enginebeat/TestBedUpgrade/photos/20170327_144511.jpg

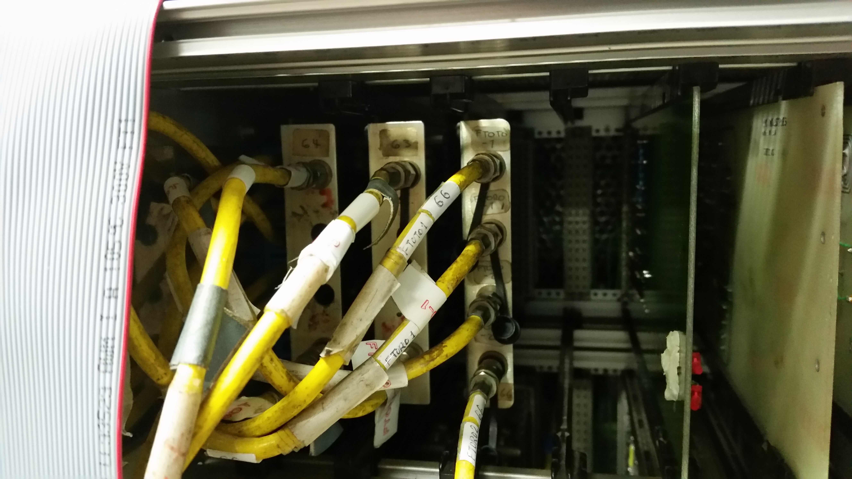
photos/20170327_144511.jpg
