enginebeat/TestBedUpgrade/photos/20170327_144552.jpg

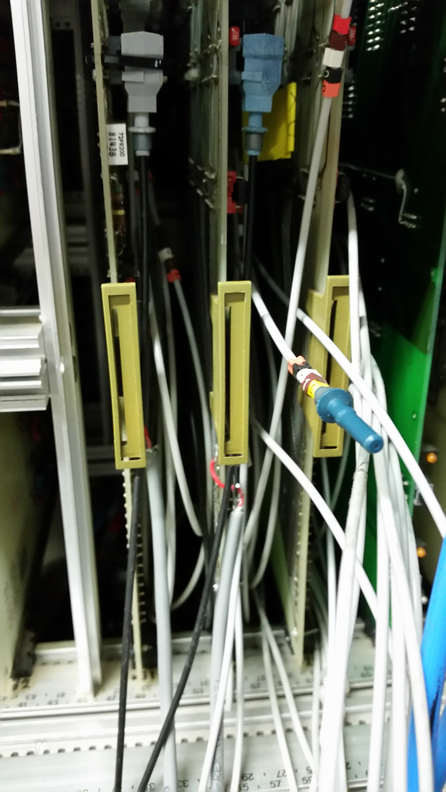
photos/20170327_144552.jpg
