enginebeat/TestBedUpgrade/Prot_unit_UNOR.docx

When powering up the protection unit's ground level electronics racks, one of the new cards got damaged by a short circuit in one of the ICs releasing some smoke. Note that this was a ELV short (24V) and as such this was not a personal safety issue or was a fire risk either.

Power to the electronics racks was turned off immediately and the
