enginebeat/TestBedUpgrade/Cards/EEL1/H85-24.pdf

## INTERNAL USE ONLY

JDN/H(85)24
Issue 1 - 17.08.87

The information contained in this document is of a nature confidential the JET project. It should not be communicated directly or indirectly to any person not identified in the warning box below or named on the distribution list at the end of the document, witout prior permission, which should be sought from the Publication Officer, JET Joint Undertaking, Abingdon, Oxon, OX14 3EA, UK

EEL1 CTS Optical Fan-out Sub-module User Guide

W Brewerton

TABLE OF CONTENTS

1. Introduction
2. Module Functions
3. Construction
4. Specification
5. Drawings

Distribution: K Fullard, SE Dorling, R Johnson, W Brewerton K1/0/40 file(s)

1. Introduction

There are 3 types of CODAS sub-module, ELE1, ELE2 for inclusion into user equipment. It is envisaged that they be used for triggering and driving local equipment from CTS signals.

2. Module Functions

The EEL1 is a quad electrical-optical converter. It has 4 independent electrical inputs which are converted to 4 optical outputs.

The optical output light emitting diodes are housed in SMA type bulkhead sockets which have to be provided with a bulkhead or front panel.

The board may be fitted with an F-connector, if desired, for all electrical connections.

3. Construction

The sub-module takes the form of a PCB 100 x 160mm. The module width is 10mm. Power and electrical input are through solder spill connections or through a F-connector, using rows b and Z, which may be mounted on the rear of the board. The optical output diodes mounted in SMA type bulkhead fittings are at the end of 200mm flying leads. These SMA type connectors must be mounted on a convenient bulkhead or front panel. The PCB is laid out in such a way that it may be cut into 4 individual channels, each one working independently.

4. Specification

Signal standards:

Optical output: CODAS type 43. Light = Logic 1
Electrical input: TTL, CODAS type 24. Logic 1 is a low voltage level CODAS type signals are specified in the CODAS handbook. section JCH 7.6

Power supply:

+5V ± 5%

5. Drawings

1729 (http://electrahost.jet.uk/elbin/docudraw?cmd=view&type=drawingdetails&drawing=1729) Component overlay

1705 (http://electrahost.jet.uk/elbin/docudraw?cmd=view&type=drawingdetails&drawing=1705) Circuit diagram

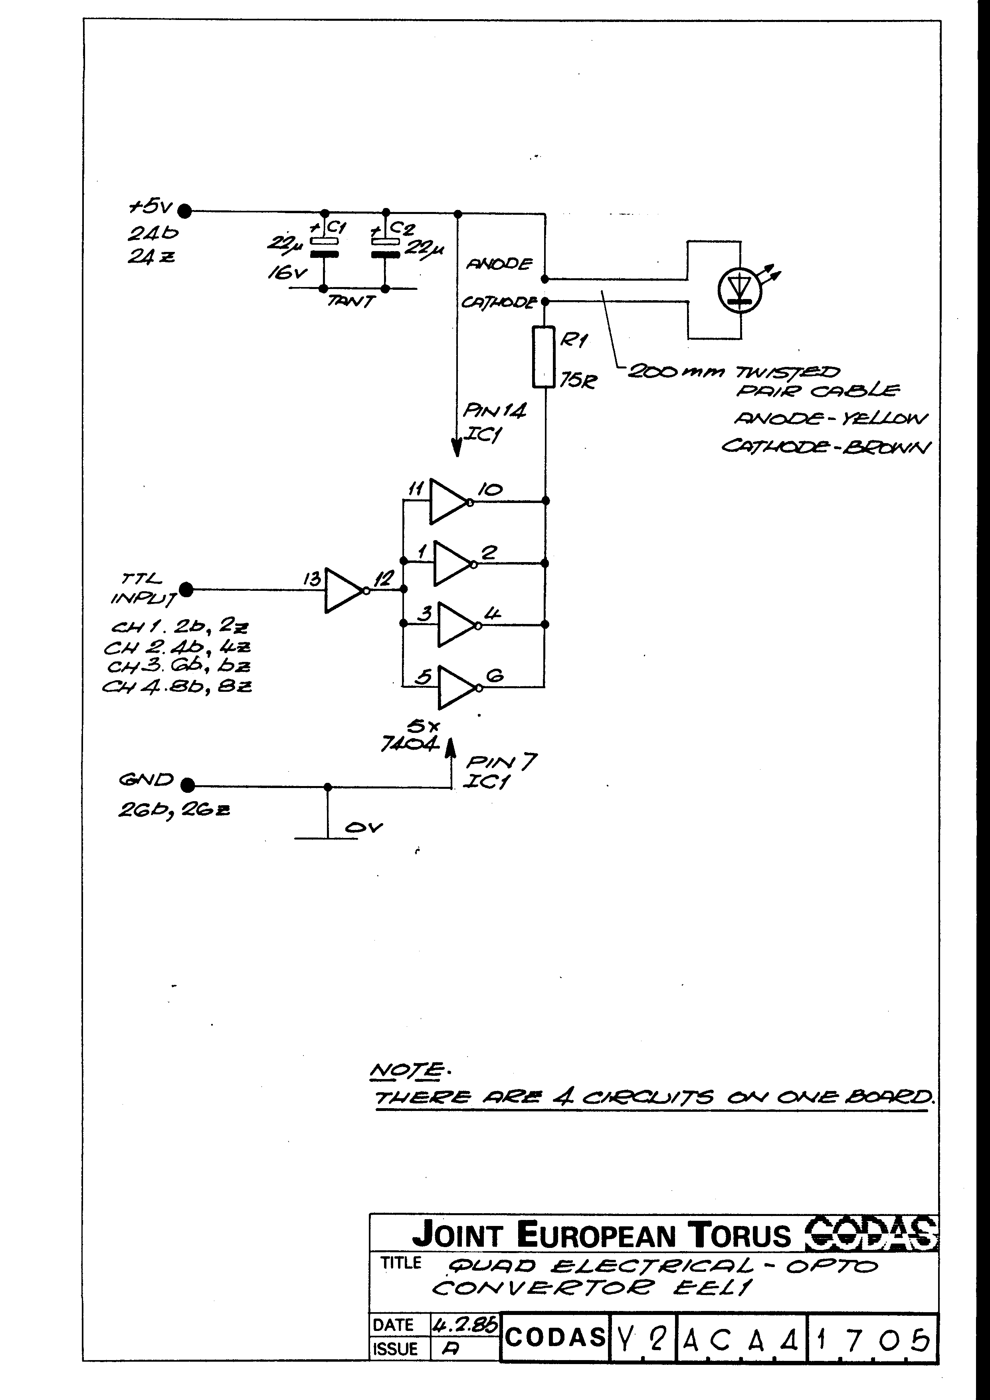
[picture p3: page 3]
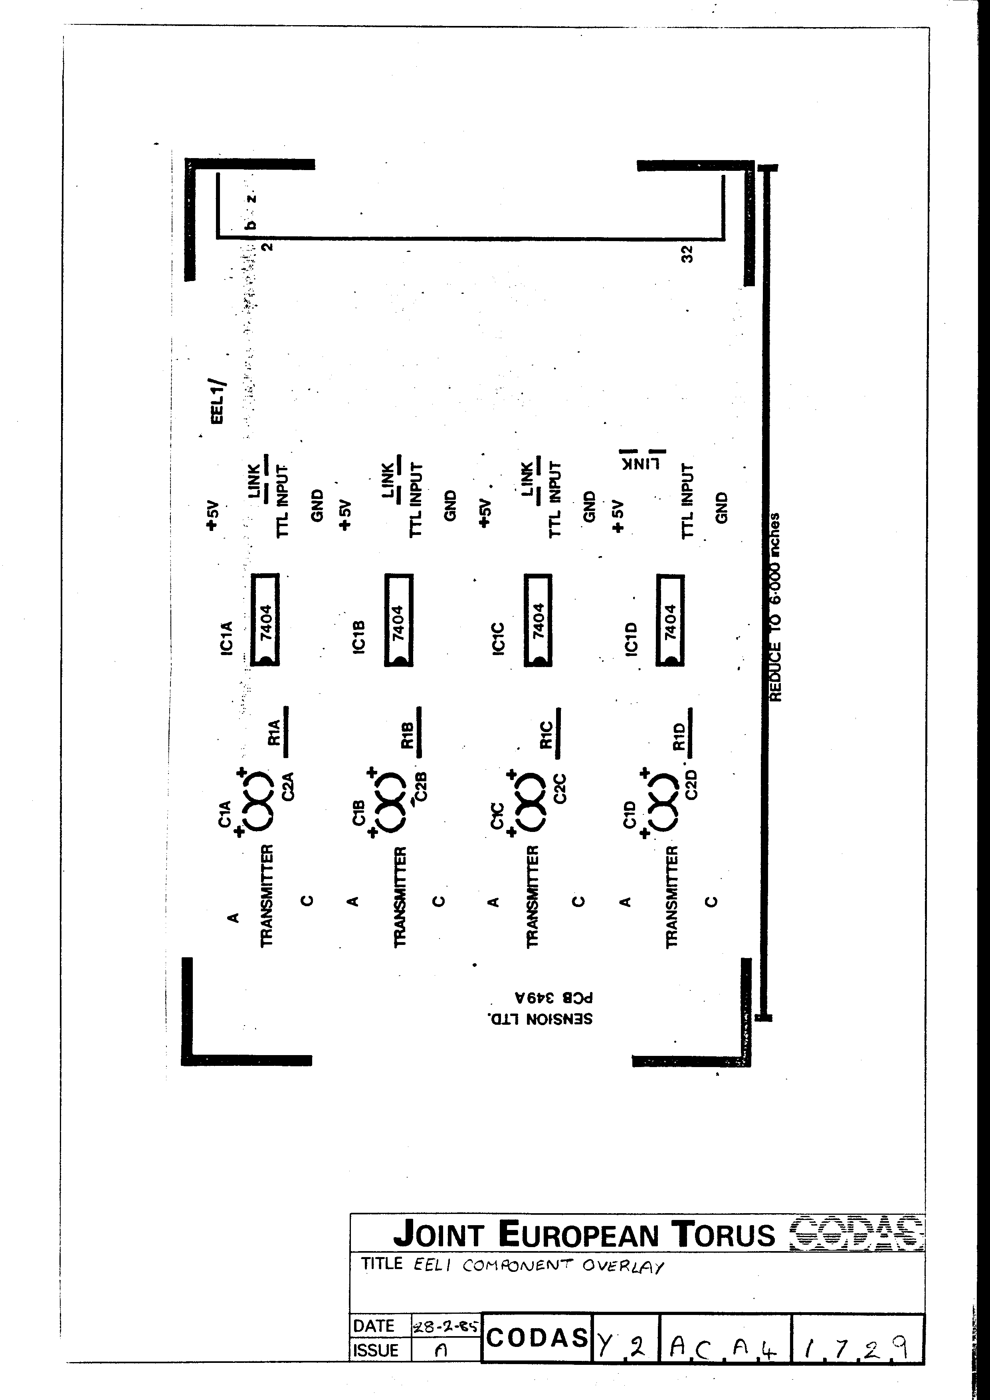
[picture p4: page 4]
