enginebeat/TestBedUpgrade/Cards/20 Channel FO Receiver - Glass.pdf

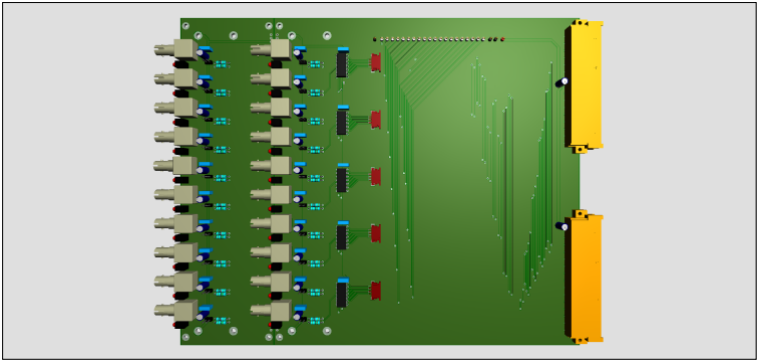
[picture p7: figure]
