enginebeat/TestBedUpgrade/Cards/20 Channel FO Receiver - Plastic.pdf

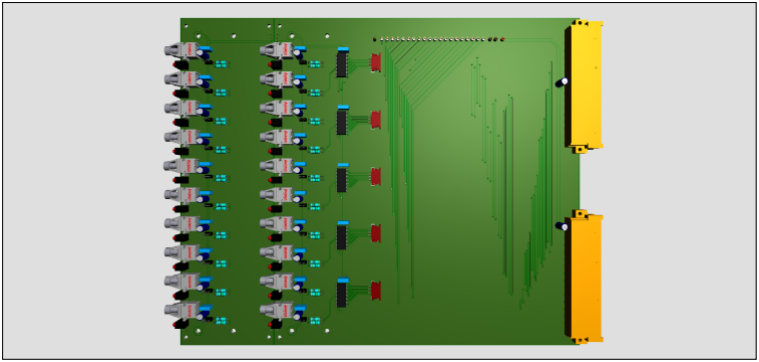
[picture p8: figure]
