enginebeat/TestBedUpgrade/Cards/20 Channel FO Transmitter - Glass.pdf

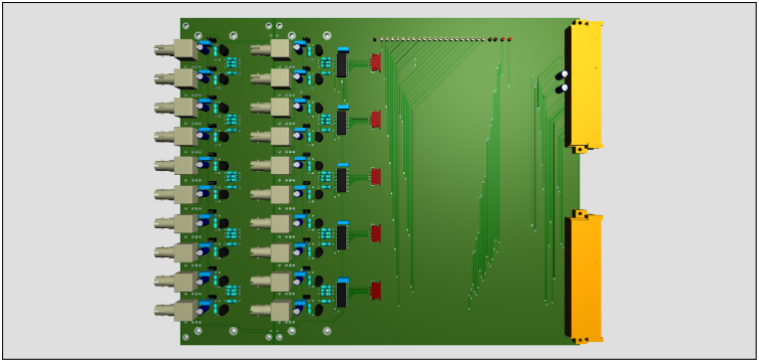
[picture p9: figure]
