enginebeat/TestBedUpgrade/Cards/20 Channel FO Transmitter - Plastic.pdf

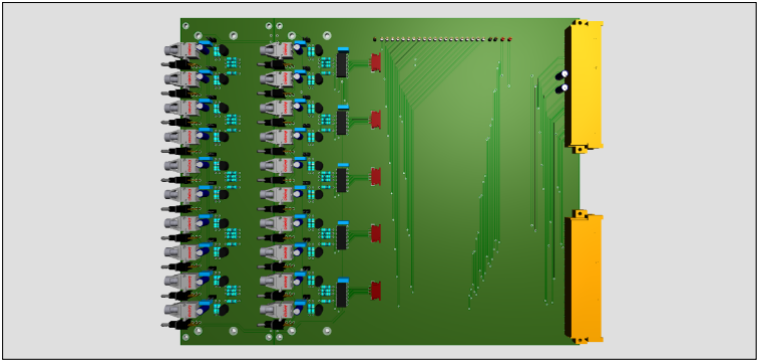
[picture p10: figure]
