enginebeat/TestBedUpgrade/CardRequirements.xls

Sheet: Overall
Card | Location | Rack | Unit | Type | Channels | Quantity | Mod
E276 | LCP | 8 |  | TX | 1 | 6 | remove IC7, remove link 1" and connect board to link 2"
E276 | Aux Deck | fil | A | TX | 1 | 1
E276 | Aux Deck | snub | A | TX | 1 | 1
E276 | Aux Deck | Arc | A | TX | 1 | 1
E276 | Aux Deck | fil | B | TX | 1 | 1
E276 | Aux Deck | snub | B | TX | 1 | 1
E276 | Aux Deck | Arc | B | TX | 1 | 1
 |  |  |  |  | Total | 12
E277 | LCP | 8 |  | RX | 1 | 6 | remove IC3, remove link 3 and connect board to link 2
E277 | Aux Deck | Fil | A | RX | 1 | 1
E277 | Aux Deck | snub | A | RX | 1 | 1
E277 | Aux Deck | Arc | A | RX | 1 | 1
E277 | Aux Deck | fil | B | RX | 1 | 1
E277 | Aux Deck | snub | B | RX | 1 | 1
E277 | Aux Deck | Arc | B | RX | 1 | 1
 |  |  |  |  | Total | 12
E284 | LCP | 2 | A | RX | 4 | 1 | remove 74LS123, connect Q and /Q to board.
E284 | LCP | 3 | B | RX | 4 | 1
E284 | Aux Deck | fil | A | RX | 2 | 1
E284 | Aux Deck | snub | A | RX | 1 | 1
E284 | Aux Deck | Arc | A | RX | 3 | 1
E284 | Aux Deck | fil | B | RX | 2 | 1
E284 | Aux Deck | snub | B | RX | 1 | 1
E284 | Aux Deck | Arc | B | RX | 3 | 1
 |  |  |  |  | Total | 8
E285 | Aux Deck | fil | A | TX | 2 | 1 | Remove IC1, remove IC7, feed from pin 9 of IC2 on all channels.
E285 | Aux Deck | snub | A | TX | 2 | 1
E285 | Aux Deck | Arc | A | TX | 2 | 1
E285 | Aux Deck | fil | B | TX | 2 | 1
E285 | Aux Deck | snub | B | TX | 2 | 1
E285 | Aux Deck | Arc | B | TX | 2 | 1
 |  |  |  |  | Total | 6
E291 | LCP | 2 | A | TX | 4 | 1 | remove IC3 & IC4, remove IC1, IC2, IC4,IC8 and connect all channels to new board.
E291 | LCP | 3 | B | TX | 4 | 1 | CH1 to CH4
E291 | Aux Deck | fil | A | TX | 1 | 1 | CH4
E291 | Aux Deck | snub | A | TX |  | 1 | Check CH
E291 | Aux Deck | Arc | A | TX | 1 | 1 | not used at present CH5
E291 | Aux Deck | fil | B | TX | 1 | 1 | CH4
E291 | Aux Deck | snub | B | TX |  | 1 | Check CH
E291 | Aux Deck | Arc | B | TX | 1 | 1 | not used at present CH5
 |  |  |  |  | Total | 8
E311 | LCP | 5 |  | TX | 1 | 2 | remove IC13, remove IC14 and connect IC15's pin 2 to new tx board.
E311 | LCP | 6 |  | TX | 1 | 2
E311 | LCP | 7 |  | TX | 1 | 2
 |  |  |  |  | Total | 6
E302 | LCP | 2 | A | RX | 2 | 1 | Needs Checking as we may have some new ones that work
E302 | LCP | 3 | B | RX | 2 | 1
E302 | LCP | 5 | Fil A/B | RX | 2 | 2
E302 | LCP | 6 | ARC A/B | RX | 2 | 2
E302 | LCP | 7 | Snub A/B | RX | 1 | 2
 |  |  |  |  | Total | 8
J101 | LCP | 2 | A | RX/TX | $1/1 | 1 | we should have some new ones
J101 | LCP | 3 | B | RX/TX | $1/1 | 1
J100 |  |  |  |  | Total | 2
J100 | Aux Deck |  | A | RX/TX | $1/1 | 1 | we should have some new ones
J100 | Aux Deck |  | B | RX/TX | $1/1 | 1
 |  |  |  |  | Total | 2

Sheet: Unit A
 |  | Unit A
Card | Location | Rack | Unit | Type | Channels | Quantity
E276 | LCP | 8 | A | TX | 1 | 3
E277 | LCP | 8 | A | RX | 1 | 3
E284 | LCP | 2 | A | RX | 4 | 1
E291 | LCP | 2 | A | TX | 4 | 1
E311 | LCP | 5 |  | TX | 1 | 1
E311 | LCP | 6 |  | TX | 1 | 1
E311 | LCP | 7 |  | TX | 1 | 1
E302 | LCP | 2 | A | RX | 2 | 1
E302 | LCP | 5 | Fil A | RX | 2 | 1
E302 | LCP | 6 | ARC A | RX | 2 | 1
E302 | LCP | 7 | Snub A | RX | 1 | 1
J101 | LCP | 2 | A | RX/TX | $1/1 | 1
E276 | Aux Deck | fil | A | TX | 1 | 1
E276 | Aux Deck | snub | A | TX | 1 | 1
E276 | Aux Deck | Arc | A | TX | 1 | 1
E277 | Aux Deck | Fil | A | RX | 1 | 1
E277 | Aux Deck | snub | A | RX | 1 | 1
E277 | Aux Deck | Arc | A | RX | 1 | 1
E284 | Aux Deck | fil | A | RX | 2 | 1
E284 | Aux Deck | snub | A | RX | 1 | 1
E284 | Aux Deck | Arc | A | RX | 3 | 1
E285 | Aux Deck | fil | A | TX | 2 | 1
E285 | Aux Deck | snub | A | TX | 2 | 1
E285 | Aux Deck | Arc | A | TX | 2 | 1
E291 | Aux Deck | fil | A | TX | 1 | 1
E291 | Aux Deck | snub | A | TX |  | 1
E291 | Aux Deck | Arc | A | TX | 1 | 1
J100 | Aux Deck |  | A | RX/TX | $1/1 | 1
E276 | 6
E277 | 6
E284 | 4
E285 | 3
E291 | 4
E311 | 3
E302 | 4
J101 | 1
J100 | 1

Sheet: Unit B
 |  | Unit B
Card | Location | Rack | Unit | Type | Channels | Quantity
E276 | LCP | 8 | B | TX | 1 | 3
E277 | LCP | 8 |  | RX | 1 | 3
E284 | LCP | 3 | B | RX | 4 | 1
E291 | LCP | 3 | B | TX | 4 | 1
E311 | LCP | 5 |  | TX | 1 | 1
E311 | LCP | 6 |  | TX | 1 | 1
E311 | LCP | 7 |  | TX | 1 | 1
E302 | LCP | 3 | B | RX | 2 | 1
E302 | LCP | 5 | Fil B | RX | 2 | 1
E302 | LCP | 6 | ARC B | RX | 2 | 1
E302 | LCP | 7 | Snub B | RX | 1 | 1
J101 | LCP | 3 | B | RX/TX | $1/1 | 1
E276 | Aux Deck | fil | B | TX | 1 | 1
E276 | Aux Deck | snub | B | TX | 1 | 1
E276 | Aux Deck | Arc | B | TX | 1 | 1
E277 | Aux Deck | fil | B | RX | 1 | 1
E277 | Aux Deck | snub | B | RX | 1 | 1
E277 | Aux Deck | Arc | B | RX | 1 | 1
E284 | Aux Deck | fil | B | RX | 2 | 1
E284 | Aux Deck | snub | B | RX | 1 | 1
E284 | Aux Deck | Arc | B | RX | 3 | 1
E285 | Aux Deck | fil | B | TX | 2 | 1
E285 | Aux Deck | snub | B | TX | 2 | 1
E285 | Aux Deck | Arc | B | TX | 2 | 1
E291 | Aux Deck | fil | B | TX | 1 | 1
E291 | Aux Deck | snub | B | TX |  | 1
E291 | Aux Deck | Arc | B | TX | 1 | 1
J100 | Aux Deck |  | B | RX/TX | $1/1 | 1
E276 | 6
E277 | 6
E284 | 4
E285 | 3
E291 | 4
E311 | 3
E302 | 4
J101 | 1
J100 | 1

Sheet: Cards
required total cards
E276 | 12
E277 | 12
E284 | 8
E285 | 6
E291 | 8
E311 | 6
E302 | 8
J101 | 2
J100 | 2

Sheet: Removed A
 |  | Unit A
Card | Type | Channels | Unit | Location | Rack | Position | Ref Number
E276 | TX | 1 | A | LCP | 8
E276 | TX | 1 | A | LCP | 8
E276 | TX | 1 | A | LCP | 8
E277 | RX | 1 | A | LCP | 8
E277 | RX | 1 | A | LCP | 8
E277 | RX | 1 | A | LCP | 8
E284 | RX | 4 | A | LCP | 2
E291 | TX | 4 | A | LCP | 2
E311 | TX | 1 | A | LCP | 5
E311 | TX | 1 | A | LCP | 6
E311 | TX | 1 | A | LCP | 7
E302 | RX | 2 | A | LCP | 2
E302 | RX | 2 | Fil A | LCP | 5
E302 | RX | 2 | ARC A | LCP | 6
E302 | RX | 1 | Snub A | LCP | 7
J101 | RX/TX | $1/1 | A | LCP | 2
E276 | TX | 1 | A | Aux Deck | fil
E276 | TX | 1 | A | Aux Deck | snub
E276 | TX | 1 | A | Aux Deck | Arc
E277 | RX | 1 | A | Aux Deck | Fil
E277 | RX | 1 | A | Aux Deck | snub
E277 | RX | 1 | A | Aux Deck | Arc
E284 | RX | 2 | A | Aux Deck | fil
E284 | RX | 1 | A | Aux Deck | snub
E284 | RX | 3 | A | Aux Deck | Arc
E285 | TX | 2 | A | Aux Deck | fil
E285 | TX | 2 | A | Aux Deck | snub
E285 | TX | 2 | A | Aux Deck | Arc
E291 | TX | 1 | A | Aux Deck | fil
E291 | TX |  | A | Aux Deck | snub
E291 | TX | 1 | A | Aux Deck | Arc
J100 | RX/TX | $1/1 | A | Aux Deck

Sheet: Removed B
 |  | Unit B
Card | Type | Channels | Unit | Location | Rack | Position | Ref Number
E276 | TX | 1 | B | LCP | 8
E276 | TX | 1 | B | LCP | 8
E276 | TX | 1 | B | LCP | 8
E277 | RX | 1 | B | LCP | 8
E277 | RX | 1 | B | LCP | 8
E277 | RX | 1 | B | LCP | 8
E284 | RX | 4 | B | LCP | 2
E291 | TX | 4 | B | LCP | 2
E311 | TX | 1 | B | LCP | 5
E311 | TX | 1 | B | LCP | 6
E311 | TX | 1 | B | LCP | 7
E302 | RX | 2 | B | LCP | 2
E302 | RX | 2 | Fil B | LCP | 5
E302 | RX | 2 | ARC B | LCP | 6
E302 | RX | 1 | Snub B | LCP | 7
J101 | RX/TX | $1/1 | B | LCP | 2
E276 | TX | 1 | B | Aux Deck | fil
E276 | TX | 1 | B | Aux Deck | snub
E276 | TX | 1 | B | Aux Deck | Arc
E277 | RX | 1 | B | Aux Deck | Fil
E277 | RX | 1 | B | Aux Deck | snub
E277 | RX | 1 | B | Aux Deck | Arc
E284 | RX | 2 | B | Aux Deck | fil
E284 | RX | 1 | B | Aux Deck | snub
E284 | RX | 3 | B | Aux Deck | Arc
E285 | TX | 2 | B | Aux Deck | fil
E285 | TX | 2 | B | Aux Deck | snub
E285 | TX | 2 | B | Aux Deck | Arc
E291 | TX | 1 | B | Aux Deck | fil
E291 | TX |  | B | Aux Deck | snub
E291 | TX | 1 | B | Aux Deck | Arc
J100 | RX/TX | $1/1 | B | Aux Deck
