enginebeat/TestBedUpgrade/Cards/E276_Old.pdf

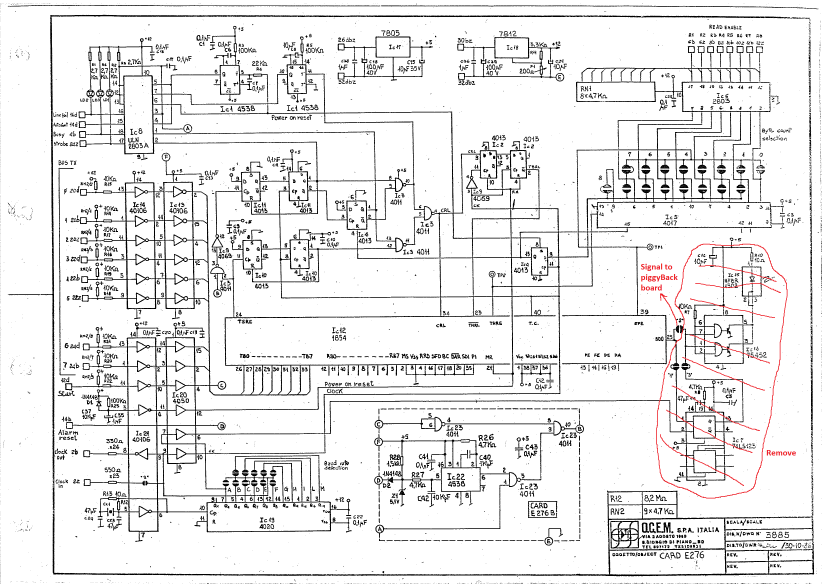
[picture p11: page 1]
