enginebeat/TestBedUpgrade/Cards/E277A_Old.pdf

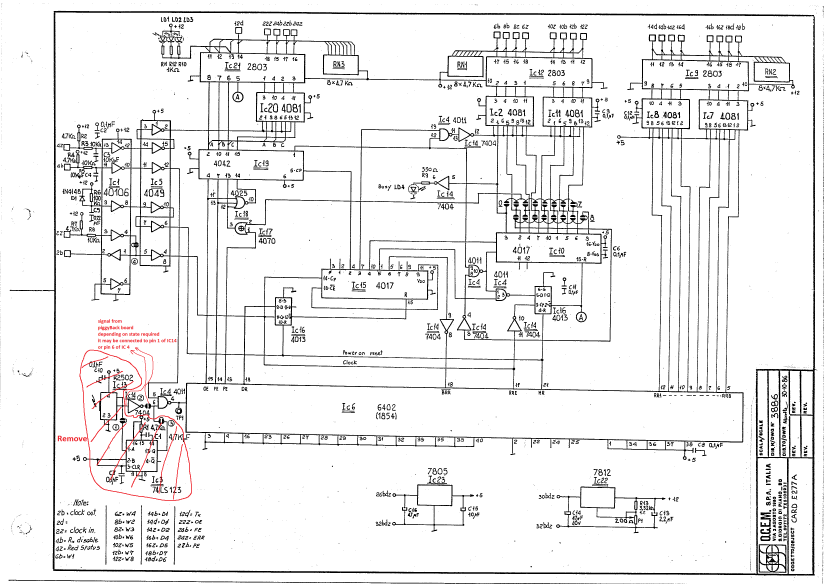
[picture p12: page 1]
