enginebeat/TestBedUpgrade/Cards/E311_ARC.TIF

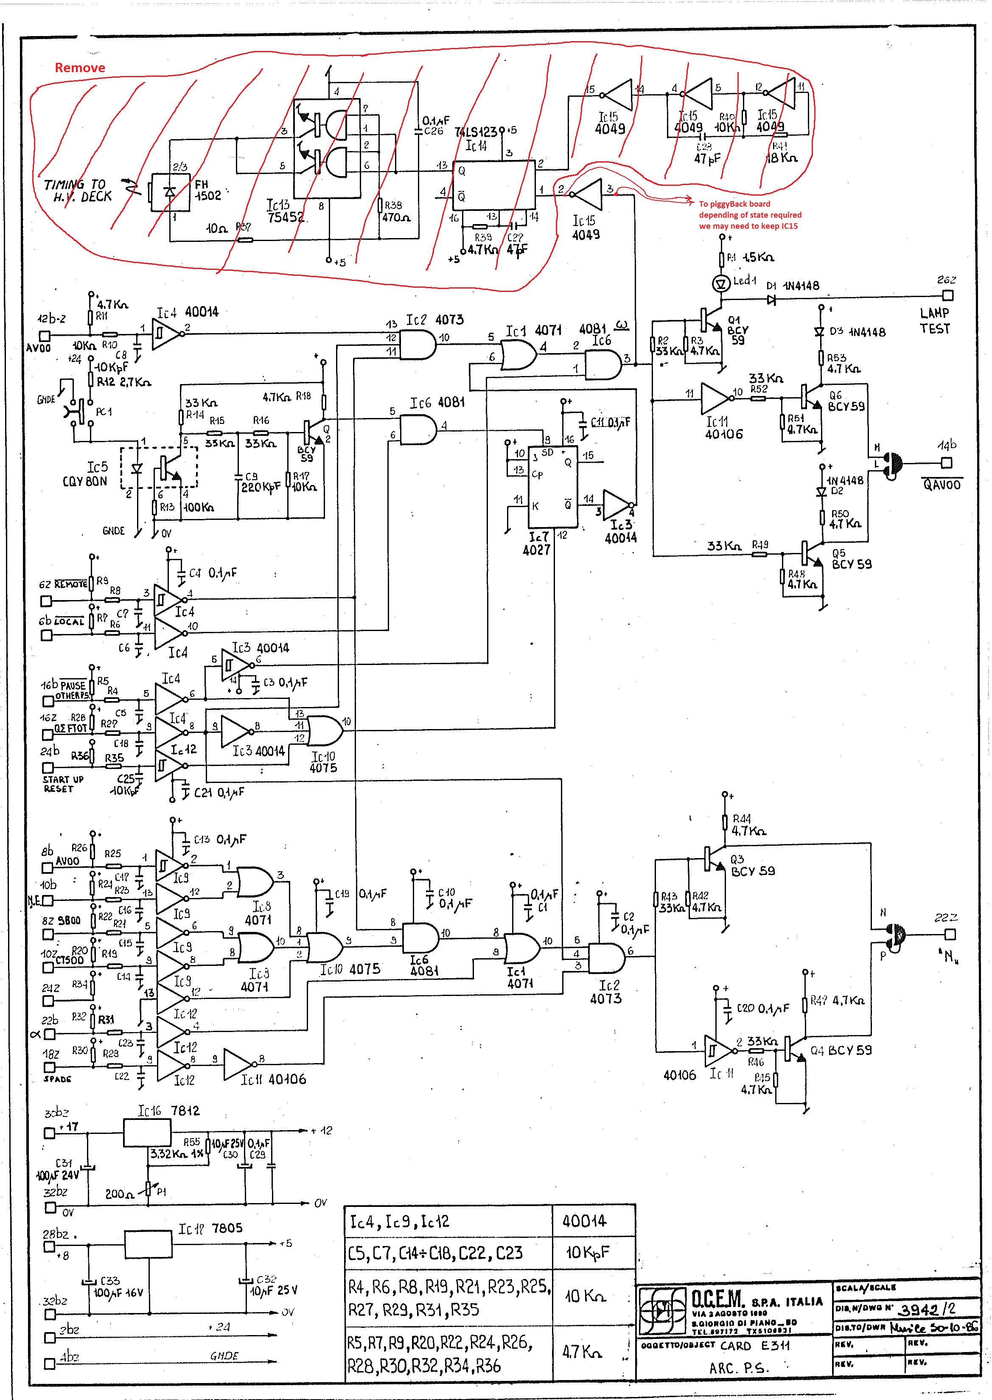
Cards/E311_ARC.TIF
