enginebeat/TestBedUpgrade/Cards/E320/frontPlate.jpg

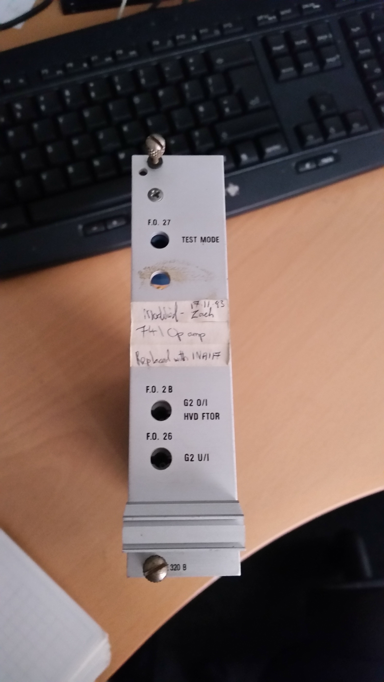
Cards/E320/frontPlate.jpg
