enginebeat/TestBedUpgrade/Cards/E320/mods.jpg

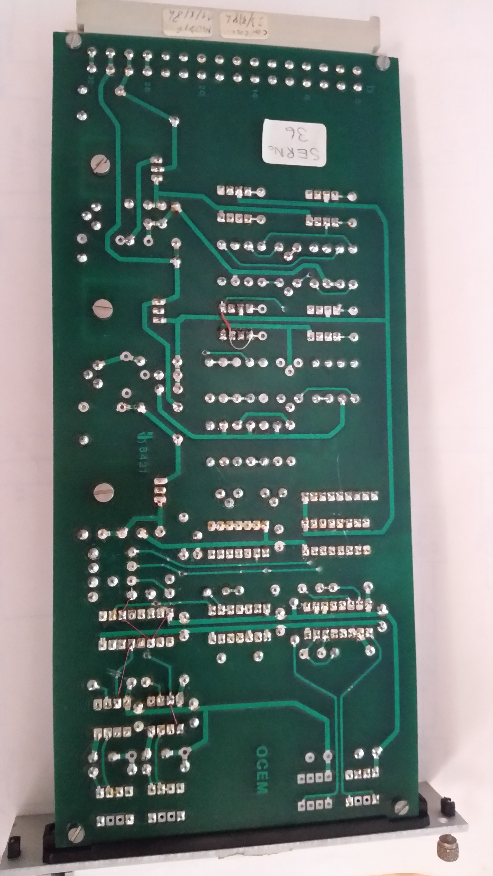
Cards/E320/mods.jpg
