enginebeat/TestBedUpgrade/Cards/images/75452_intern.png

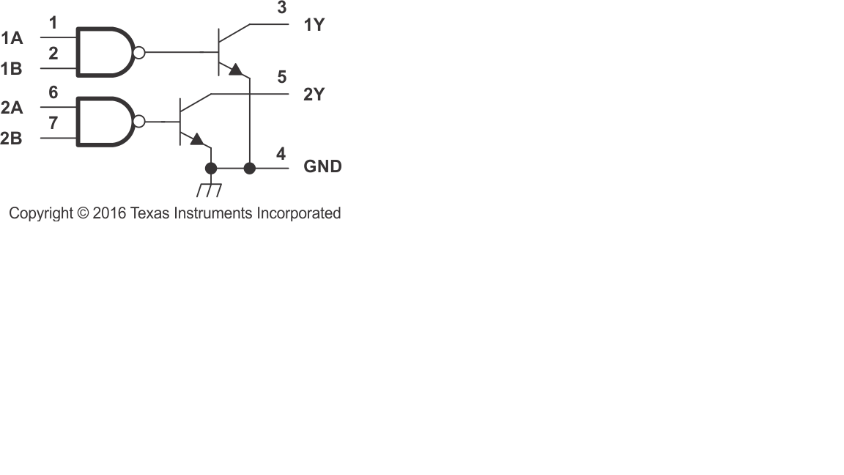
Cards/images/75452_intern.png
