enginebeat/TestBedUpgrade/photos/20170327_144520.jpg

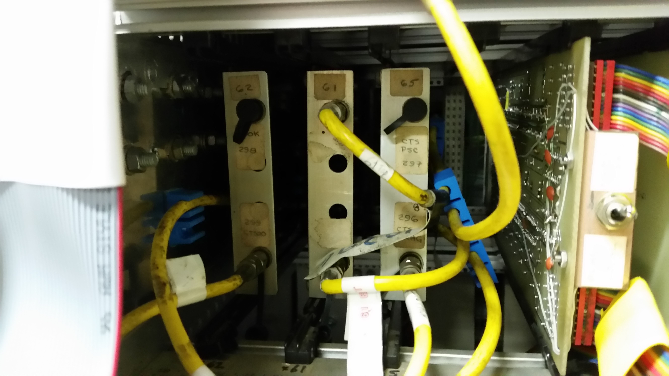
photos/20170327_144520.jpg
