enginebeat/TestBedUpgrade/photos/20170327_144530.jpg

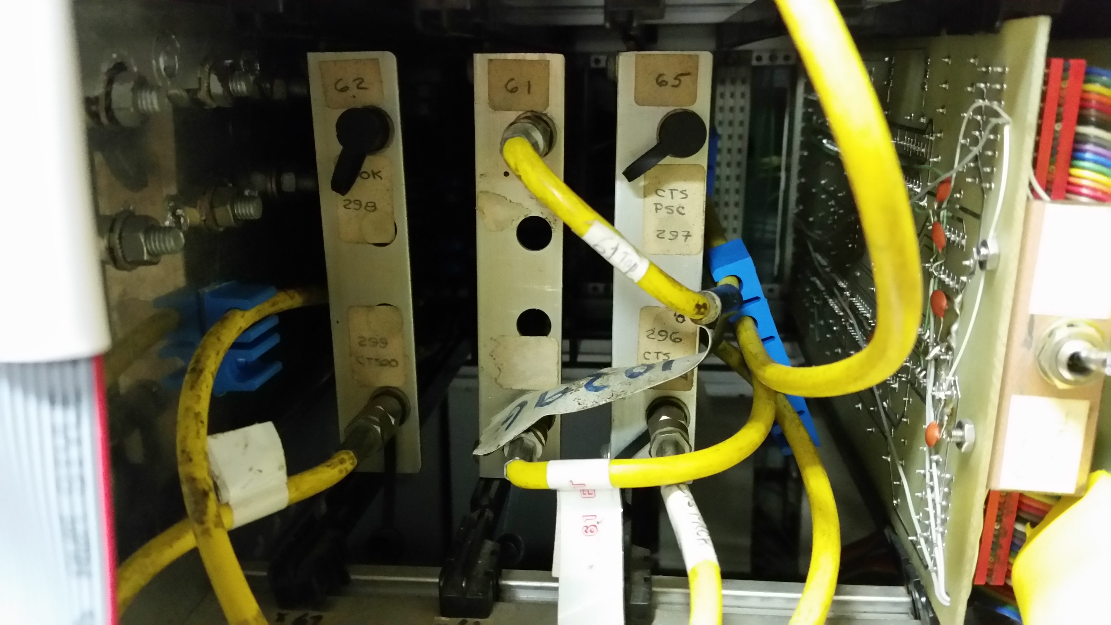
photos/20170327_144530.jpg
