enginebeat/TestBedUpgrade/photos/20170327_144611.jpg

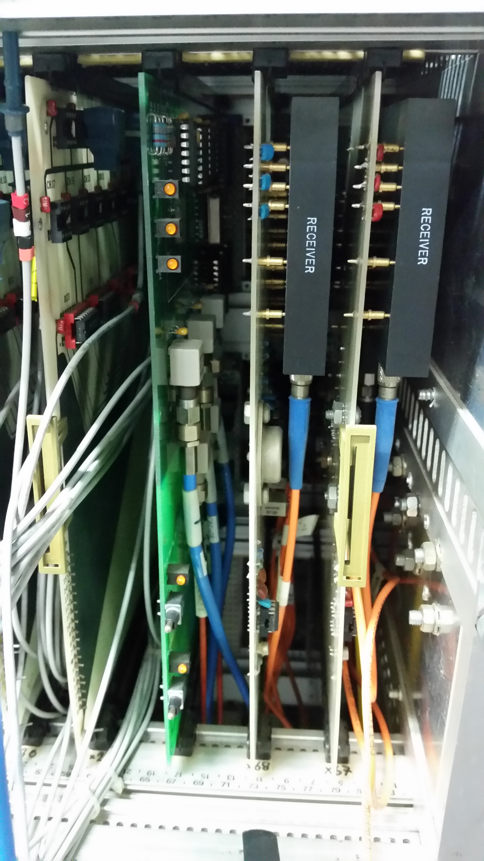
photos/20170327_144611.jpg
