enginebeat/TestBedUpgrade/FibreOp Modified Matrix 27-07-17.xlsx

Sheet: FDB Layout
 | Description | Number of fibres
FDB1 | LCP1 connections | 48
FDB2 | LCP2 connections | 48
FDB3 | Deck 1 + Deck 2 connections | 48
FDB4 | Common Deck 1 + Common Deck 2 | 32
FDB5 | Aux Deck A connections | 32
FDB6 | Aux Deck B connections | 32

Sheet: Patch Panels Ref
Location | Patch panel reference
LCP | LCP1
LCP | LCP2
Aux Deck A | ADA1
Aux Deck A | ADA1
Aux Deck B | ADB1
Aux Deck B | ADB2
prot ground level | see FDB Layout
prot HV deck 1 | HVD1
prot HV deck 2 | HVD2
prot Common deck 1 | COM1
prot Common deck 2 | COM2

Sheet: Aux Control A
Signal | Type | Card | Chan | rack | cubicle | PC | PP | Con | PP | con | PC | PP | con | PP | con | PC | Cubicle | Card | Chan
HVD A-FTORI | Input | E284 | 1 | 2 | LCP | 1 | LCP1 | 1 | FDB1 | 1 | 1 | FDB5 | 1 | ADA1 | 1 | 1 | G2 | ? | ?
HVD A-FTOTI | Input | E284 | 2 | 2 | LCP | 2 | LCP1 | 2 | FDB1 | 2 | 2 | FDB5 | 2 | ADA1 | 2 | 2 | FIL | E291 | 4
G3 A-FTOTI | Input | E284 | 3 | 2 | LCP | 3 | LCP1 | 3 | FDB1 | 3 | 3 |  |  |  |  |  | G3 | E291
G3 A-FTORI | Input | E284 | 4 | 2 | LCP | 4 | LCP1 | 4 | FDB1 | 4 | 4 |  |  |  |  |  | G3 | E291
HVD A-FTOTO | Output | E291 | 1 | 2 | LCP | 5 | LCP1 | 5 | FDB1 | 5 | 5 | FDB5 | 3 | ADA1 | 3 | 3 | FIL | E284 | 6
HVD A-FTORO | Output | E291 | 2 | 2 | LCP | 6 | LCP1 | 6 | FDB1 | 6 | 6 | FDB5 | 4 | ADA1 | 4 | 4 | ARC | E284 | 5
G3 A-FTOTO | Output | E291 | 3 | 2 | LCP | 7 | LCP1 | 7 | FDB1 | 7 | 7 |  |  |  |  |  | G3 | E284
G3 A-FTORO | Output | E291 | 4 | 2 | LCP | 8 | LCP1 | 8 | FDB1 | 8 | 8 |  |  |  |  |  | G3 | E284
Inter_ITCB-A | Input | JE101 | 1 | 2 | LCP | 9 | LCP1 | 9 | FDB1 | 9 | 9 | FDB5 | 5 | ADA1 | 5 | 5 | ARC | J100 | 1
Interrogate A | Output | JE101 | 2 | 2 | LCP | 10 | LCP1 | 10 | FDB1 | 10 | 10 | FDB5 | 6 | ADA1 | 6 | 6 | ARC | J100 | 2
FV00 A | Output | E311 | 1 | 5 | LCP | 11 | LCP1 | 11 | FDB1 | 11 | 11 | FDB5 | 7 | ADA1 | 7 | 7 | FIL | 284 | 5
AV00 A | Output | E311 | 1 | 6 | LCP | 12 | LCP1 | 12 | FDB1 | 12 | 12 | FDB5 | 8 | ADA1 | 8 | 8 | ARC | 284 | 4
SB00 A | Output | E311 | 1 | 7 | LCP | 13 | LCP1 | 31 | FDB1 | 31 | 13 | FDB5 | 9 | ADA1 | 9 | 9 | SNUB | 284 | 4
SB A TX | Output | E276 | 1 | 8 | LCP | 14 | LCP1 | 14 | FDB1 | 14 | 14 | FDB5 | 10 | ADA1 | 10 | 10 | SNUB | E277 | 1
SB A RX | Input | E277 | 1 | 8 | LCP | 15 | LCP1 | 15 | FDB1 | 15 | 15 | FDB5 | 11 | ADA1 | 11 | 11 | SNUB | E276 | 1
ARC A TX | Output | E276 | 1 | 8 | LCP | 16 | LCP1 | 16 | FDB1 | 16 | 16 | FDB5 | 12 | ADA1 | 12 | 12 | ARC | E277 | 1
ARC A RX | Input | E277 | 1 | 8 | LCP | 17 | LCP1 | 17 | FDB1 | 17 | 17 | FDB5 | 13 | ADA2 | 13 | 13 | ARC | E276 | 1
FIL A TX | Output | E276 | 1 | 8 | LCP | 18 | LCP1 | 18 | FDB1 | 18 | 18 | FDB5 | 14 | ADA2 | 14 | 14 | FIL | 277 | 1
FIL A RX | Input | E277 | 1 | 8 | LCP | 19 | LCP1 | 19 | FDB1 | 19 | 19 | FDB5 | 15 | ADA2 | 15 | 15 | FIL | 276 | 1

Sheet: Aux Control B
Signal | Type | Card | Chan | rack | cubicle | PC | PP | Con | PP | con | PC | PP | con | PP | con | PC | Cubicle | Card | Chan
HVD B-FTORI | Input | E284 | 1 | 3 | LCP | 31 | LCP2 | 1 | FDB2 | 1 |  | FDB6 | 1 | ADB1 | 1 |  |  | ? | ?
HVD B-FTOTI | Input | E284 | 2 | 3 | LCP | 32 | LCP2 | 2 | FDB2 | 2 |  | FDB6 | 2 | ADB1 | 2 |  | FIL | E291 | 4
G3 B-FTOTI | Input | E284 | 3 | 3 | LCP | 33 | LCP2 | 3 | FDB2 | 3 |  |  |  |  |  |  | G3 | E291
G3 B-FTORI | Input | E284 | 4 | 3 | LCP | 34 | LCP2 | 4 | FDB2 | 4 |  |  |  |  |  |  | G3 | E291
HVD B-FTOTO | Output | E291 | 1 | 3 | LCP | 35 | LCP2 | 5 | FDB2 | 5 |  | FDB6 | 5 | ADB1 | 5 |  | FIL | E284 | 6
HVD B-FTORO | Output | E291 | 2 | 3 | LCP | 36 | LCP2 | 6 | FDB2 | 6 |  | FDB6 | 6 | ADB1 | 6 |  | ARC | E284 | 5
G3 B-FTOTO | Output | E291 | 3 | 3 | LCP | 37 | LCP2 | 7 | FDB2 | 7 |  |  |  |  |  |  | G3 | E284
G3 B-FTORO | Output | E291 | 4 | 3 | LCP | 38 | LCP2 | 8 | FDB2 | 8 |  |  |  |  |  |  | G3 | E284
Interl_ITCB-B | Input | JE101 | 1 | 2 | LCP | 39 | LCP2 | 9 | FDB2 | 9 |  | FDB6 | 9 | ADB1 | 9 |  | ARC | J100 | 1
Interrogate-B | Output | JE101 | 2 | 2 | LCP | 40 | LCP2 | 10 | FDB2 | 10 |  | FDB6 | 10 | ADB1 | 10 |  | ARC | J100 | 2
FV00 B | Output | E311 | 1 | 5 | LCP | 41 | LCP2 | 11 | FDB2 | 11 |  | FDB6 | 11 | ADB1 | 11 |  | FIL | 284 | 5
AV00 B | Output | E311 | 1 | 6 | LCP | 42 | LCP2 | 12 | FDB2 | 12 |  | FDB6 | 12 | ADB1 | 12 |  | ARC | 284 | 4
SB00 B | Output | E311 | 1 | 7 | LCP | 43 | LCP2 | 13 | FDB2 | 13 |  | FDB6 | 13 | ADB1 | 13 |  | SNUB | 284 | 4
SB B TX | Output | E276 | 1 | 8 | LCP | 44 | LCP2 | 14 | FDB2 | 14 |  | FDB6 | 14 | ADB1 | 14 |  | SNUB | E277 | 1
SB B RX | Input | E277 | 1 | 8 | LCP | 45 | LCP2 | 15 | FDB2 | 15 |  | FDB6 | 15 | ADB1 | 15 |  | SNUB | E276 | 1
ARC B TX | Output | E276 | 1 | 8 | LCP | 46 | LCP2 | 16 | FDB2 | 16 |  | FDB6 | 16 | ADB1 | 16 |  | ARC | E277 | 1
ARC B RX | Input | E277 | 1 | 8 | LCP | 47 | LCP2 | 17 | FDB2 | 17 |  | FDB6 | 17 | ADB2 | 1 |  | ARC | E276 | 1
FIL B TX | Output | E276 | 1 | 8 | LCP | 48 | LCP2 | 18 | FDB2 | 18 |  | FDB6 | 18 | ADB2 | 2 |  | FIL | 277 | 1
FIL B RX | Input | E277 | 1 | 8 | LCP | 49 | LCP2 | 19 | FDB2 | 19 |  | FDB6 | 19 | ADB2 | 3 |  | FIL | 276 | 1

Sheet: Aux Monitor A
Signal | Type | Card | Chan | rack | cubicle | PC | PP | Con | PP | con | PC | PP | con | PP | con | PC | Cubicle | Card | Chan
G2-I 1 | Input | E312 | 1 | 2 | LCP | 20 | LCP1 | 20 | FDB1 | 20 | 20 | FDB5 | 20 | ADA1 | 16 | 16 | G2 | ? | ?
G1-I 1 | Input | E312 | 2 | 2 | LCP | 21 | LCP1 | 21 | FDB1 | 21 | 21 | FDB5 | 21 | ADA2 | 1 | 17 | SNUB | E285 | 2
FIL I A | Input | E302 | 1 | 5 | LCP | 22 | LCP1 | 22 | FDB1 | 22 | 22 | FDB5 | 22 | ADA2 | 2 | 18 | FIL | E285 | 2
Fil V A | Input | E302 | 2 | 5 | LCP | 23 | LCP1 | 23 | FDB1 | 23 | 23 | FDB5 | 23 | ADA2 | 3 | 19 | FIL | E285 | 1
ARC I A | Input | E302 | 1 | 6 | LCP | 24 | LCP1 | 24 | FDB1 | 24 | 24 | FDB5 | 24 | ADA2 | 4 | 20 | ARC | E285 | 2
ARC V A | Input | E302 | 2 | 6 | LCP | 25 | LCP1 | 25 | FDB1 | 25 | 25 | FDB5 | 25 | ADA2 | 5 | 21 | ARC | E285 | 1
Snub I A | Input | E302 | 1 | 7 | LCP | 26 | LCP1 | 26 | FDB1 | 26 | 26 | FDB5 | 26 | ADA2 | 6 | 22 | SNUB | E285 | 1

Sheet: Aux Monitor B
Signal | Type | Card | Chan | rack | cubicle | PC | PP | Con | PP | con | PC | PP | con | PP | con | PC | Cubicle | Card | Chan
G2-I 2 | Input | E312 | 1 | 3 | LCP | 50 | LCP2 | 20 | FDB2 | 20 |  | FDB6 | 20 | ADB2 | 4 |  | G2 | ? | ?
G1-I 2 | Input | E312 | 2 | 3 | LCP | 51 | LCP2 | 21 | FDB2 | 21 |  | FDB6 | 21 | ADB2 | 5 |  | SNUB | E285 | 2
FIL I B | Input | E302 | 1 | 5 | LCP | 52 | LCP2 | 22 | FDB2 | 22 |  | FDB6 | 22 | ADB2 | 6 |  | FIL | E285 | 2
Fil V B | Input | E302 | 2 | 5 | LCP | 53 | LCP2 | 23 | FDB2 | 23 |  | FDB6 | 23 | ADB2 | 7 |  | FIL | E285 | 1
ARC I B | Input | E302 | 1 | 6 | LCP | 54 | LCP2 | 24 | FDB2 | 24 |  | FDB6 | 24 | ADB2 | 8 |  | ARC | E285 | 2
ARC V B | Input | E302 | 2 | 6 | LCP | 55 | LCP2 | 25 | FDB2 | 25 |  | FDB6 | 25 | ADB2 | 9 |  | ARC | E285 | 1
Snub I B | Input | E302 | 1 | 7 | LCP | 56 | LCP2 | 26 | FDB2 | 26 |  | FDB6 | 26 | ADB2 | 10 |  | SNUB | E285 | 1

Sheet: Prot Ground
Signal | Type | Card | Chan | rack | cubicle | PC | PP | Con | PP | con | PC | Cubicle | Card | Chan
FTOTI 1-1 | Input | X63 | 1 | GND | Prot | 1 | FDB1 | 27 | LCP1 | 27 | 27 | LCP | UEL4 | 1
FTOTI 1-2 | Input | X63 | 2 | GND | Prot | 2 | FDB1 | 28 | LCP1 | 28 | 28 | LCP | UEL4 | 2
FTORI 2 | Input | X64 | 1 | GND | Prot | 3 | FDB1 | 29 | LCP1 | 29 | 29 | LCP | UEL4 | 3
FTOTI 2-2 | Input | X64 | 2 | GND | Prot | 4 | FDB1 | 30 | LCP1 | 30 | 30 | LCP | UEL4 | 4
FTOTO 1 | Output | X66 | 1 | GND | Prot | 5 | FDB1 | 32 | LCP1 | 32 | 31 | LCP | ULE3 | 1
FTORO 1 | Output | X66 | 2 | GND | Prot | 6 | FDB1 | 33 | LCP1 | 33 | 32 | LCP | ULE3 | 2
FTOTO 2 | Output | X66 | 3 | GND | Prot | 7 | FDB1 | 34 | LCP1 | 34 | 33 | LCP | ULE3 | 3
FTORO 2 | Output | X66 | 4 | GND | Prot | 8 | FDB1 | 35 | LCP1 | 35 | 34 | LCP | ULE3 | 4
FTORI 1 | Input | X61 | 1 | GND | Prot | 9 | FDB1 | 36 | LCP1 | 36 | 35 | CODAS |  | Y10296
FTOTI 2-1 | Input | X61 | 2 | GND | Prot | 10 | FDB1 | 37 | LCP1 | 37 | 36 | CODAS |  | Y10300
PDOK | Input | X62 | 1 | GND | Prot | 11 | FDB1 | 38 | LCP1 | 38 | 37 | CODAS
CTS00 | Input | X62 | 2 | GND | Prot | 12 | FDB1 | 39 | LCP1 | 39 | 38 | CODAS
CTSPSC | Input | X65 | 1 | GND | Prot | 13 | FDB1 | 40 | LCP1 | 40 | 39 | CODAS
CTSPRCHG | Input | X65 | 2 | GND | Prot | 14 | FDB1 | 41 | LCP1 | 41 | 40 | CODAS
Data 1 | Output | X31 | 1 | GND | Prot | 15 | FDB3 | 48 | HVD1 | 1 | 1 | HVD 1 | X22 | 7
/safe | Output | X31 | 7 | GND | Prot | 16 | FDB3 | 47 | HVD1 | 2 | 2 | HVD 1 | X22 | 6
/FTORI 1 | Output | X31 | 5 | GND | Prot | 17 | FDB3 | 46 | HVD1 | 3 | 3 | HVD 1 | X22 | 4
JET PLS 1 | Output | X31 | 6 | GND | Prot | 18 | FDB3 | 45 | HVD1 | 4 | 4 | HVD 1 | X22 | 5
Restart | Output | X31 | 10 | GND | Prot | 19 | FDB3 | 44 | HVD1 | 5 | 5 | HVD 1 | X22 | 8
PEN+PUL | Input | X30 | 14 | GND | Prot | 20 | FDB3 | 43 | HVD1 | 6 | 6 | HVD 1 | X23 | 13
Data | Input | X30 | 1 | GND | Prot | 21 | FDB3 | 42 | HVD1 | 7 | 7 | HVD 1 | X23 | 4
/BLK THY 1 | Input | X30 | 5 | GND | Prot | 22 | FDB3 | 41 | HVD1 | 8 | 8 | HVD 1 | X23 | 3
FTORO 1 | Input | X30 | 12 | GND | Prot | 23 | FDB3 | 40 | HVD1 | 9 | 9 | HVD 1 | X23 | 0
FTORO W/O 1 | Input | X30 | 7 | GND | Prot | 24 | FDB3 | 39 | HVD1 | 10 | 10 | HVD 1 | X23 | 7
FTOTO 1 | Input | X30 | 13 | GND | Prot | 25 | FDB3 | 38 | HVD1 | 11 | 11 | HVD 1 | X23 | 1
PS PLS 1 | Input | X30 | 9 | GND | Prot | 26 | FDB3 | 37 | HVD1 | 12 | 12 | HVD 1 | X23 | 8
30KHz Output Volts 1 | Input | X29 | 1 | GND | Prot | 27 | FDB3 | 36 | HVD1 | 13 | 13 | HVD 1 | X23 | 5
30KHz OutputAmps 1 | Input | X29 | 5 | GND | Prot | 28 | FDB3 | 35 | HVD1 | 14 | 14 | HVD 1 | X23 | 6
1MHz Output Volts 1 | Input | X67 | 1 | GND | Prot | 29 | FDB3 | 34 | HVD1 | 15 | 15 | HVD 1 | X21 | 1
1MHz Output Amps 1 | Input | X67 | 2 | GND | Prot | 30 | FDB3 | 33 | HVD1 | 16 | 16 | HVD 1 | X21 | 2
/HVPS OFF 1 | Input | X29 | 8 | GND | Prot | 31 | FDB4 | 17 | COM1 | 1 | 1 | COM1 | X16 | 5
RST CBR 1 | Output | X31 | 4 | GND | Prot | 32 | FDB4 | 18 | COM1 | 2 | 2 | COM1 | X11 | 1
CBR Fired 1 | Input | X30 | 3 | GND | Prot | 33 | FDB4 | 19 | COM1 | 3 | 3 | COM1 | X16 | 1
30KHz Input V 1 | Input | X29 | 3 | GND | Prot | 34 | FDB4 | 20 | COM1 | 4 | 4 | COM1 | X16 | 4
1MHz Input V 1 | Input | X67 | 1 | GND | Prot | 35 | FDB4 | 21 | COM1 | 5 | 5 | COM1 | X16 | 0
RST CBR 2 | Output | X31 | 3 | GND | Prot | 36 | FDB4 | 1 | COM2 | 25 | 25 | COM2 | X11 | 1
CBR Fired 2 | Input | X30 | 2 | GND | Prot | 37 | FDB4 | 2 | COM2 | 26 | 26 | COM2 | X16 | 1
30KHz Input V 2 | Input | X29 | 2 | GND | Prot | 38 | FDB4 | 3 | COM2 | 27 | 27 | COM2 | X16 | 4
1MHz Input V 2 | Input | X68 | 1 | GND | Prot | 39 | FDB4 | 4 | COM2 | 28 | 28 | COM2 | X16 | 0
/HVPS OFF 2 | Input | X29 | 7 | GND | Prot | 40 | FDB4 | 5 | COM2 | 29 | 29 | COM2 | X16 | 5
Data 2 | Output | X31 | 0 | GND | Prot | 41 | FDB3 | 1 | HVD2 | 1 | 1 | HVD2 | X22 | 7
/Safe | Output | X31 | 2 | GND | Prot | 42 | FDB3 | 2 | HVD2 | 2 | 2 | HVD2 | X22 | 6
/FTORI 2 | Output | X31 | 8 | GND | Prot | 43 | FDB3 | 3 | HVD2 | 3 | 3 | HVD2 | X22 | 4
JET PLS 2 | Output | X31 | 9 | GND | Prot | 44 | FDB3 | 4 | HVD2 | 4 | 4 | HVD2 | X22 | 5
Restart | Output | X31 | 11 | GND | Prot | 45 | FDB3 | 5 | HVD2 | 5 | 5 | HVD2 | X22 | 8
Data 2 | Input | X30 | 0 | GND | Prot | 46 | FDB3 | 6 | HVD2 | 7 | 6 | HVD2 | X23 | 4
/BLK THY 2 | Input | X30 | 4 | GND | Prot | 47 | FDB3 | 7 | HVD2 | 8 | 7 | HVD2 | X23 | 3
FTORO 2 | Input | X30 | 10 | GND | Prot | 48 | FDB3 | 8 | HVD2 | 9 | 8 | HVD2 | X23 | 0
FTORO W/O 2 | Input | X30 | 6 | GND | Prot | 49 | FDB3 | 9 | HVD2 | 10 | 9 | HVD2 | X23 | 7
FTOTO 2 | Input | X30 | 11 | GND | Prot | 50 | FDB3 | 10 | HVD2 | 11 | 10 | HVD2 | X23 | 1
PS PLS 2 | Input | X30 | 8 | GND | Prot | 51 | FDB3 | 11 | HVD2 | 12 | 11 | HVD2 | X23 | 8
30KHz Output Volts 2 | Input | X29 | 0 | GND | Prot | 52 | FDB3 | 12 | HVD2 | 13 | 12 | HVD2 | X23 | 5
30KHz OutputAmps 2 | Input | X29 | 4 | GND | Prot | 53 | FDB3 | 13 | HVD2 | 14 | 13 | HVD2 | X23 | 6
1MHz Output Volts 2 | Input | X67 | 0 | GND | Prot | 54 | FDB3 | 14 | HVD2 | 15 | 14 | HVD2 | X21 | 1
1MHz Output Amps 2 | Input | X67 | 2 | GND | Prot | 55 | FDB3 | 15 | HVD2 | 16 | 15 | HVD2 | X21 | 2

Sheet: Prot HVD1
Signal | Type | Card | Chan | rack | cubicle | PC | PP | Con | PP | con | PC | Cubicle | Rack | Card | Chan
Data 1 | Input | X22 | 7 | HVD1 | Prot | 1 | HVD1 | 1 | FDB3 | 48 | 15 | Prot | GND | X31 | 1
/safe | Input | X22 | 6 | HVD1 | Prot | 2 | HVD1 | 2 | FDB3 | 47 | 16 | Prot | GND | X31 | 7
/FTORI 1 | Input | X22 | 4 | HVD1 | Prot | 3 | HVD1 | 3 | FDB3 | 46 | 17 | Prot | GND | X31 | 5
JET PLS 1 | Input | X22 | 5 | HVD1 | Prot | 4 | HVD1 | 4 | FDB3 | 45 | 18 | Prot | GND | X31 | 6
Restart | Input | X22 | 8 | HVD1 | Prot | 5 | HVD1 | 5 | FDB3 | 44 | 19 | Prot | GND | X31 | 10
PEN+PUL | Output | X23 | 13 | HVD1 | Prot | 6 | HVD1 | 6 | FDB3 | 43 | 20 | Prot | GND | X30 | 14
Data 1 | Output | X23 | 4 | HVD1 | Prot | 7 | HVD1 | 7 | FDB3 | 42 | 21 | Prot | GND | X30 | 1
/BLK THY 1 | Output | X23 | 3 | HVD1 | Prot | 8 | HVD1 | 8 | FDB3 | 41 | 22 | Prot | GND | X30 | 5
FTORO 1 | Output | X23 | 0 | HVD1 | Prot | 9 | HVD1 | 9 | FDB3 | 40 | 23 | Prot | GND | X30 | 12
FTORO W/O 1 | Output | X23 | 7 | HVD1 | Prot | 10 | HVD1 | 10 | FDB3 | 39 | 24 | Prot | GND | X30 | 7
FTOTO 1 | Output | X23 | 1 | HVD1 | Prot | 11 | HVD1 | 11 | FDB3 | 38 | 25 | Prot | GND | X30 | 13
PS PLS 1 | Output | X23 | 8 | HVD1 | Prot | 12 | HVD1 | 12 | FDB3 | 37 | 26 | Prot | GND | X30 | 9
30KHz Output Volts 1 | Output | X23 | 5 | HVD1 | Prot | 13 | HVD1 | 13 | FDB3 | 36 | 27 | Prot | GND | X29 | 1
30KHz OutputAmps 1 | Output | X23 | 6 | HVD1 | Prot | 14 | HVD1 | 14 | FDB3 | 35 | 28 | Prot | GND | X29 | 5
1MHz Output Volts 1 | Output | X21 | 1 | HVD1 | Prot | 15 | HVD1 | 15 | FDB3 | 34 | 29 | Prot | GND | X67 | 1
1MHz Output Amps 1 | Output | X21 | 0 | HVD1 | Prot | 16 | HVD1 | 16 | FDB3 | 33 | 30 | Prot | GND | X67 | 2
DFC2CLK | Input | X22 | 13 | HVD1 | Prot | 25 | HVD1 | 25 | HVD2 | 25 | 25 | Prot | HVD 2 | X23 | 13
U25-2 | Input | X22 | 12 | HVD1 | Prot | 26 | HVD1 | 26 | HVD2 | 26 | 26 | Prot | HVD 2 | X23 | 12
U25-1 | Input | X22 | 11 | HVD1 | Prot | 27 | HVD1 | 27 | HVD2 | 27 | 27 | Prot | HVD 2 | X23 | 11
U25-0 | Input | X22 | 10 | HVD1 | Prot | 28 | HVD1 | 28 | HVD2 | 28 | 28 | Prot | HVD 2 | X23 | 10
EOF | Output | X23 | 9 | HVD1 | Prot | 29 | HVD1 | 29 | HVD2 | 29 | 29 | Prot | HVD 2 | X22 | 0
CBR TRIG OK | Input | X22 | 9 | HVD1 | Prot | 39 | HVD1 | 39 | COM1 | 1 | 1 | Prot | COM1 | X16 | 12
CBR OK | Input | X22 | 2 | HVD1 | Prot | 40 | HVD1 | 40 | COM1 | 2 | 2 | Prot | COM1 | X16 | 0
/HVPS O/V | Input | X22 | 3 | HVD1 | Prot | 41 | HVD1 | 41 | COM1 | 3 | 3 | Prot | COM1 | X16 | 3
TUBE DROP | Input | X22 | 1 | HVD1 | Prot | 42 | HVD1 | 42 | COM1 | 4 | 4 | Prot | COM1 | X16 | 2
/FIRE CBR | Output | X23 | 2 | HVD1 | Prot | 43 | HVD1 | 43 | COM1 | 5 | 5 | Prot | COM1 | X11 | 0

Sheet: Prot HVD2
Signal | Type | Card | Chan | rack | cubicle | PC | PP | Con | PP | con | PC | Cubicle | Rack | Card | Chan
Data 2 | Input | X22 | 7 | HVD2 | Prot | 1 | HVD2 | 1 | FDB3 | 1 | 41 | Prot | GND | X31 | 1
/Safe | Input | X22 | 6 | HVD2 | Prot | 2 | HVD2 | 2 | FDB3 | 2 | 42 | Prot | GND | X31 | 7
/FTORI 2 | Input | X22 | 4 | HVD2 | Prot | 3 | HVD2 | 3 | FDB3 | 3 | 43 | Prot | GND | X31 | 5
JET PLS 2 | Input | X22 | 5 | HVD2 | Prot | 4 | HVD2 | 4 | FDB3 | 4 | 44 | Prot | GND | X31 | 6
Restart | Input | X22 | 8 | HVD2 | Prot | 5 | HVD2 | 5 | FDB3 | 5 | 45 | Prot | GND | X31 | 10
Data 2 | Output | X23 | 4 | HVD2 | Prot | 6 | HVD2 | 6 | FDB3 | 6 | 46 | Prot | GND | X30 | 14
/BLK THY 2 | Output | X23 | 3 | HVD2 | Prot | 7 | HVD2 | 7 | FDB3 | 7 | 47 | Prot | GND | X30 | 1
FTORO 2 | Output | X23 | 0 | HVD2 | Prot | 8 | HVD2 | 8 | FDB3 | 8 | 48 | Prot | GND | X30 | 5
FTORO W/O 2 | Output | X23 | 7 | HVD2 | Prot | 9 | HVD2 | 9 | FDB3 | 9 | 49 | Prot | GND | X30 | 12
FTOTO 2 | Output | X23 | 1 | HVD2 | Prot | 10 | HVD2 | 10 | FDB3 | 10 | 50 | Prot | GND | X30 | 7
PS PLS 2 | Output | X23 | 8 | HVD2 | Prot | 11 | HVD2 | 11 | FDB3 | 11 | 51 | Prot | GND | X30 | 13
30KHz Output Volts 2 | Output | X23 | 5 | HVD2 | Prot | 12 | HVD2 | 12 | FDB3 | 12 | 52 | Prot | GND | X30 | 9
30KHz OutputAmps 2 | Output | X23 | 6 | HVD2 | Prot | 13 | HVD2 | 13 | FDB3 | 13 | 53 | Prot | GND | X29 | 1
1MHz Output Volts 2 | Output | X21 | 1 | HVD2 | Prot | 14 | HVD2 | 14 | FDB3 | 14 | 54 | Prot | GND | X29 | 5
1MHz Output Amps 2 | Output | X21 | 0 | HVD2 | Prot | 15 | HVD2 | 15 | FDB3 | 15 | 55 | Prot | GND | X67 | 1
DFC2CLK | Output | X23 | 13 | HVD2 | Prot | 25 | HVD2 | 25 | HVD1 | 25 | 25 | Prot | HVD 1 | X22 | 13
STATE-2 (U25-2) | Output | X23 | 12 | HVD2 | Prot | 26 | HVD2 | 26 | HVD1 | 26 | 26 | Prot | HVD 1 | X22 | 12
STATE-1 (U25-1) | Output | X23 | 11 | HVD2 | Prot | 27 | HVD2 | 27 | HVD1 | 27 | 27 | Prot | HVD 1 | X22 | 11
STATE-0 (U25-0) | Output | X23 | 10 | HVD2 | Prot | 28 | HVD2 | 28 | HVD1 | 28 | 28 | Prot | HVD 1 | X22 | 10
EOF | Input | X22 | 0 | HVD2 | Prot | 29 | HVD2 | 29 | HVD1 | 29 | 29 | Prot | HVD 1 | X22 | 9
CBR TRIG OK | Input | X22 | 9 | HVD2 | Prot | 39 | HVD1 | 39 | COM2 | 1 | 1 | Prot | COM2 | X16 | 12
CBR OK | Input | X22 | 2 | HVD2 | Prot | 40 | HVD1 | 40 | COM2 | 2 | 2 | Prot | COM2 | X16 | 0
/HVPS O/V | Input | X22 | 3 | HVD2 | Prot | 41 | HVD1 | 41 | COM2 | 3 | 3 | Prot | COM2 | X16 | 3
TUBE DROP | Input | X22 | 1 | HVD2 | Prot | 42 | HVD1 | 42 | COM2 | 4 | 4 | Prot | COM2 | X16 | 2
/FIRE CBR | Output | X23 | 2 | HVD2 | Prot | 43 | HVD1 | 43 | COM2 | 5 | 5 | Prot | COM2 | X11 | 0

Sheet: Prot common1
Signal | Type | Card | Chan | rack | cubicle | PC | PP | Con | PP | con | PC | Cubicle | Rack | Card | Chan
/HVPS OFF 1 | Output | X16 | 5 | COM1 | Prot | 1 | COM1 | 1 | FDB4 | 17 | 17 | Prot | GND | X29 | 8
RST CBR 1 | Input | X11 | 1 | COM1 | Prot | 2 | COM1 | 2 | FDB4 | 18 | 18 | Prot | GND | X31 | 4
CBR Fired 1 | Output | X16 | 1 | COM1 | Prot | 3 | COM1 | 3 | FDB4 | 19 | 19 | Prot | GND | X30 | 3
30KHz Input V 1 | Output | X16 | 4 | COM1 | Prot | 4 | COM1 | 4 | FDB4 | 20 | 20 | Prot | GND | X29 | 3
1MHz Input V 1 | Output | X16 | 0 | COM1 | Prot | 5 | COM1 | 5 | FDB4 | 21 | 21 | Prot | GND | X67 | 1
CBR TRIG OK | Output | X16 | 12 | COM1 | Prot | 25 | COM1 | 25 | HVD1 | 48 | 48 | Prot | HVD1 | X22 | 9
Interlocks OK (CBR OK) | Output | X16 | 0 | COM1 | Prot | 26 | COM1 | 26 | HVD1 | 47 | 47 | Prot | HVD1 | X22 | 2
/HVPS O/V | Output | X16 | 3 | COM1 | Prot | 27 | COM1 | 27 | HVD1 | 46 | 46 | Prot | HVD1 | X22 | 3
TUBE DROP | Output | X16 | 2 | COM1 | Prot | 28 | COM1 | 28 | HVD1 | 45 | 45 | Prot | HVD1 | X22 | 1
Trigger hold off(/FIRE CBR) | Input | X11 | 0 | COM1 | Prot | 29 | COM1 | 29 | HVD1 | 44 | 44 | Prot | HVD1 | X23 | 2

Sheet: Prot Common2
Signal | Type | Card | Chan | rack | cubicle | PC | PP | Con | PP | con | PC | Cubicle | Rack | Card | Chan
RST CBR 2 | Input | X11 | 1 | COM2 | Prot | 25 | COM2 | 25 | FDB4 | 1 | 1 | Prot | GND | X31 | 3
CBR Fired 2 | Output | X16 | 1 | COM2 | Prot | 26 | COM2 | 26 | FDB4 | 2 | 2 | Prot | GND | X30 | 2
30KHz Input V 2 | Output | X16 | 4 | COM2 | Prot | 27 | COM2 | 27 | FDB4 | 3 | 3 | Prot | GND | X29 | 2
1MHz Input V 2 | Output | X16 | 0 | COM2 | Prot | 28 | COM2 | 28 | FDB4 | 4 | 4 | Prot | GND | X68 | 1
/HVPS OFF 2 | Output | X16 | 5 | COM2 | Prot | 29 | COM2 | 29 | FDB4 | 5 | 5 | Prot | GND | X29 | 7
CBR TRIG OK | Output | X16 | 12 | COM2 | Prot | 1 | COM2 | 1 | HVD2 | 39 | 39 | Prot | HVD2 | X22 | 9
Interlocks OK (CBR OK) | Output | X16 | 0 | COM2 | Prot | 2 | COM2 | 2 | HVD2 | 40 | 40 | Prot | HVD2 | X22 | 2
/HVPS O/V | Output | X16 | 3 | COM2 | Prot | 3 | COM2 | 3 | HVD2 | 41 | 41 | Prot | HVD2 | X22 | 3
TUBE DROP | Output | X16 | 2 | COM2 | Prot | 4 | COM2 | 4 | HVD2 | 42 | 42 | Prot | HVD2 | X22 | 1
Trigger hold off(/FIRE CBR) | Input | X11 | 0 | COM2 | Prot | 5 | COM2 | 5 | HVD2 | 43 | 43 | Prot | HVD2 | X23 | 2
