enginebeat/TestBedUpgrade/CODAS/2277.pdf

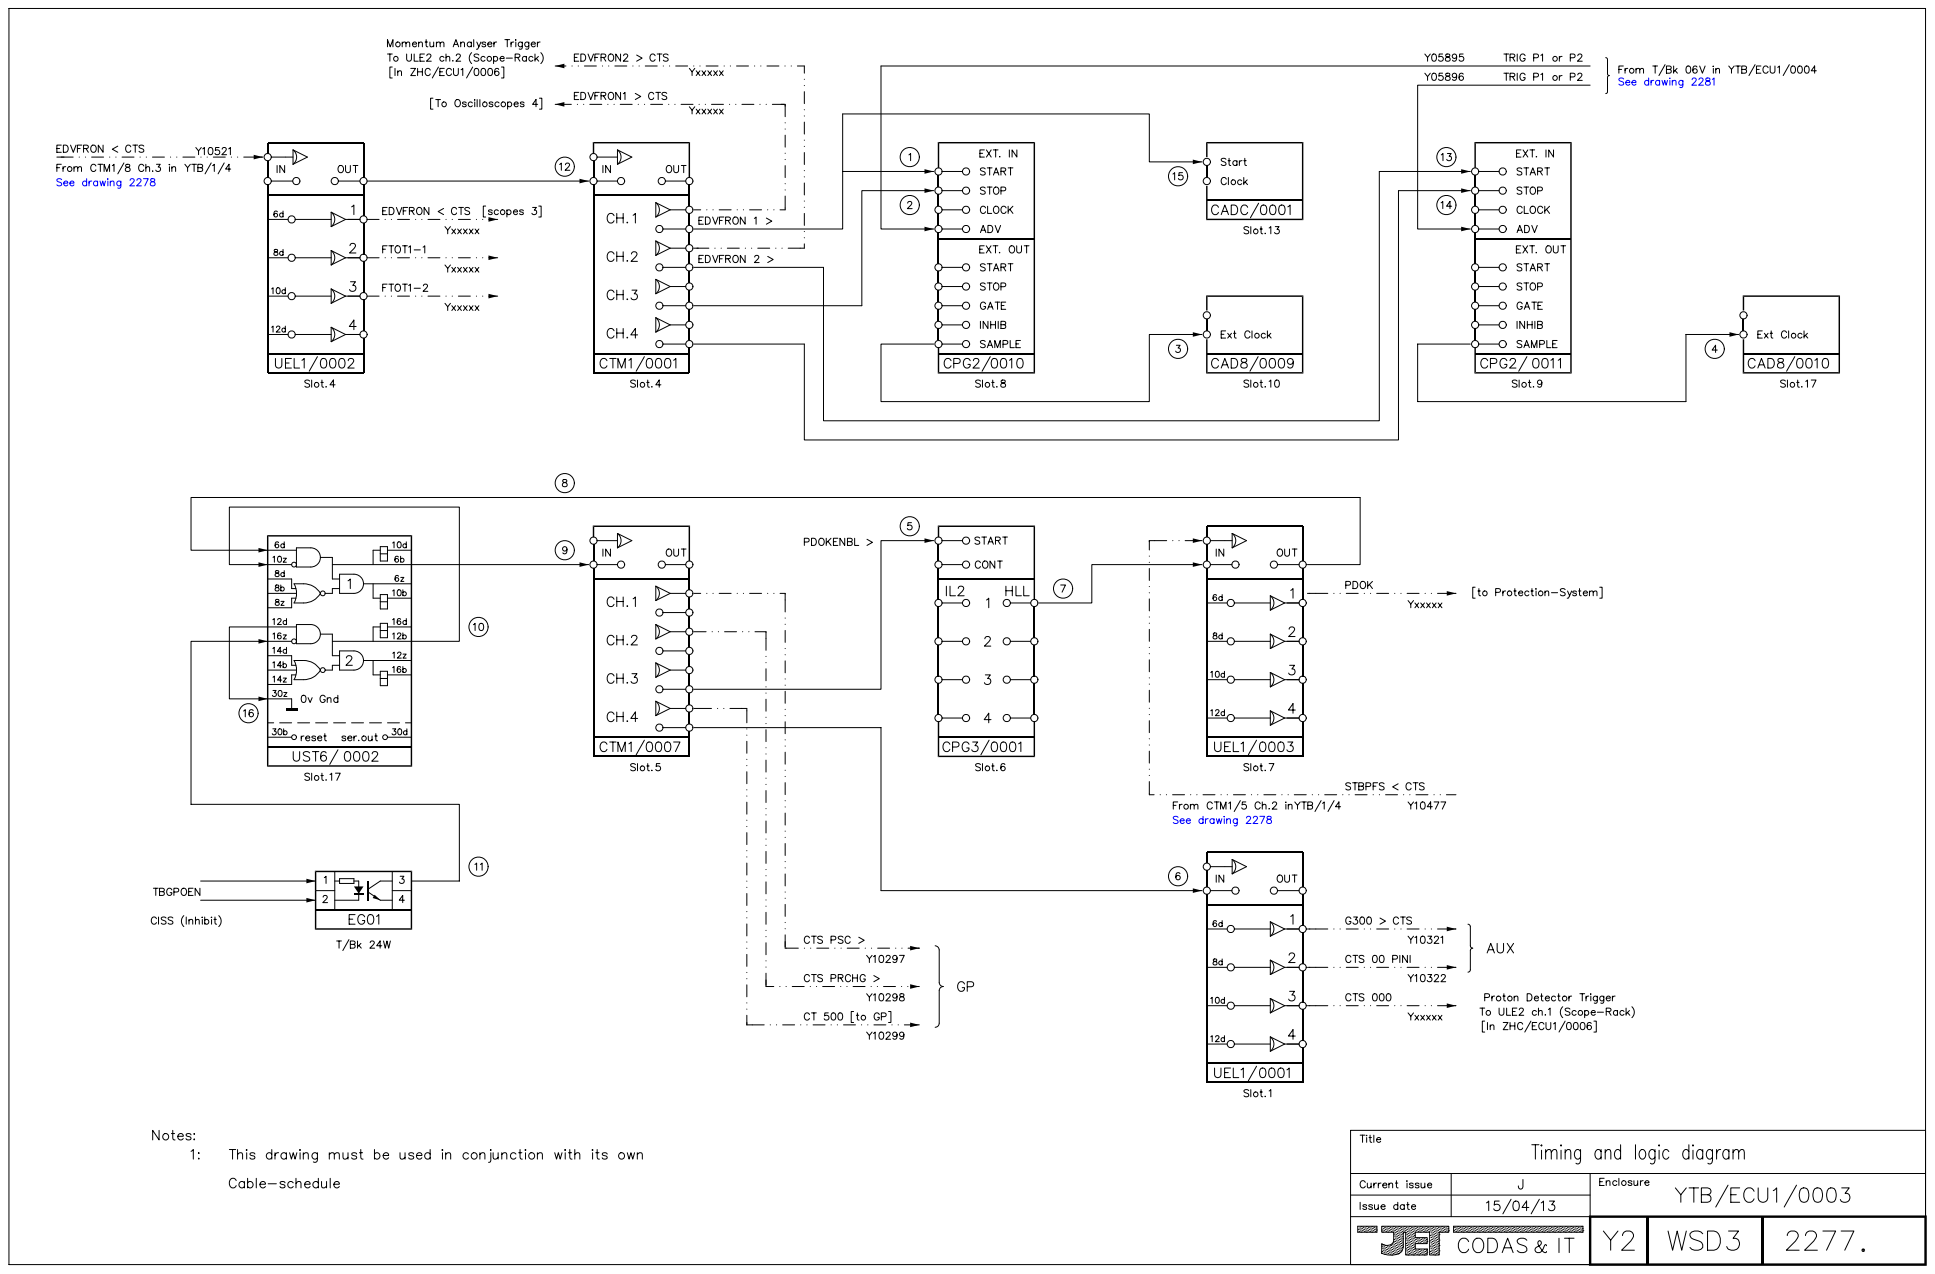
[picture p20: page 1]
0v Gnd 30z; CISS (Inhibit); EXT. OUT; EXT. IN; EDVFRON < CTS; [scopes 3]; EDVFRON1 > CTS; [To Oscilloscopes 4]; Yxxxxx; CTS PSC >; CTS PRCHG >; CTS 00 PINI; G300 > CTS; STBPFS < CTS; From CTM1/5 Ch.2 inYTB/1/4; PDOKENBL >; Ext Clock; EDVFRON 1 >; EDVFRON 2 >; TRIG P1 or P2; From T/Bk 06V in YTB/ECU1/0004; This drawing must be used in conjunction with its own; EDVFRON2 > CTS; [In ZHC/ECU1/0006]; Slot. 10; Slot. 17; Slot. 13; CTS 000; See drawing 2281; See drawing 2278

Momentum Analyser Trigger
To ULE2 ch.2 (Scope-Rack)

From CTM1/8 Ch.3 in YTB/1/4
See drawing 2278 (http://w3.jet.efda.org/CODAS/drawings/2278.pdf)

[to Protection-System] Yxxxxx

Proton Detector Trigger
To ULE2 ch.1 (Scope-Rack)
[In ZHC/ECU1/0006]

Timing and logic diagram

Current issue

Issue date | 15/04/13
