enginebeat/TestBedUpgrade/fibreDistrBox/16_2_patchPanel v1 Drawing v1.pdf

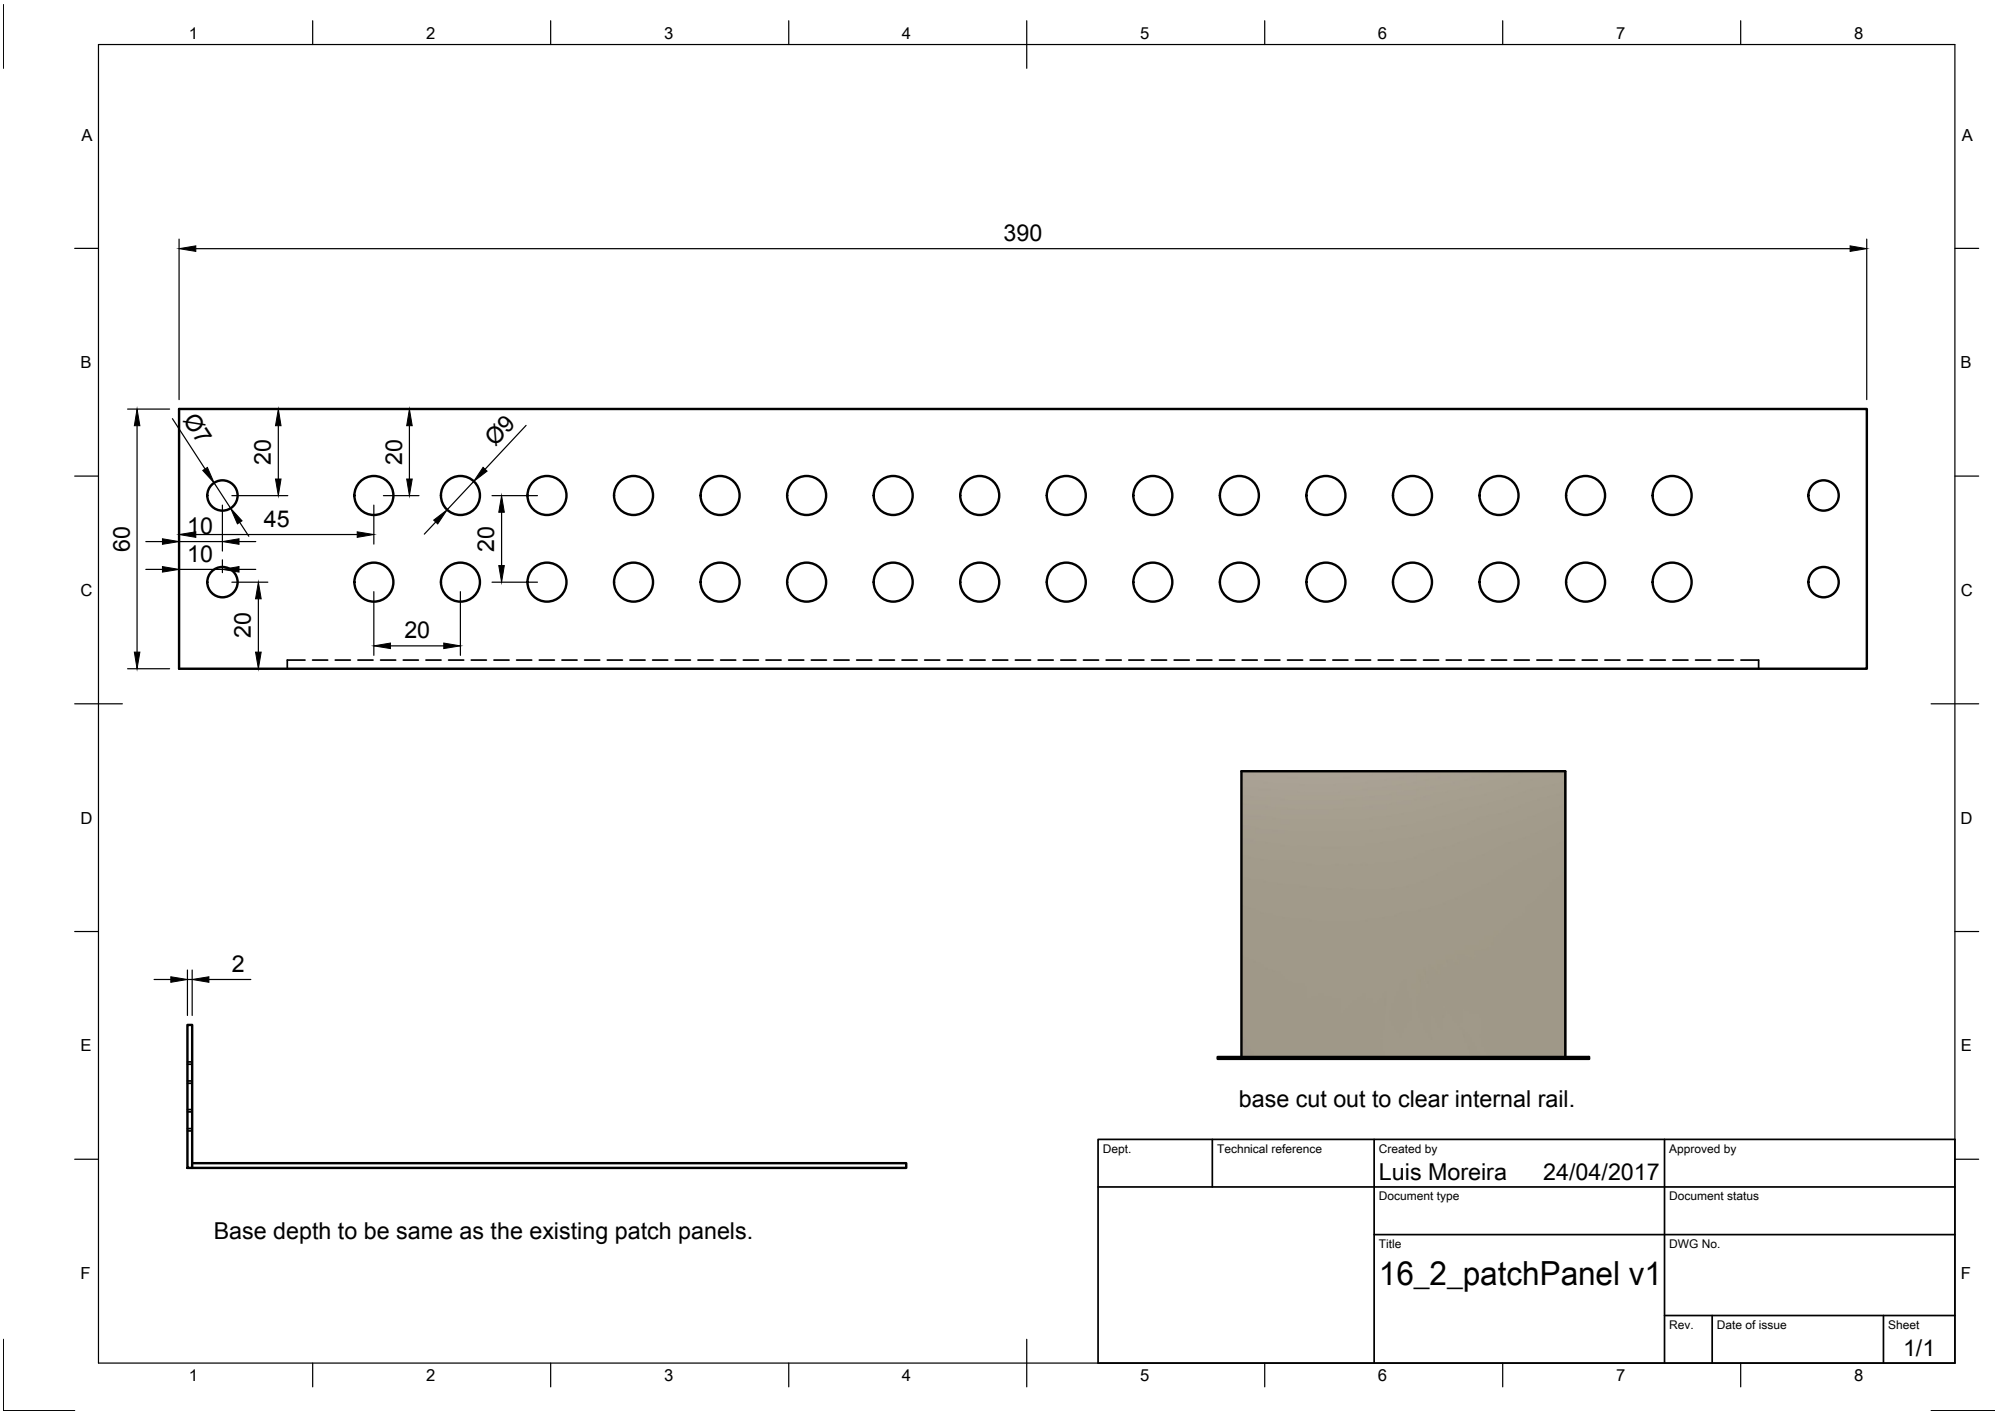
[picture p21: page 1]

Base depth to be same as the existing patch panels. 20

base cut out to clear internal rail.

Dept. | Technical reference | Created by Luis Moreira 24/04/2017 | Approved by

Document type | Document status

Title 16_2_patchPanel v1 | DWG No.

Rev. | Date of issue | Sheet 1/1
