enginebeat/TestBedUpgrade/fibreDistrBox/ProtectionUnitFO.pdf

# CODAS

## PATCH 1

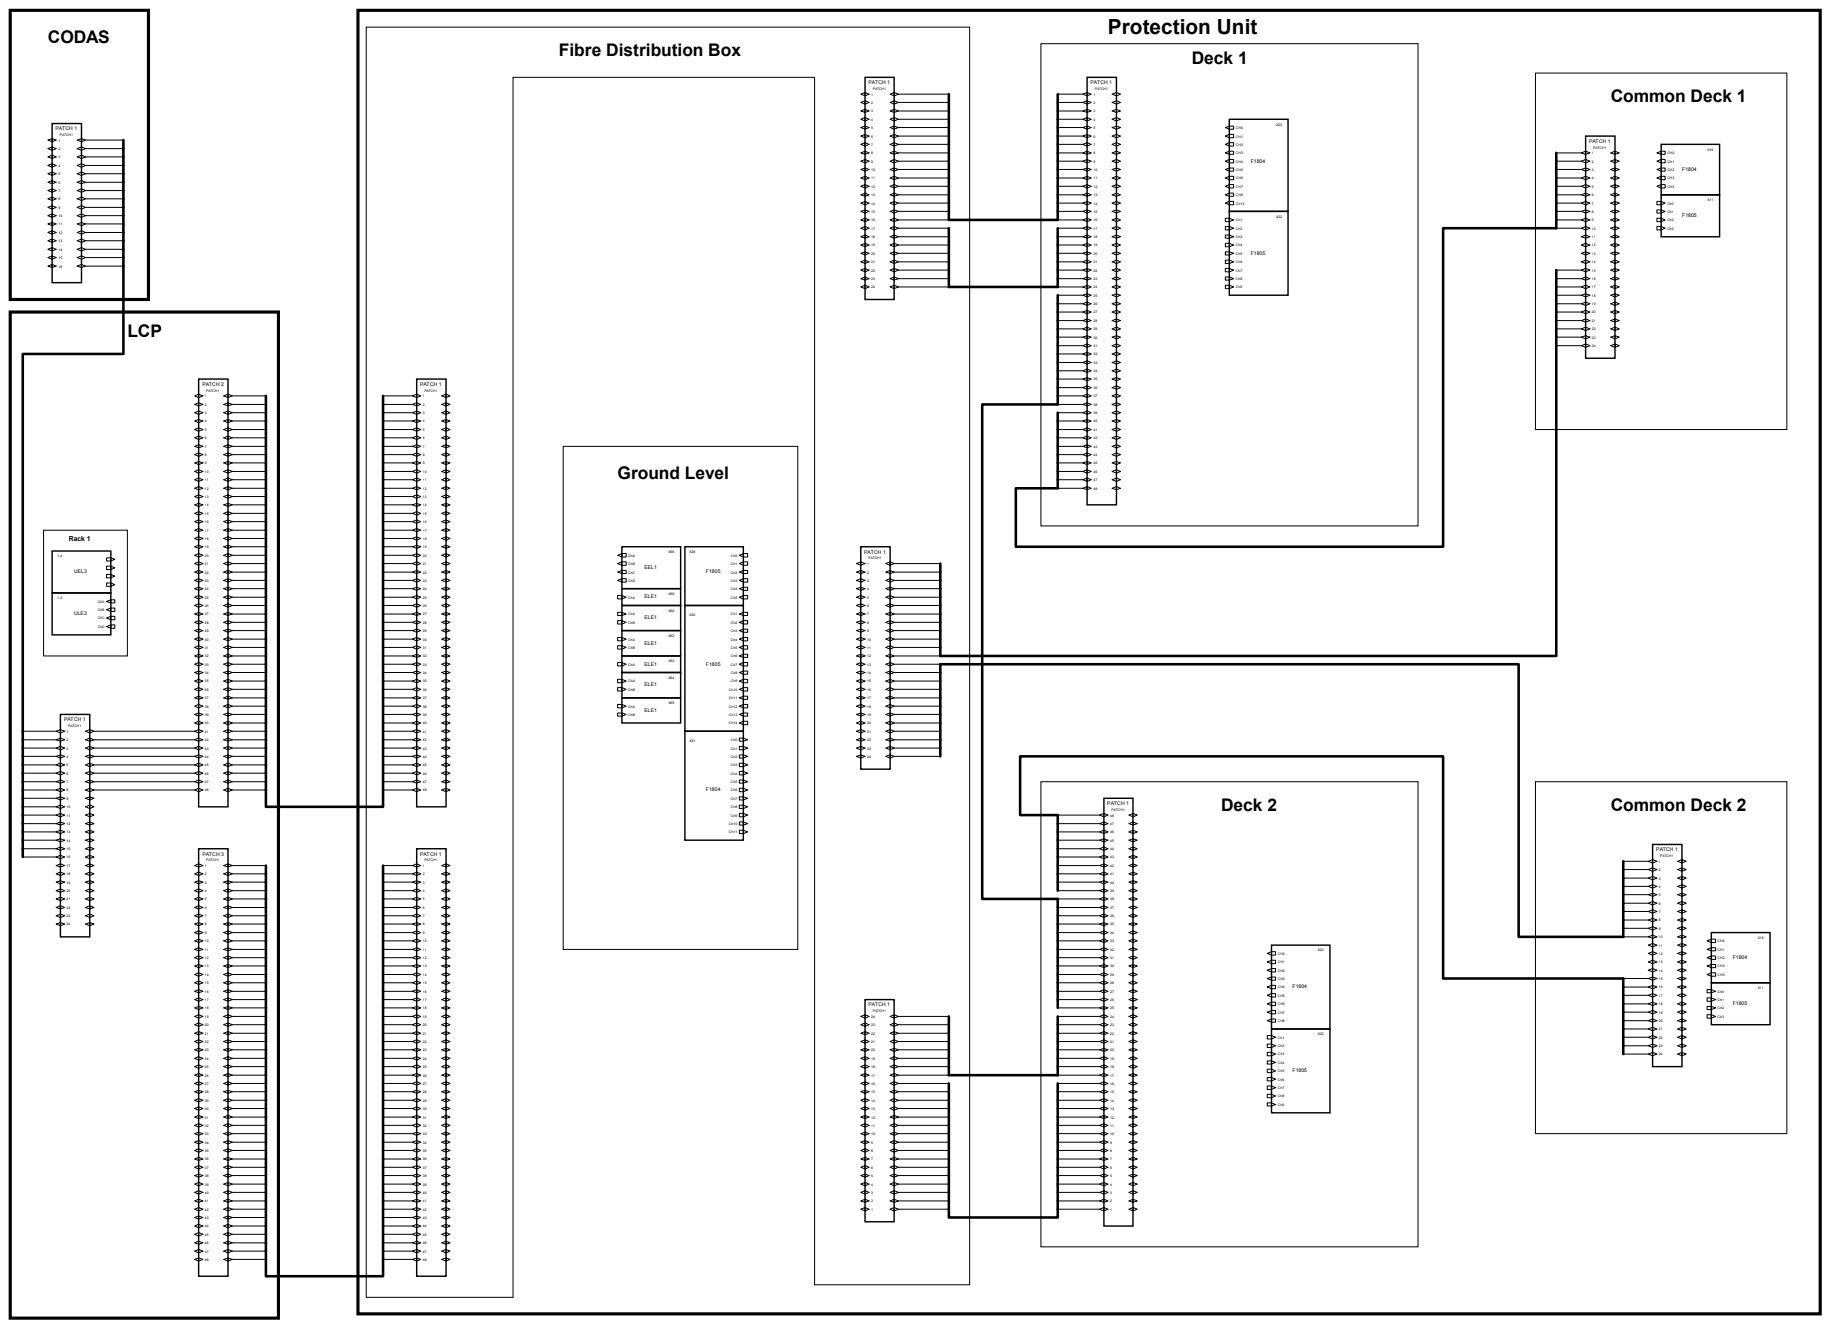
[picture p22: page 1]
LCP; PATCH1; Deck 1; PATCH 1; Ground Level; Common Deck 1; Deck 2; Common Deck 2; Protection Unit; PATCH 2; PATCH 3; ELE1; X63 ChA; ChA; ChB; X60 ChA; EEL1; ChC; ChD; ULE3; UEL3; Rack 1

Fibre Distribution Box
