enginebeat/TestBedUpgrade/Cards/20Channel_Cards/20 Channel FO Receiver - Schematic.pdf

## CHAN 0

## CHAN 1

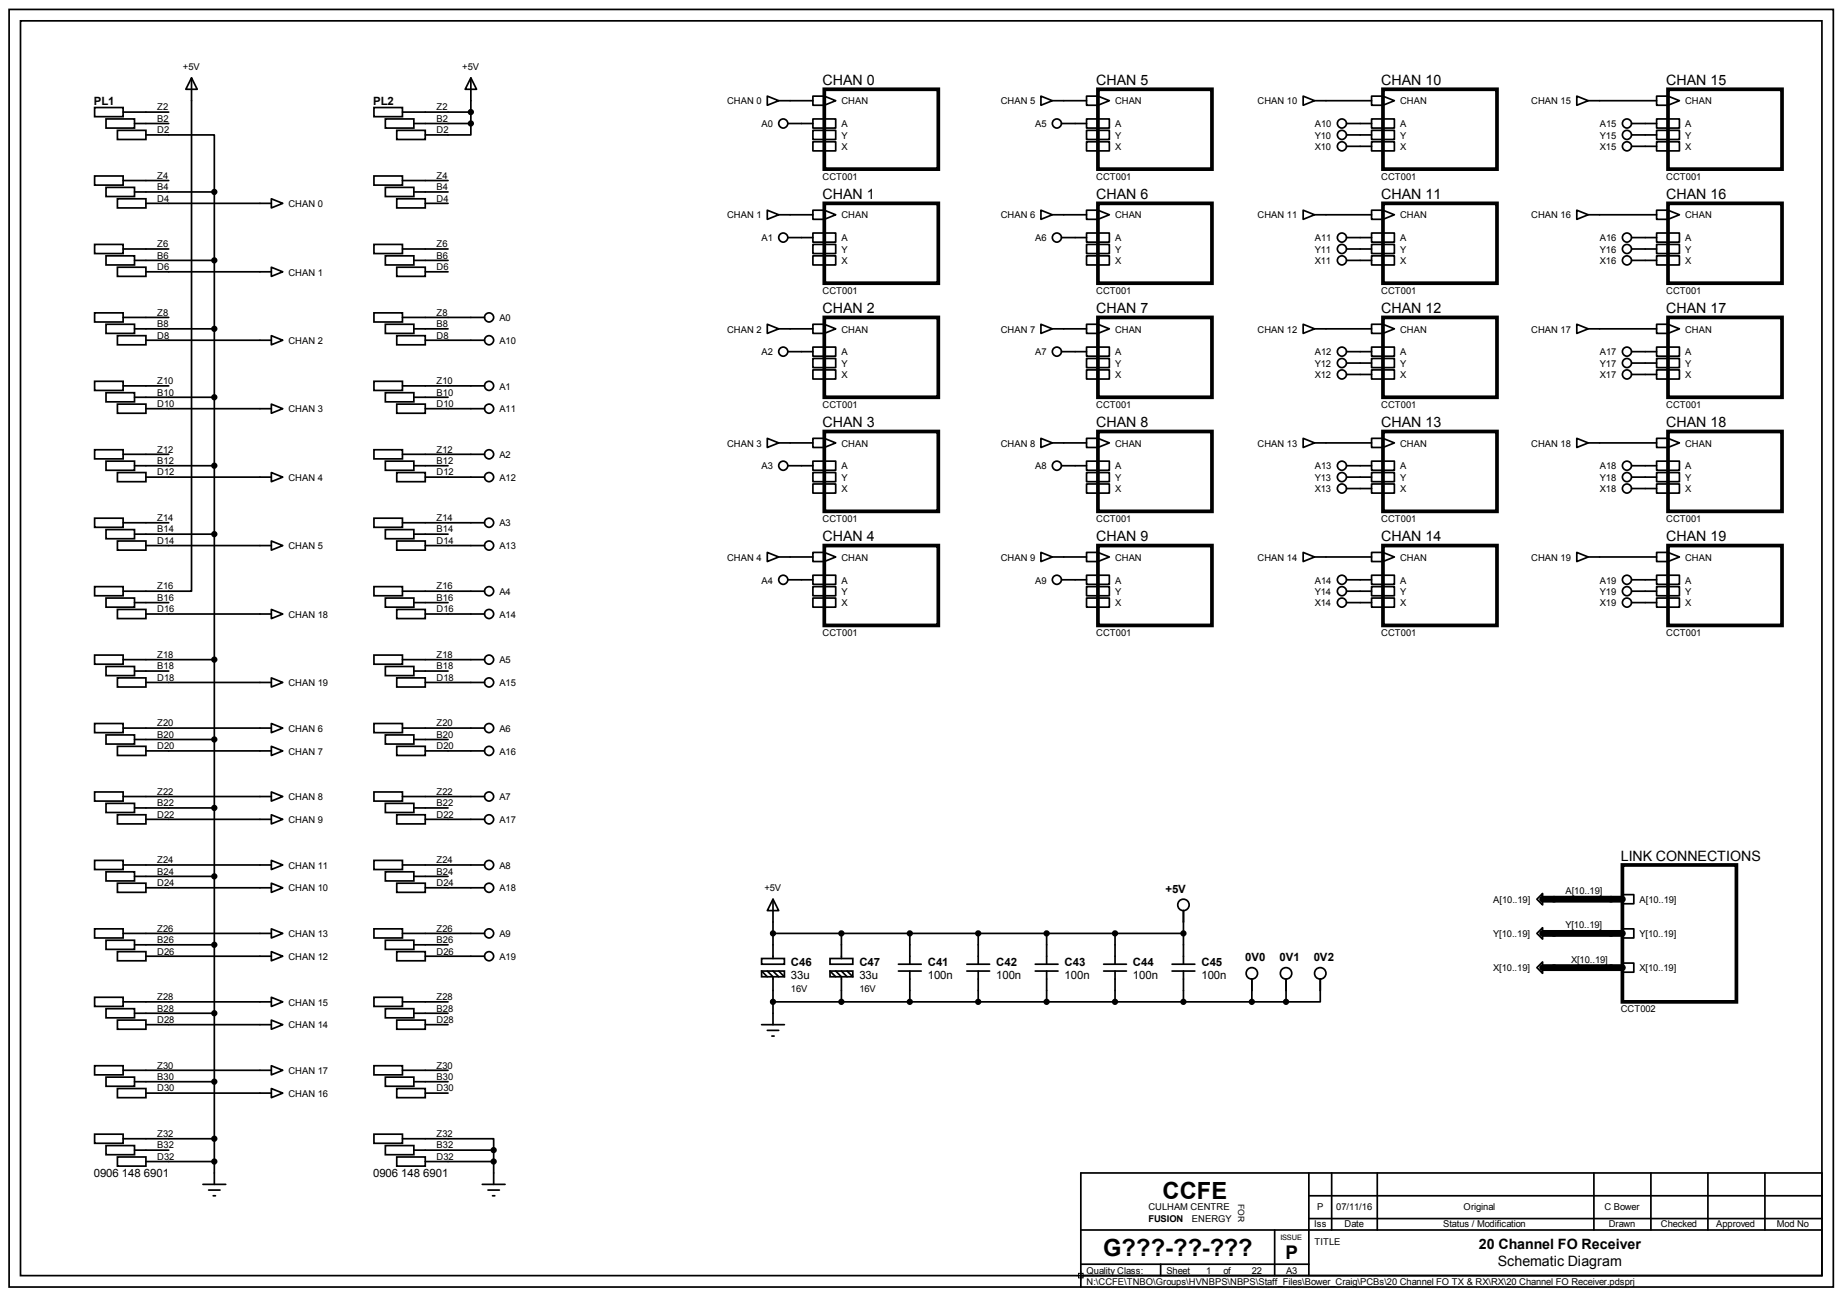
[picture p23: page 1]

CCFE CULHAM CENTRE FUSION ENERGY

P | | Original | C Bower
G???-??-??? | ISSUE P | 20 Channel FO Receiver TITLE Schematic Diagram

Iss | Date | Status / Modification | Drawn | Checked | Approved | Mod No

Quality Class: | Sheet of | A3

N:\CCFE\TNBO\Groups\HVNBPS\NBPS\Staff_Files\Bower_Craig\PCBs\20 Channel FO TX & RX\RX\20 Channel FO Receiver.pdsprj

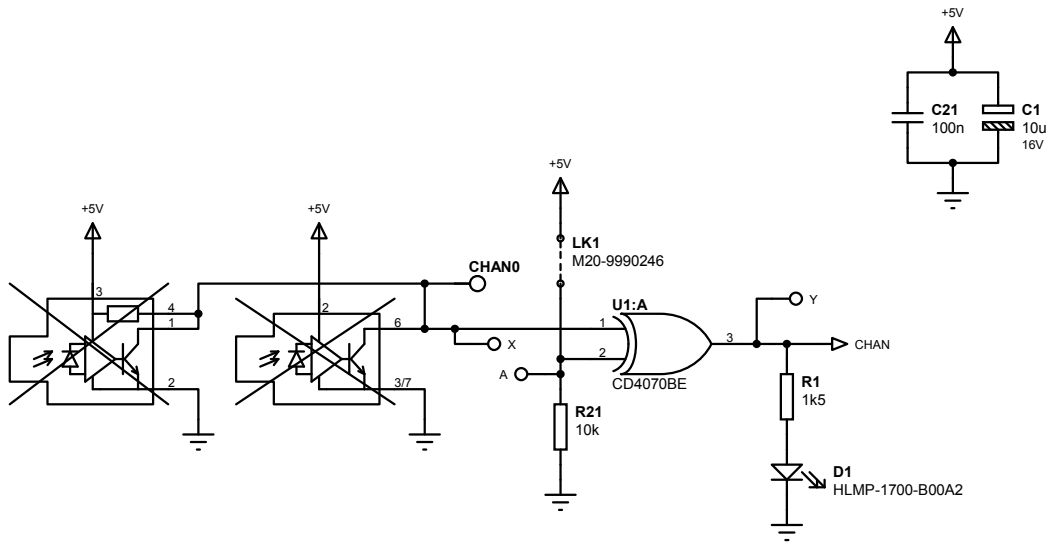
[picture p24: page 2]
FOR07/11/16; CHAN0; CHAN; D1 HLMP-1700-B00A2

CCFE CULHAM CENTRE FUSION ENERGY

P | | Original | C Bower

Iss | Date | Status / Modification | Drawn | Checked | Approved | Mod No
P | 20 Channel FO Receiver TITLE

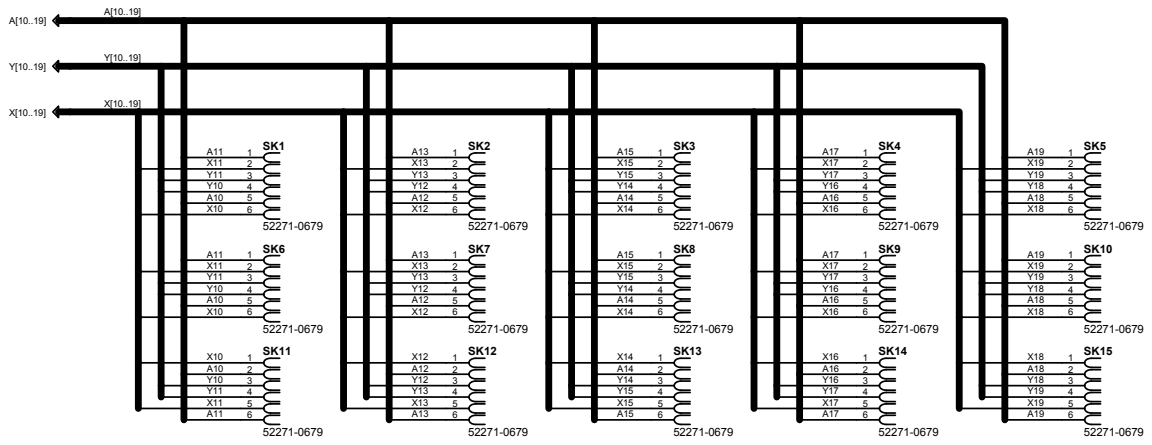
[picture p25: page 3]
FOR07/11/16

CCFE CULHAM CENTRE FUSION ENERGY

P | | Original | C Bower

Iss | Date | Status / Modification | Drawn | Checked | Approved | Mod No

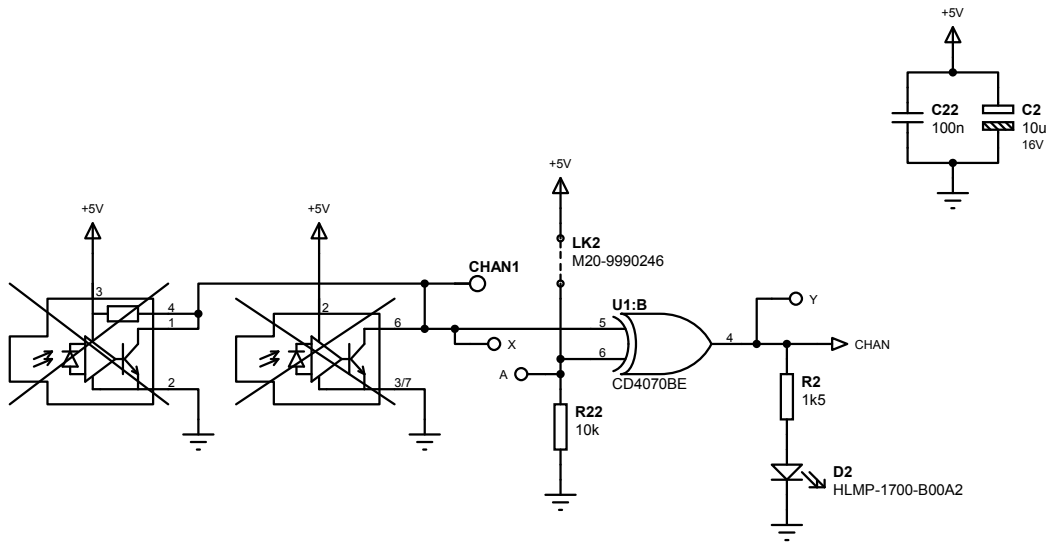
[picture p26: page 4]
FOR07/11/16; CHAN1; CHAN; D2 HLMP-1700-B00A2

CCFE CULHAM CENTRE FUSION ENERGY

P | | Original | C Bower

Iss | Date | Status / Modification | Drawn | Checked | Approved | Mod No

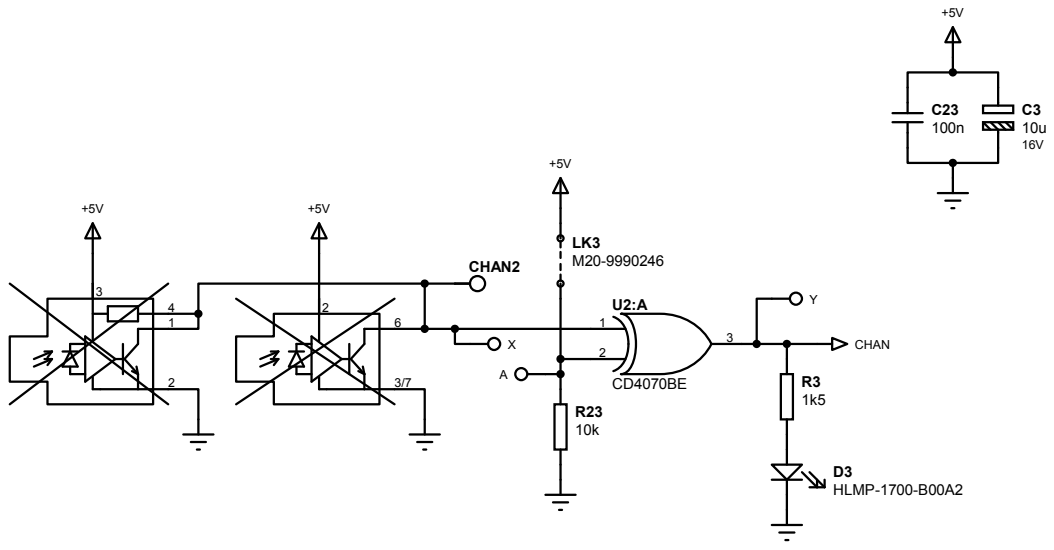
[picture p27: page 5]
FOR07/11/16; CHAN2; CHAN; D3 HLMP-1700-B00A2

CCFE CULHAM CENTRE FUSION ENERGY

P | | Original | C Bower

Iss | Date | Status / Modification | Drawn | Checked | Approved | Mod No

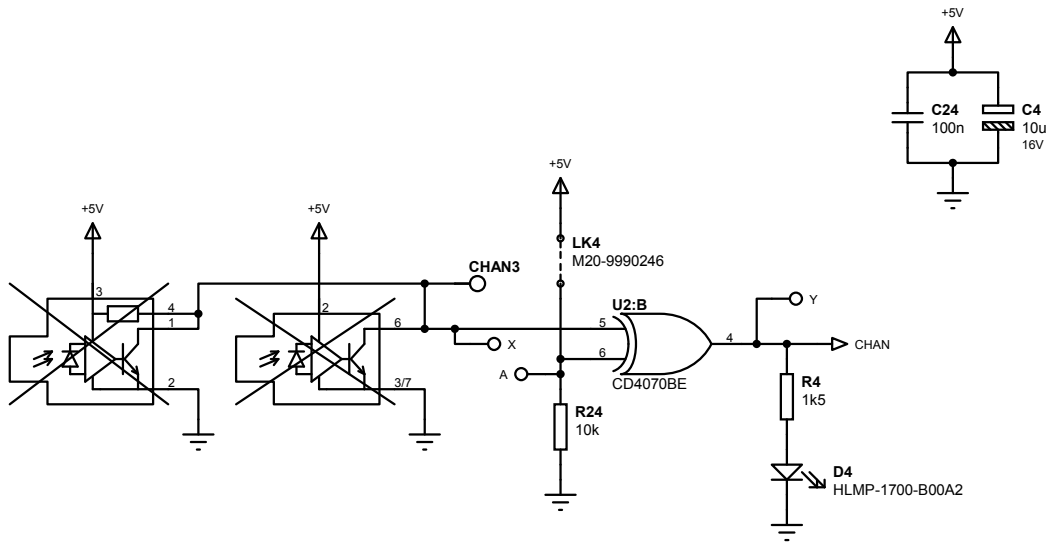
[picture p28: page 6]
FOR07/11/16; CHAN3; CHAN; D4 HLMP-1700-B00A2

CCFE CULHAM CENTRE FUSION ENERGY

P | | Original | C Bower

Iss | Date | Status / Modification | Drawn | Checked | Approved | Mod No

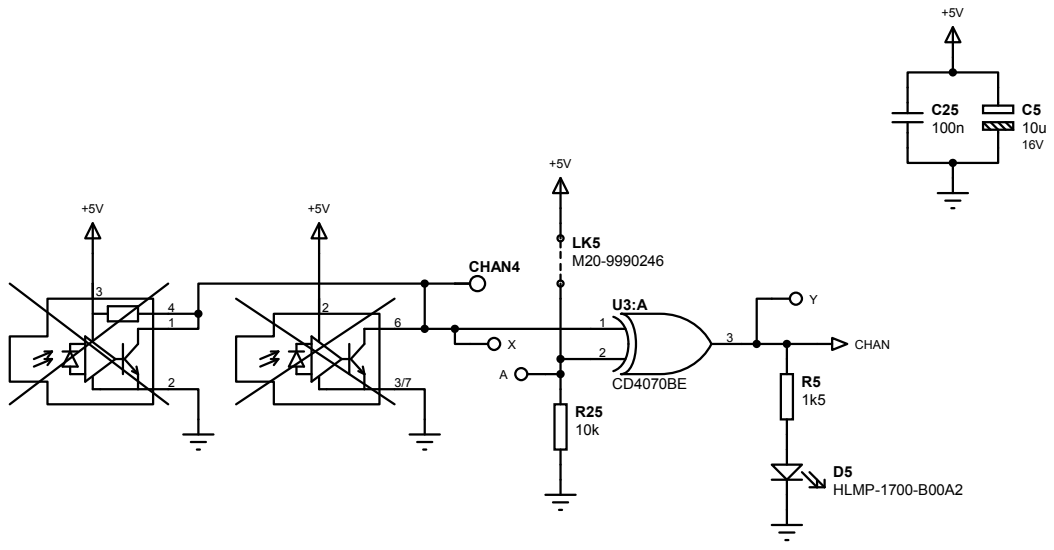
[picture p29: page 7]
FOR07/11/16; CHAN4; CHAN; D5 HLMP-1700-B00A2

CCFE CULHAM CENTRE FUSION ENERGY

P | | Original | C Bower

Iss | Date | Status / Modification | Drawn | Checked | Approved | Mod No

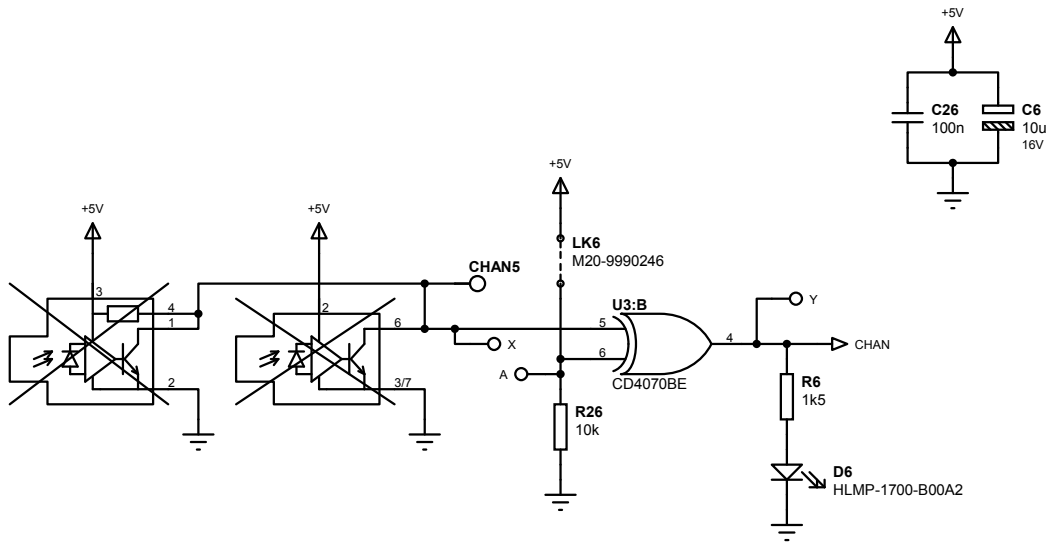
[picture p30: page 8]
FOR07/11/16; CHAN5; CHAN; D6 HLMP-1700-B00A2

CCFE CULHAM CENTRE FUSION ENERGY

P | | Original | C Bower

Iss | Date | Status / Modification | Drawn | Checked | Approved | Mod No

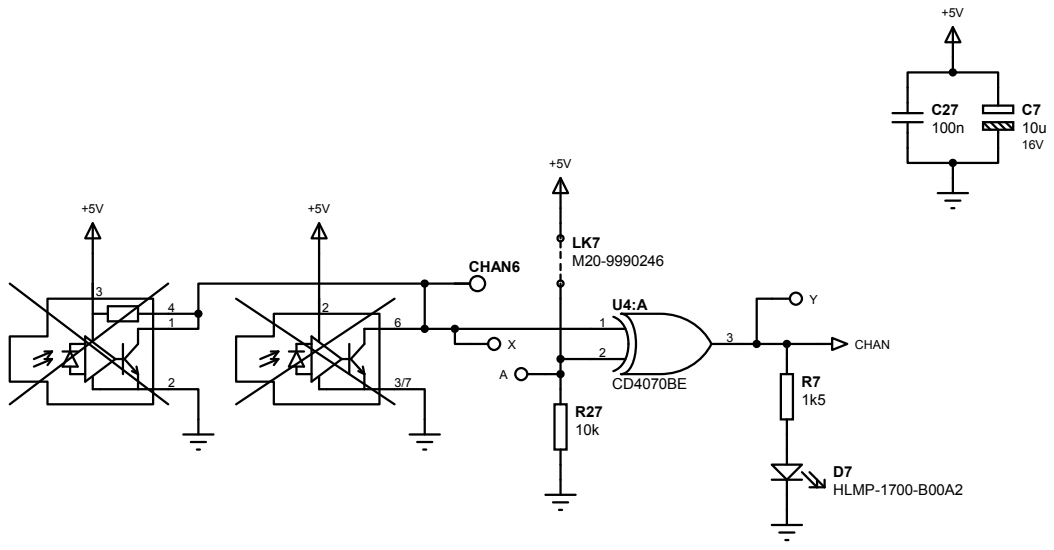
[picture p31: page 9]
FOR07/11/16; CHAN6; CHAN; D7 HLMP-1700-B00A2

CCFE CULHAM CENTRE FUSION ENERGY

P | | Original | C Bower

Iss | Date | Status / Modification | Drawn | Checked | Approved | Mod No

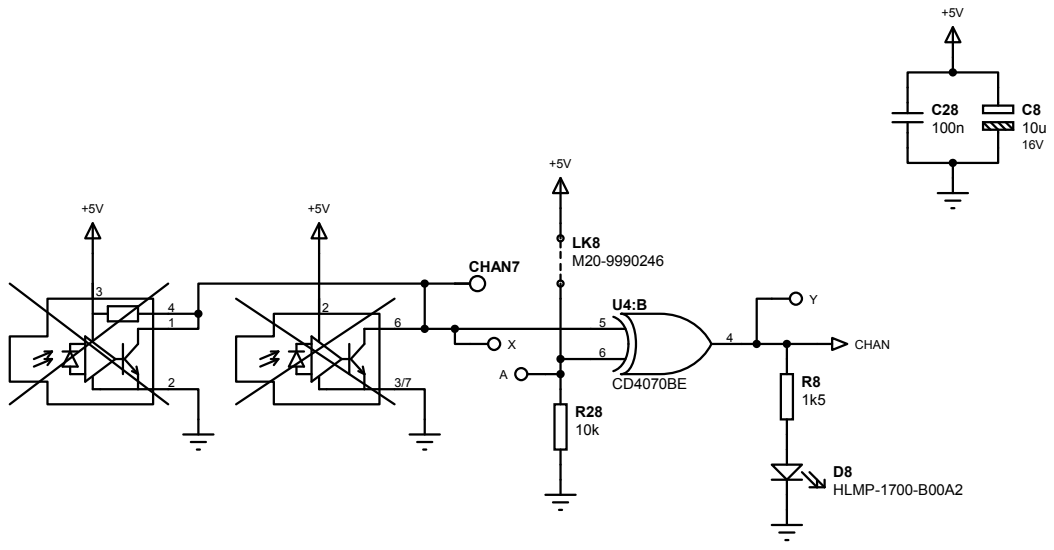
[picture p32: page 10]
FOR07/11/16; CHAN7; CHAN; D8 HLMP-1700-B00A2

CCFE CULHAM CENTRE FUSION ENERGY

P | | Original | C Bower

Iss | Date | Status / Modification | Drawn | Checked | Approved | Mod No

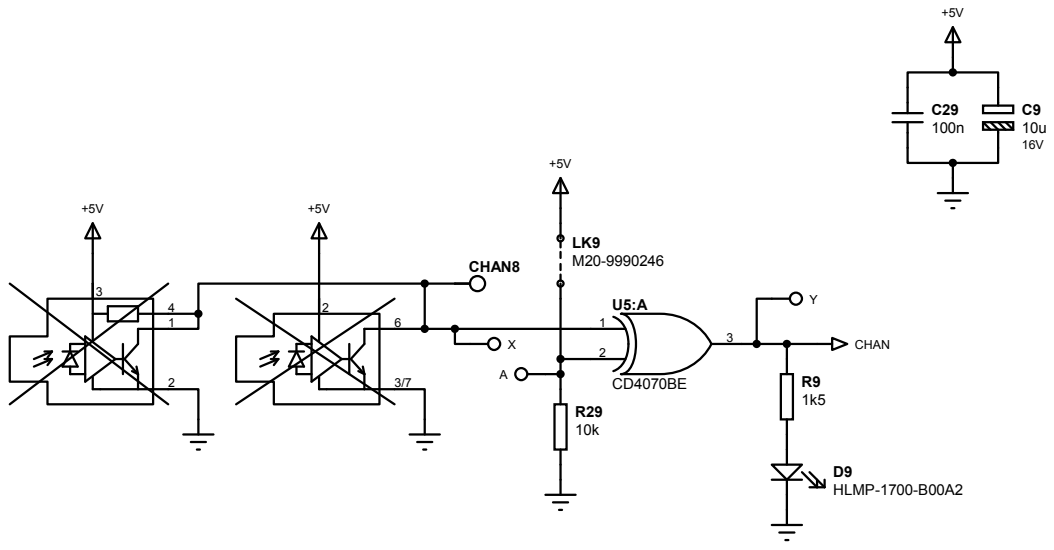
[picture p33: page 11]
FOR07/11/16; CHAN8; CHAN; D9 HLMP-1700-B00A2

CCFE CULHAM CENTRE FUSION ENERGY

P | | Original | C Bower

Iss | Date | Status / Modification | Drawn | Checked | Approved | Mod No

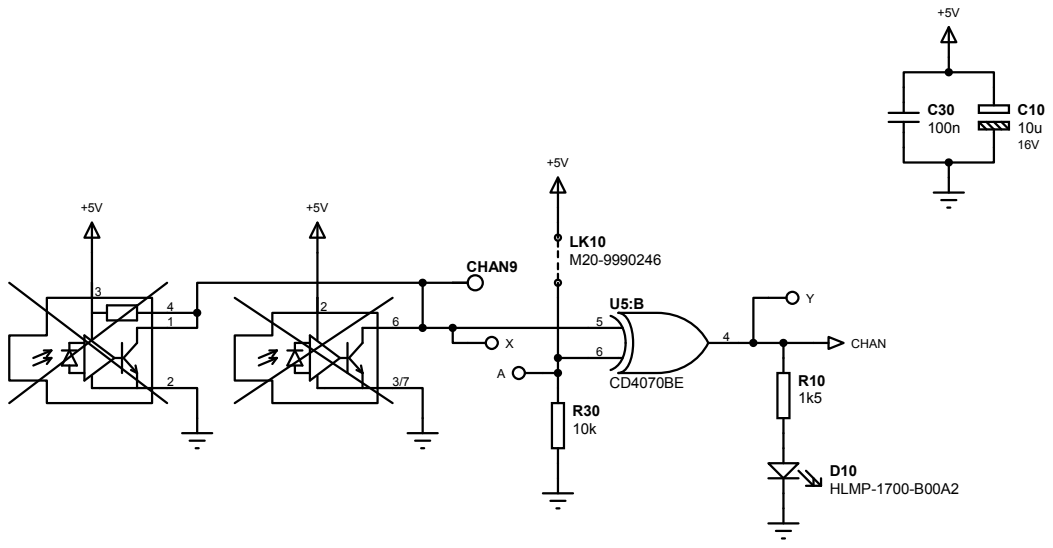
[picture p34: page 12]
FOR07/11/16; CHAN9; CHAN; D10 HLMP-1700-B00A2

CCFE CULHAM CENTRE FUSION ENERGY

P | | Original | C Bower

Iss | Date | Status / Modification | Drawn | Checked | Approved | Mod No

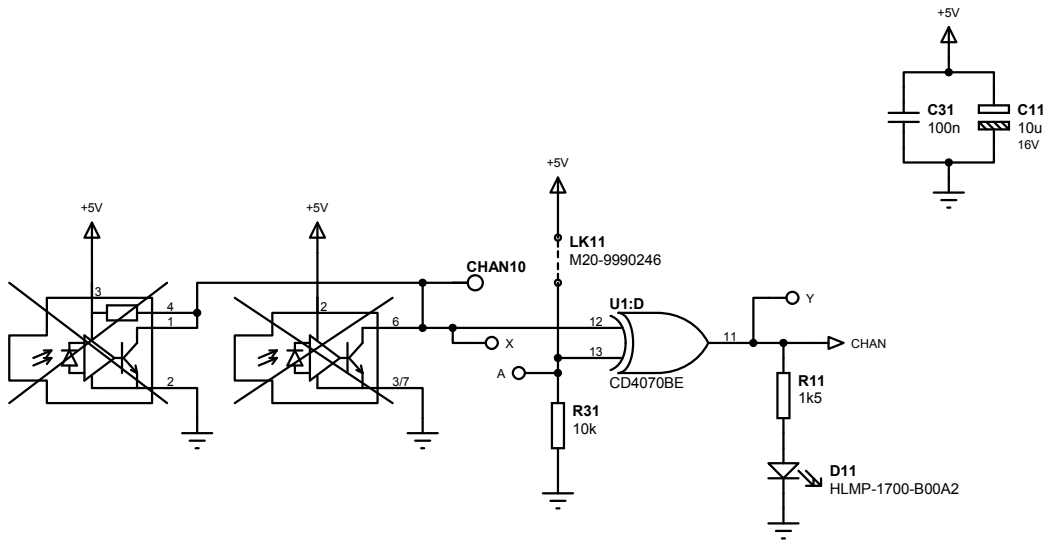
[picture p35: page 13]
FOR07/11/16; CHAN10; CHAN; D11 HLMP-1700-B00A2

CCFE CULHAM CENTRE FUSION ENERGY

P | | Original | C Bower

Iss | Date | Status / Modification | Drawn | Checked | Approved | Mod No

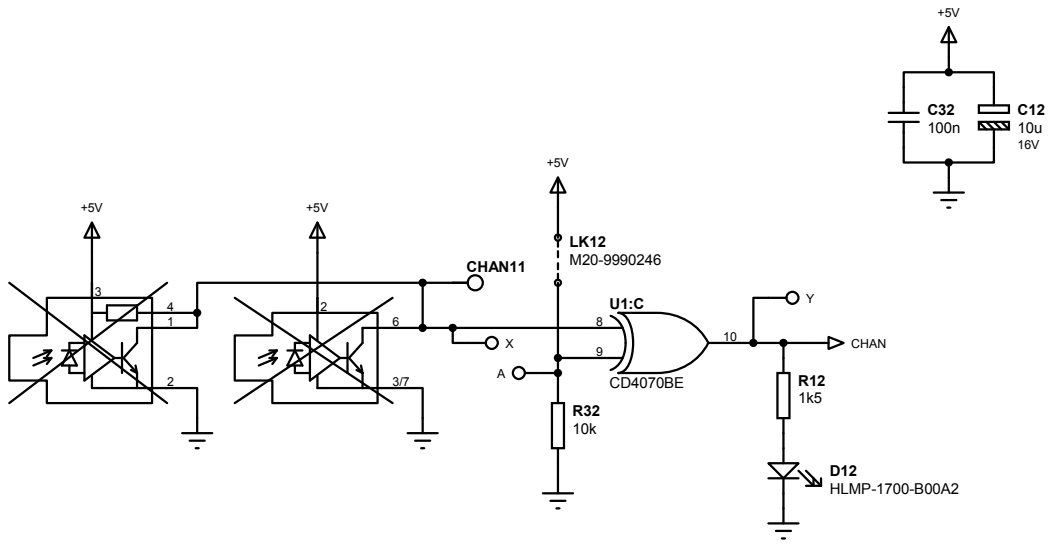
[picture p36: page 14]
FOR07/11/16; CHAN11; CHAN; D12 HLMP-1700-B00A2

CCFE CULHAM CENTRE FUSION ENERGY

P | | Original | C Bower

Iss | Date | Status / Modification | Drawn | Checked | Approved | Mod No

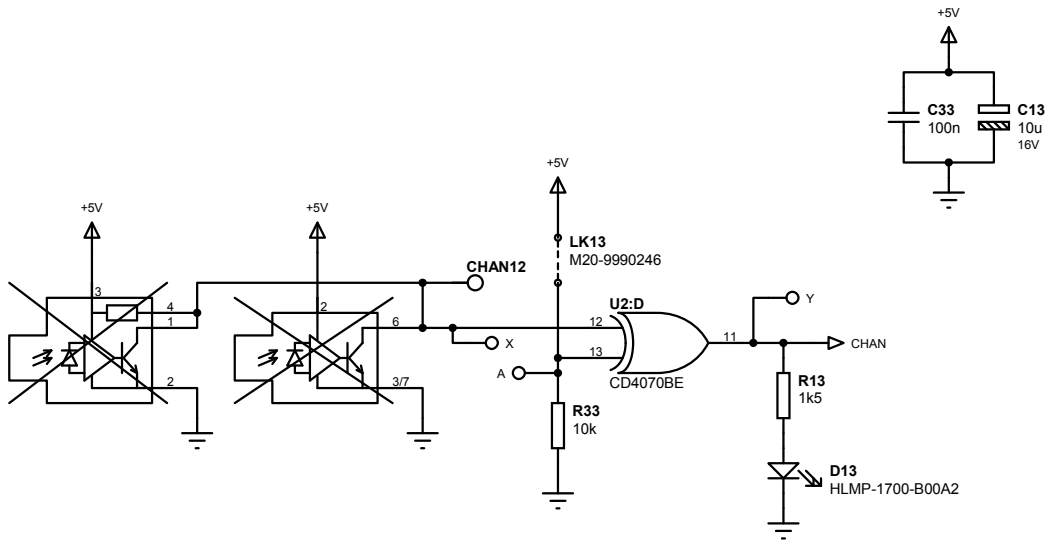
[picture p37: page 15]
FOR07/11/16; CHAN12; CHAN; D13 HLMP-1700-B00A2

CCFE CULHAM CENTRE FUSION ENERGY

P | | Original | C Bower

Iss | Date | Status / Modification | Drawn | Checked | Approved | Mod No

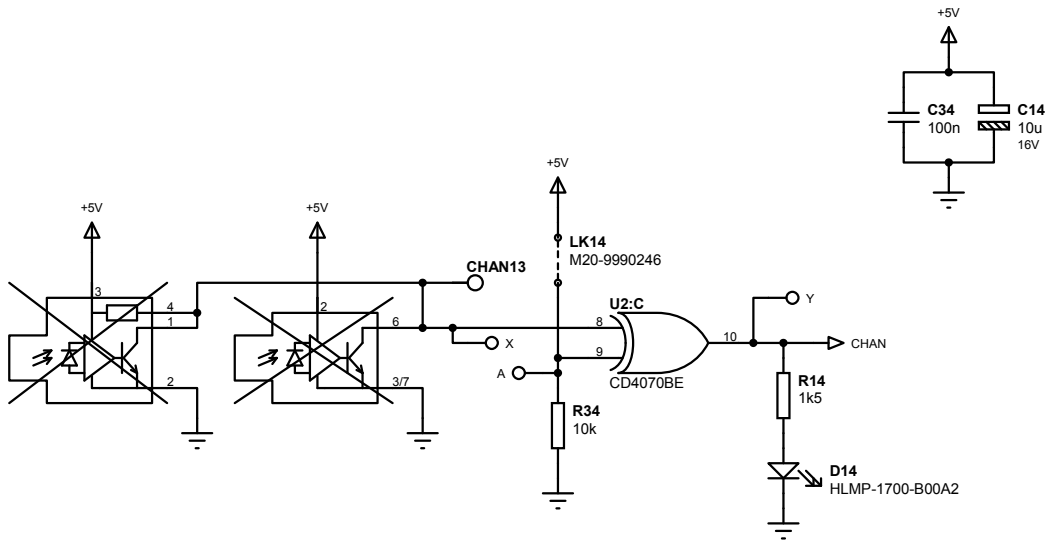
[picture p38: page 16]
FOR07/11/16; CHAN13; CHAN; D14 HLMP-1700-B00A2

CCFE CULHAM CENTRE FUSION ENERGY

P | | Original | C Bower

Iss | Date | Status / Modification | Drawn | Checked | Approved | Mod No

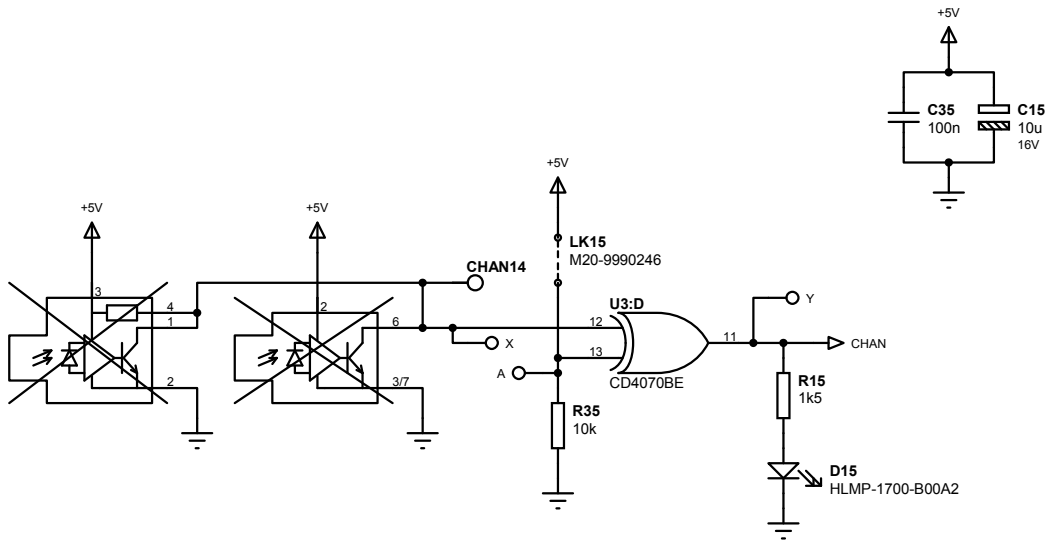
[picture p39: page 17]
FOR07/11/16; CHAN14; CHAN; D15 HLMP-1700-B00A2

CCFE CULHAM CENTRE FUSION ENERGY

P | | Original | C Bower

Iss | Date | Status / Modification | Drawn | Checked | Approved | Mod No

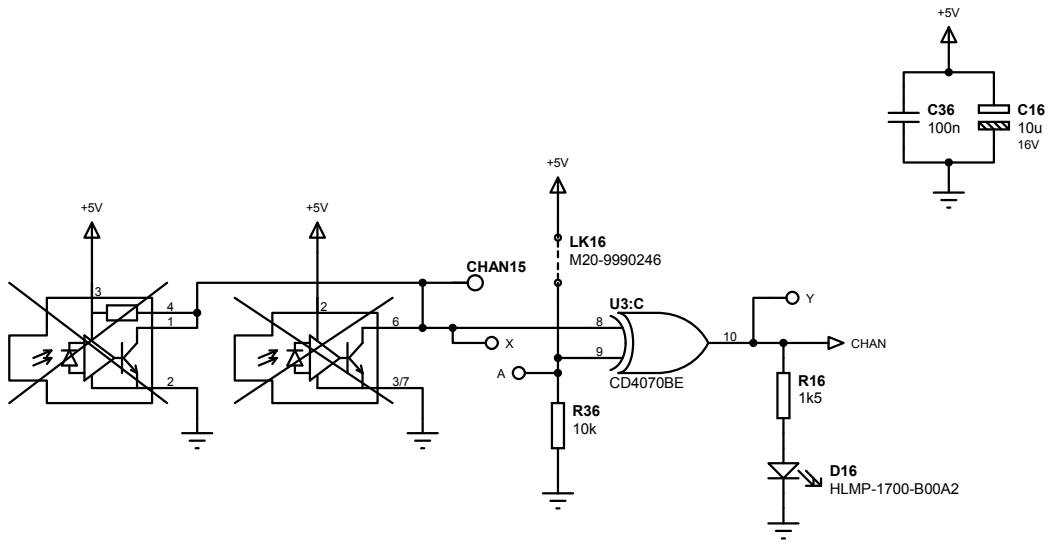
[picture p40: page 18]
FOR07/11/16; CHAN15; CHAN; D16 HLMP-1700-B00A2

CCFE CULHAM CENTRE FUSION ENERGY

P | | Original | C Bower

Iss | Date | Status / Modification | Drawn | Checked | Approved | Mod No

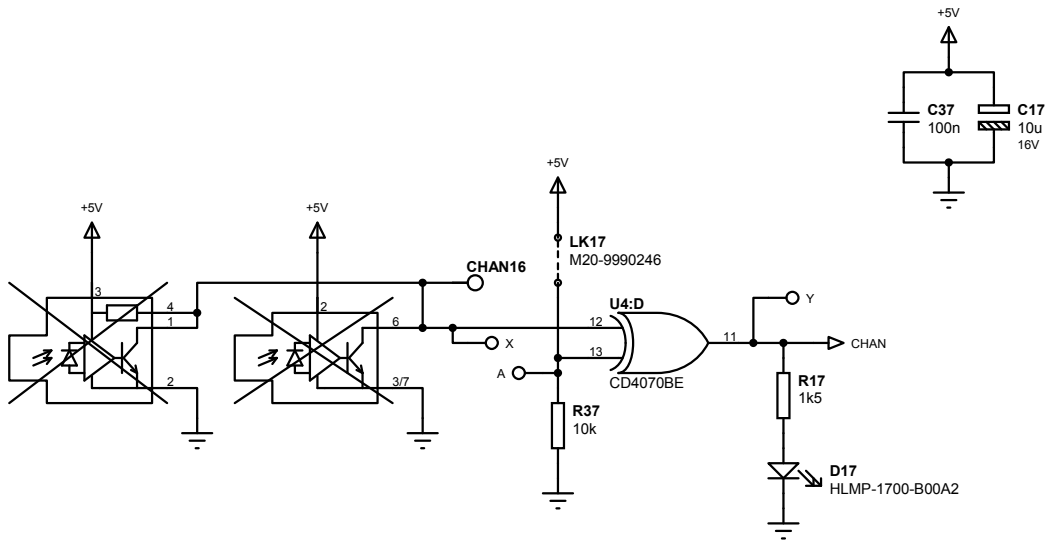
[picture p41: page 19]
FOR07/11/16; CHAN16; CHAN; D17 HLMP-1700-B00A2

CCFE CULHAM CENTRE FUSION ENERGY

P | | Original | C Bower

Iss | Date | Status / Modification | Drawn | Checked | Approved | Mod No

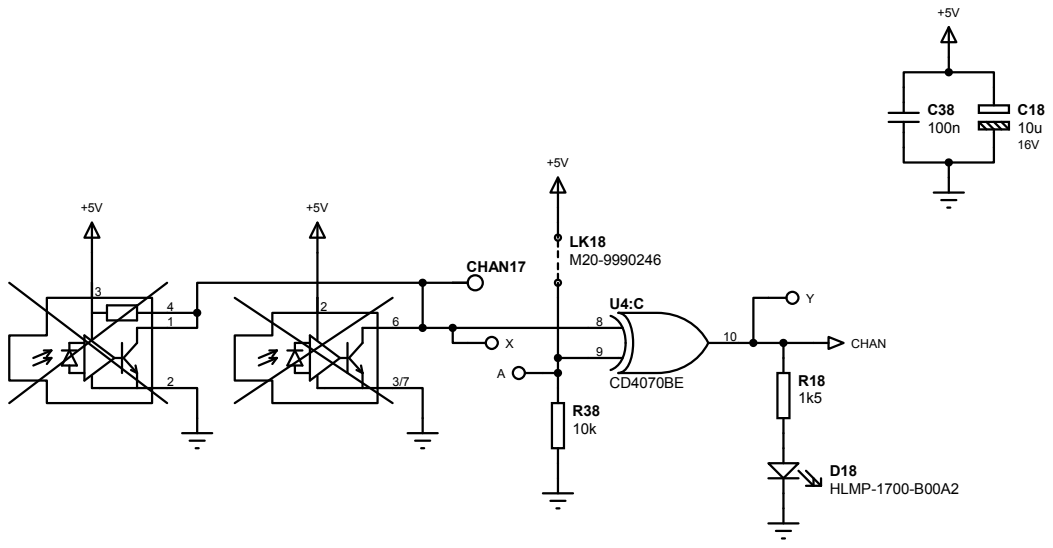
[picture p42: page 20]
FOR07/11/16; CHAN17; CHAN; D18 HLMP-1700-B00A2

CCFE CULHAM CENTRE FUSION ENERGY

P | | Original | C Bower

Iss | Date | Status / Modification | Drawn | Checked | Approved | Mod No

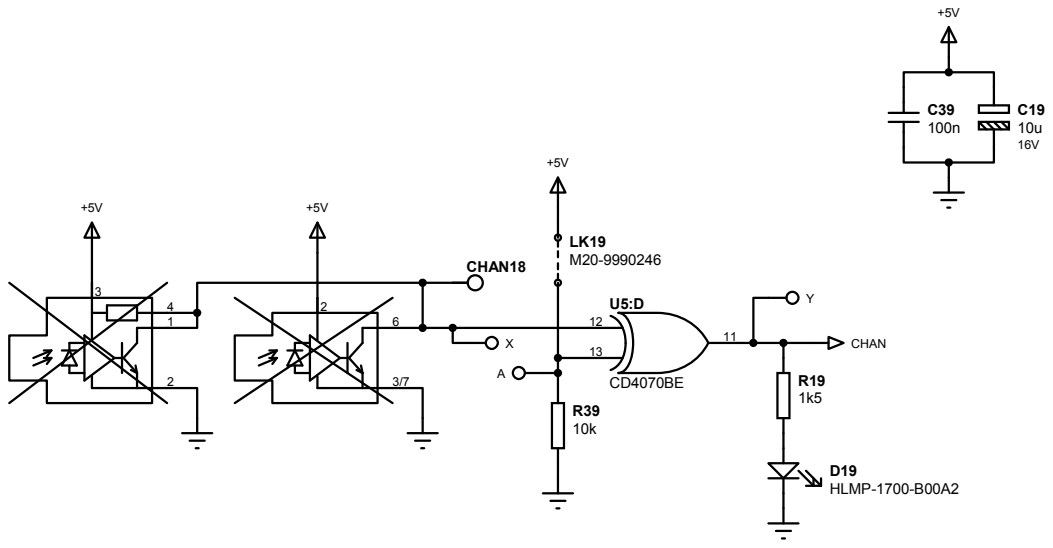
[picture p43: page 21]
FOR07/11/16; CHAN18; CHAN; D19 HLMP-1700-B00A2

CCFE CULHAM CENTRE FUSION ENERGY

P | | Original | C Bower

Iss | Date | Status / Modification | Drawn | Checked | Approved | Mod No

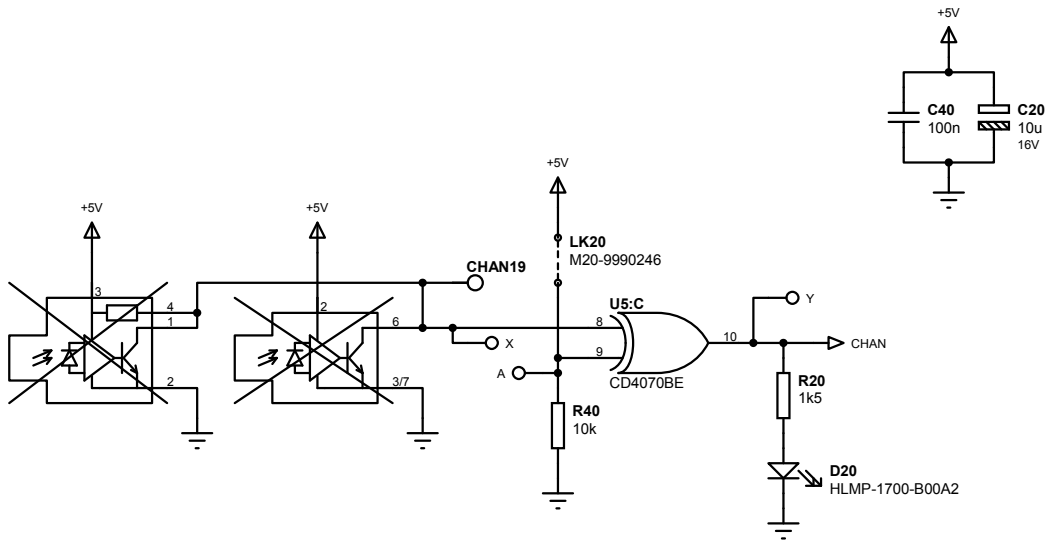
[picture p44: page 22]
FOR07/11/16; CHAN19; CHAN; D20 HLMP-1700-B00A2

CCFE CULHAM CENTRE FUSION ENERGY

P | | Original | C Bower

Iss | Date | Status / Modification | Drawn | Checked | Approved | Mod No
