enginebeat/TestBedUpgrade/Cards/20Channel_Cards/20 Channel FO Transmitter - Schematic.pdf

## CHAN 0

## CHAN 1

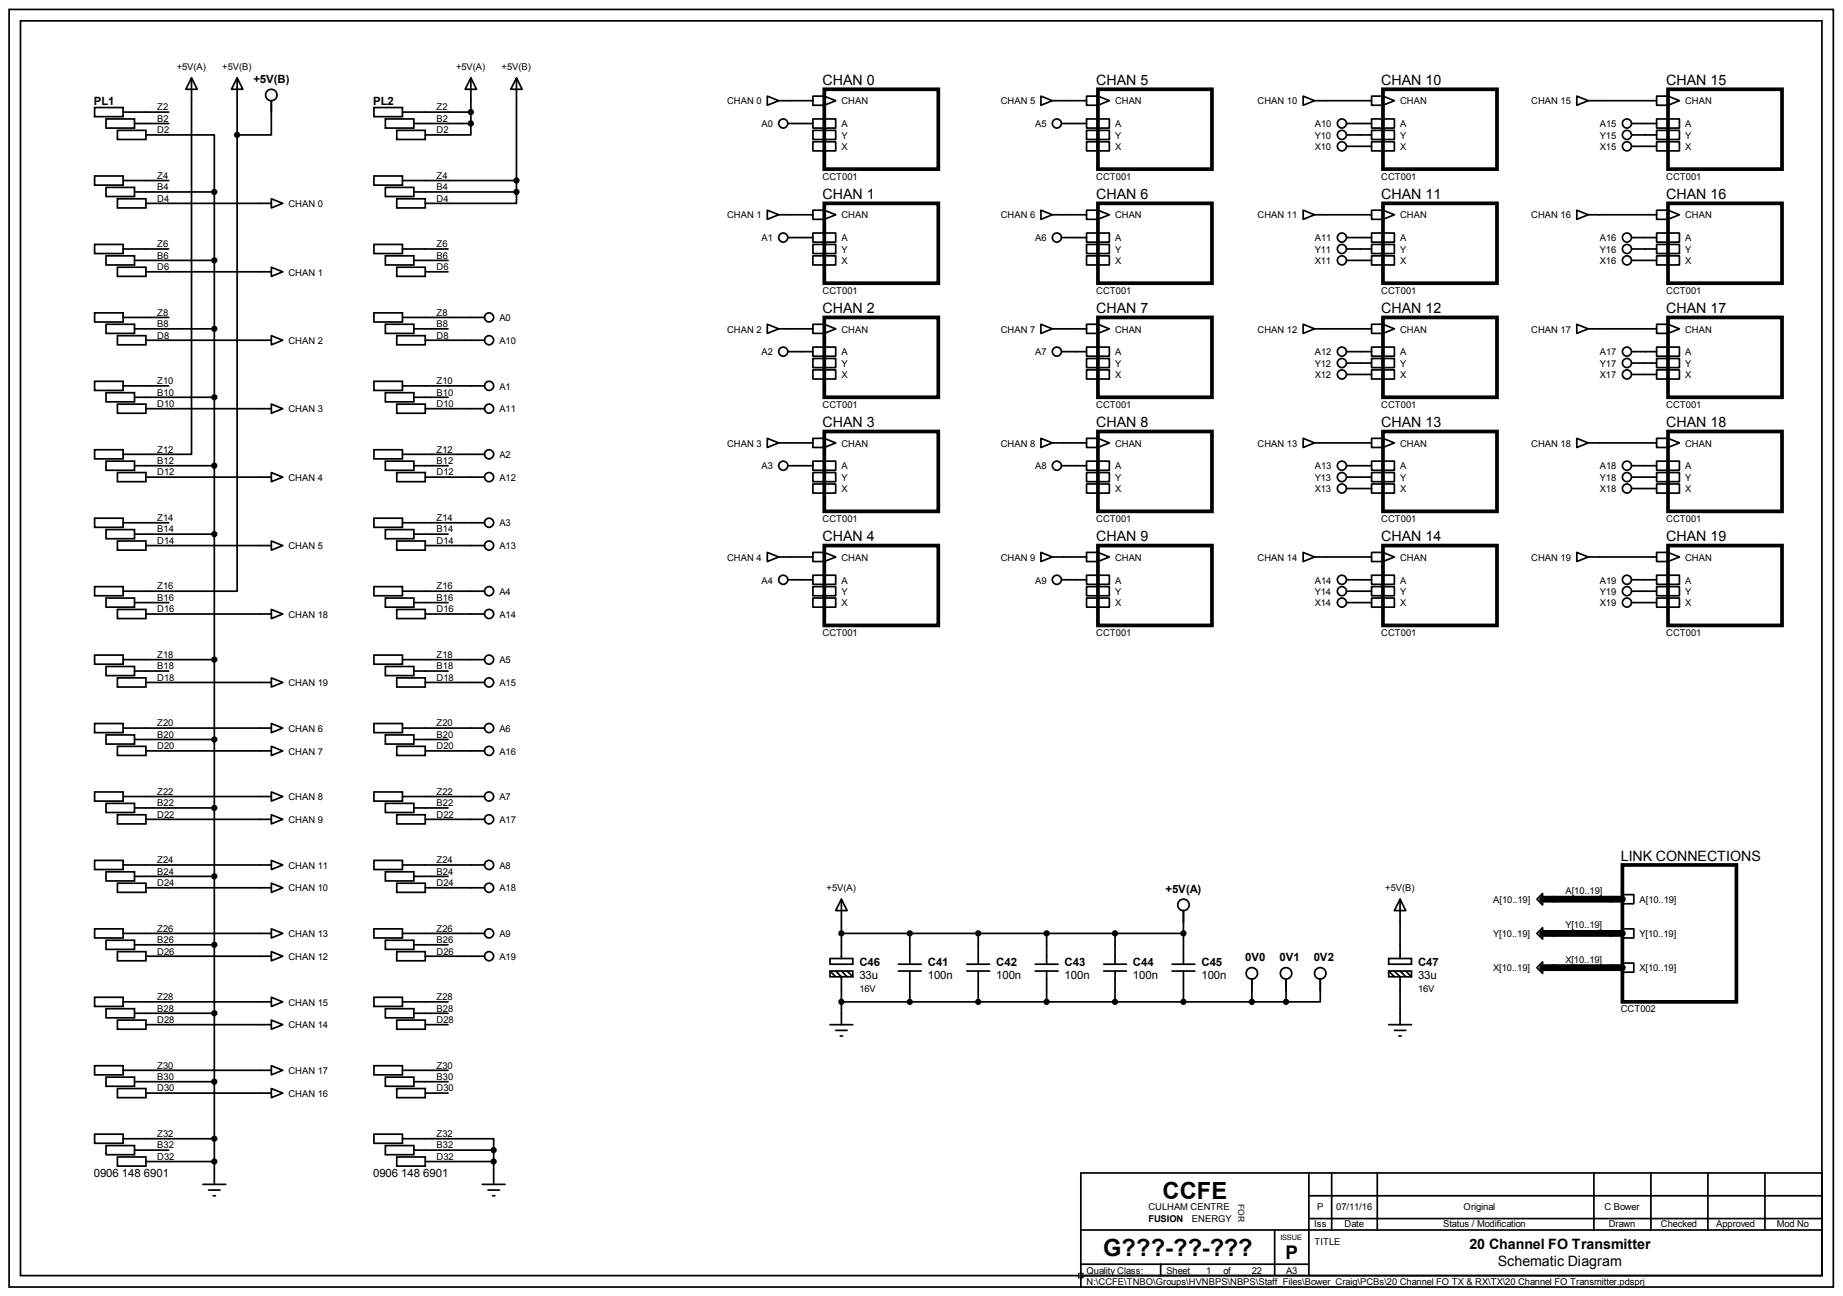
[picture p45: page 1]

CCFE CULHAM CENTRE FUSION ENERGY

P | | Original | C Bower
G???-??-??? | ISSUE P | 20 Channel FO Transmitter TITLE Schematic Diagram

Iss | Date | Status / Modification | Drawn | Checked | Approved | Mod No

Quality Class: | Sheet of | A3

N:\CCFE\TNBO\Groups\HVNBPS\NBPS\Staff_Files\Bower_Craig\PCBs\20 Channel FO TX & RX\TX\20 Channel FO Transmitter.pdsprj

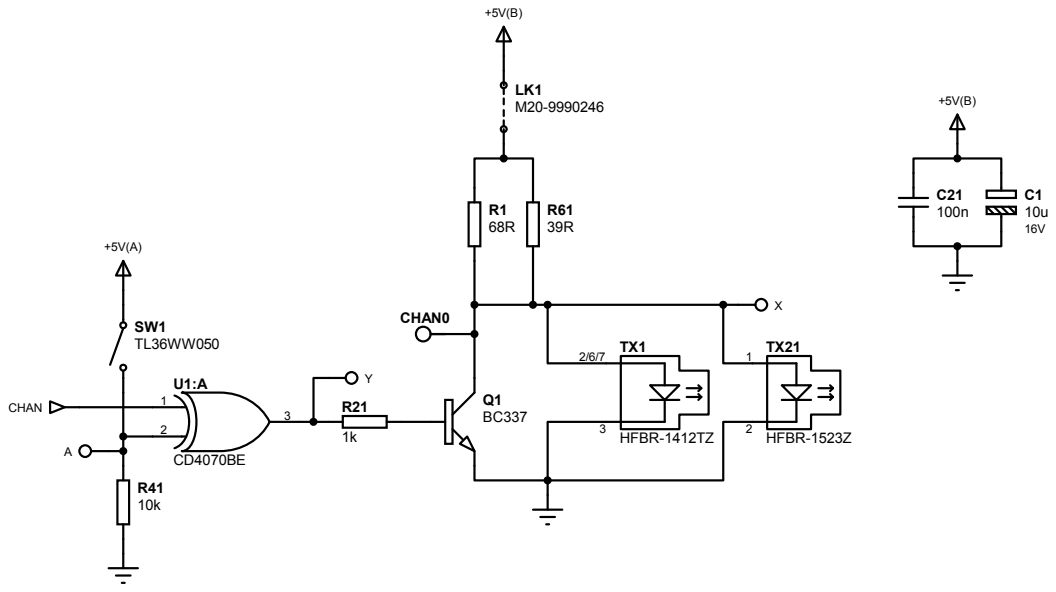
[picture p46: page 2]

CCFE CULHAM CENTRE FUSION ENERGY

P | | Original | C Bower

Iss | Date | Status / Modification | Drawn | Checked | Approved | Mod No
P 20 Channel FO Transmitter TITLE

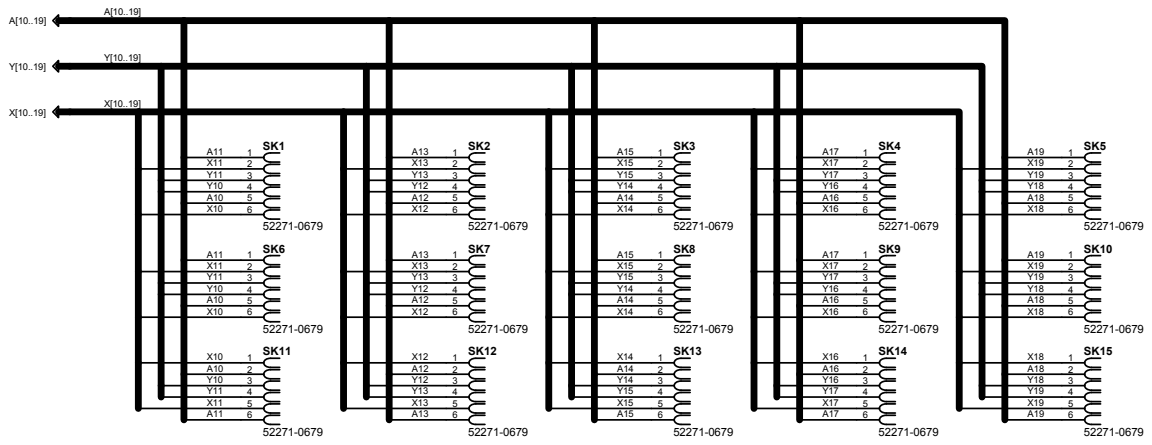
[picture p47: page 3]
FOR07/11/16

CCFE CULHAM CENTRE FUSION ENERGY

P | | Original | C Bower

Iss | Date | Status / Modification | Drawn | Checked | Approved | Mod No

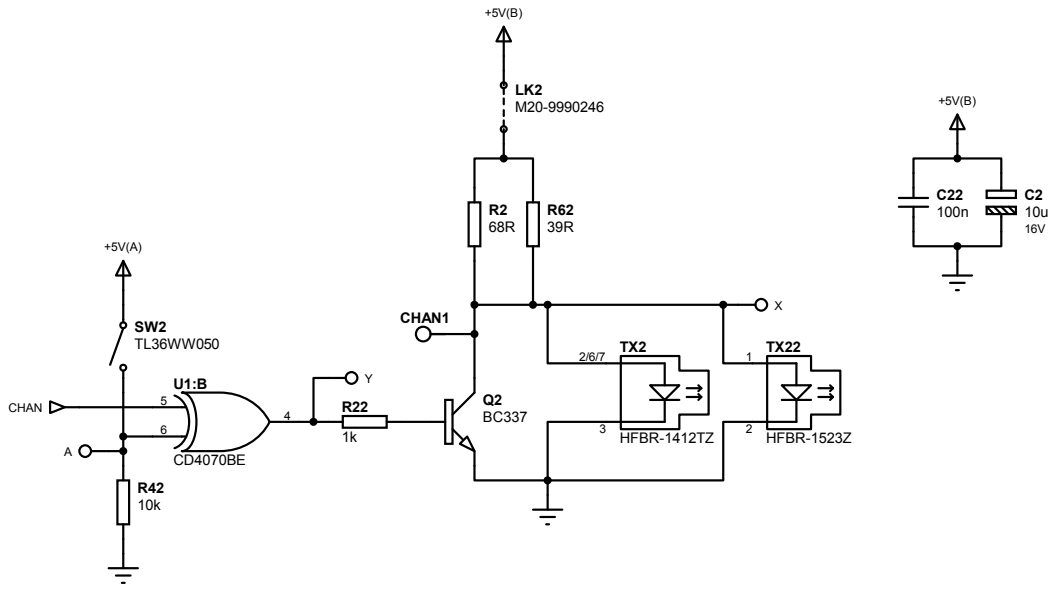
[picture p48: page 4]

CCFE CULHAM CENTRE FUSION ENERGY

P | | Original | C Bower

Iss | Date | Status / Modification | Drawn | Checked | Approved | Mod No

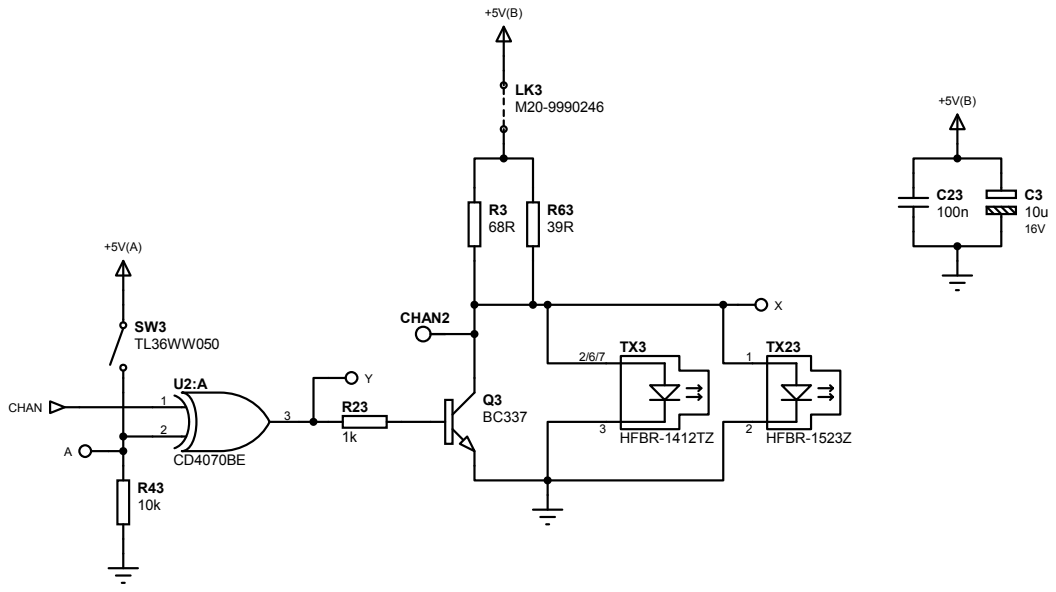
[picture p49: page 5]

CCFE CULHAM CENTRE FUSION ENERGY

P | | Original | C Bower

Iss | Date | Status / Modification | Drawn | Checked | Approved | Mod No

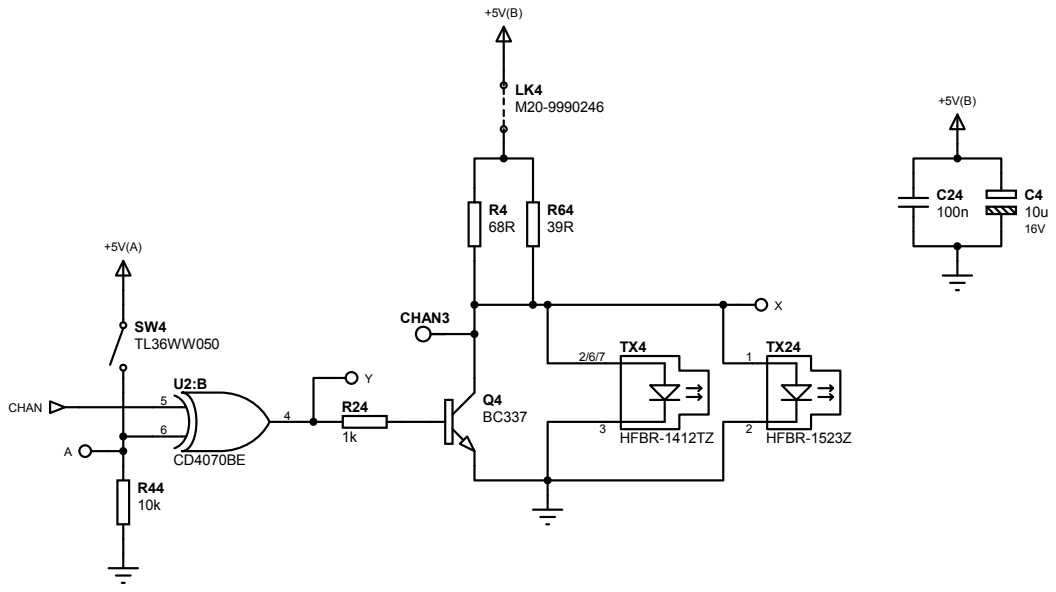
[picture p50: page 6]

CCFE CULHAM CENTRE FUSION ENERGY

P | | Original | C Bower

Iss | Date | Status / Modification | Drawn | Checked | Approved | Mod No

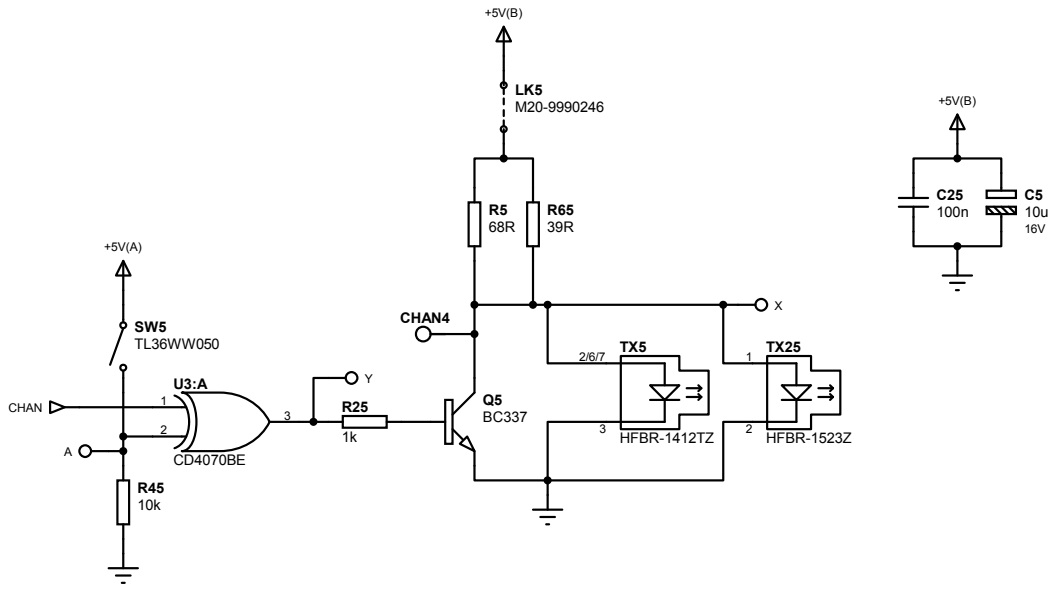
[picture p51: page 7]

CCFE CULHAM CENTRE FUSION ENERGY

P | | Original | C Bower

Iss | Date | Status / Modification | Drawn | Checked | Approved | Mod No

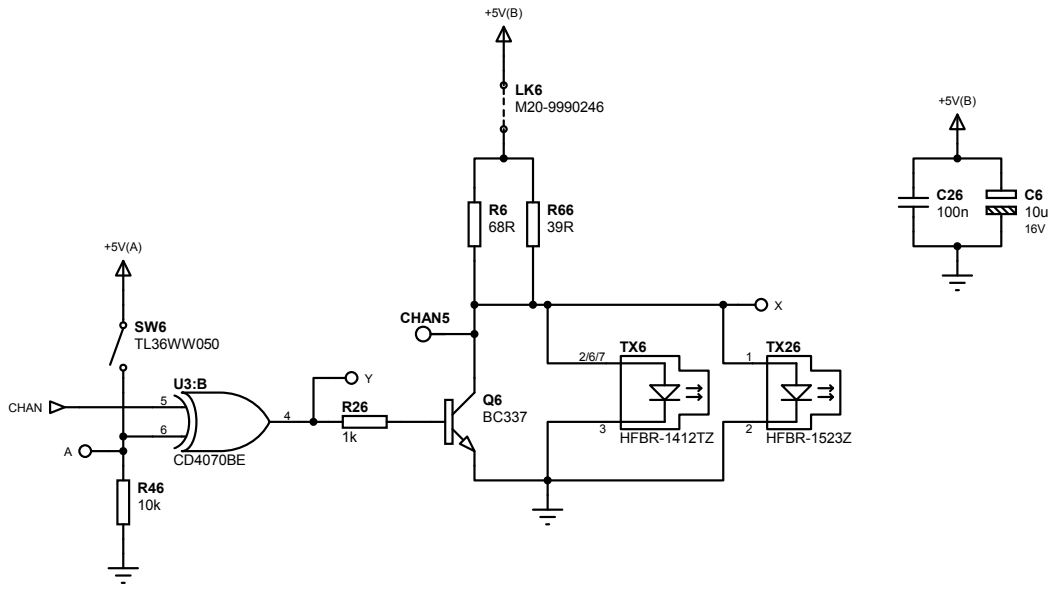
[picture p52: page 8]

CCFE CULHAM CENTRE FUSION ENERGY

P | | Original | C Bower

Iss | Date | Status / Modification | Drawn | Checked | Approved | Mod No

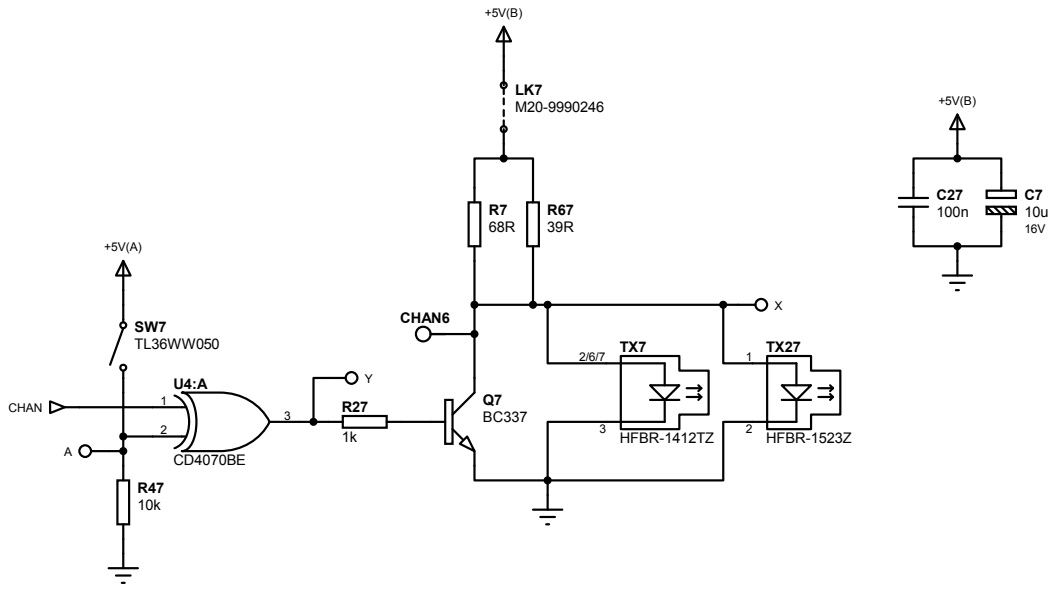
[picture p53: page 9]

CCFE CULHAM CENTRE FUSION ENERGY

P | | Original | C Bower

Iss | Date | Status / Modification | Drawn | Checked | Approved | Mod No

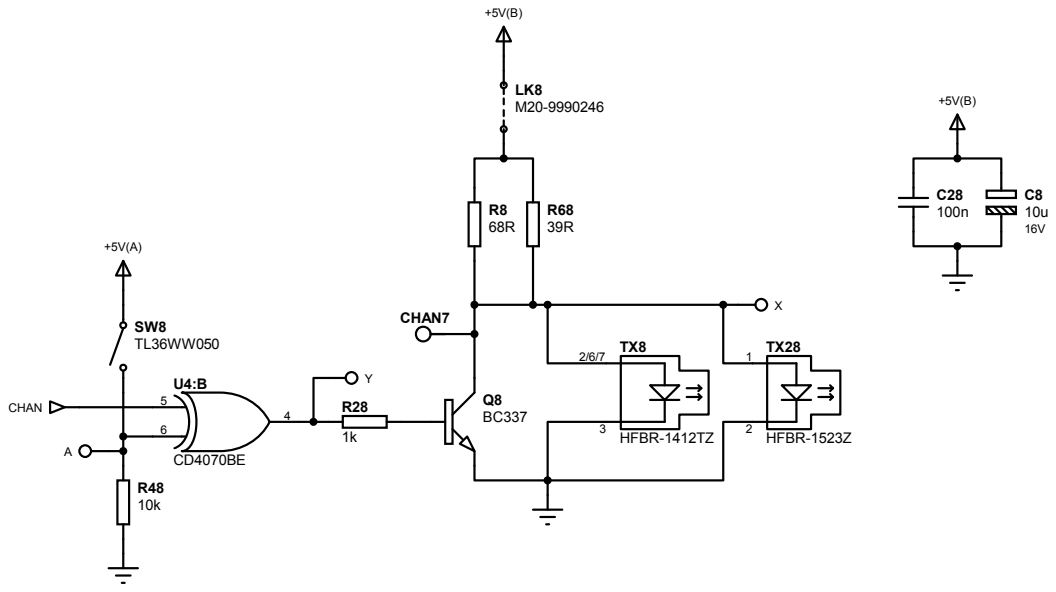
[picture p54: page 10]

CCFE CULHAM CENTRE FUSION ENERGY

P | | Original | C Bower

Iss | Date | Status / Modification | Drawn | Checked | Approved | Mod No

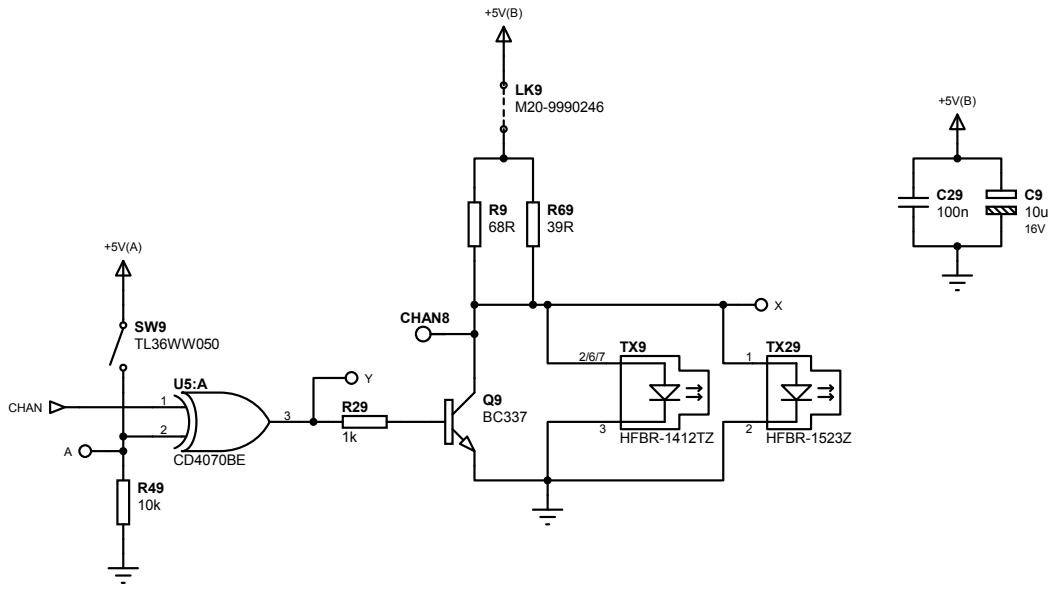
[picture p55: page 11]

CCFE CULHAM CENTRE FUSION ENERGY

P | | Original | C Bower

Iss | Date | Status / Modification | Drawn | Checked | Approved | Mod No

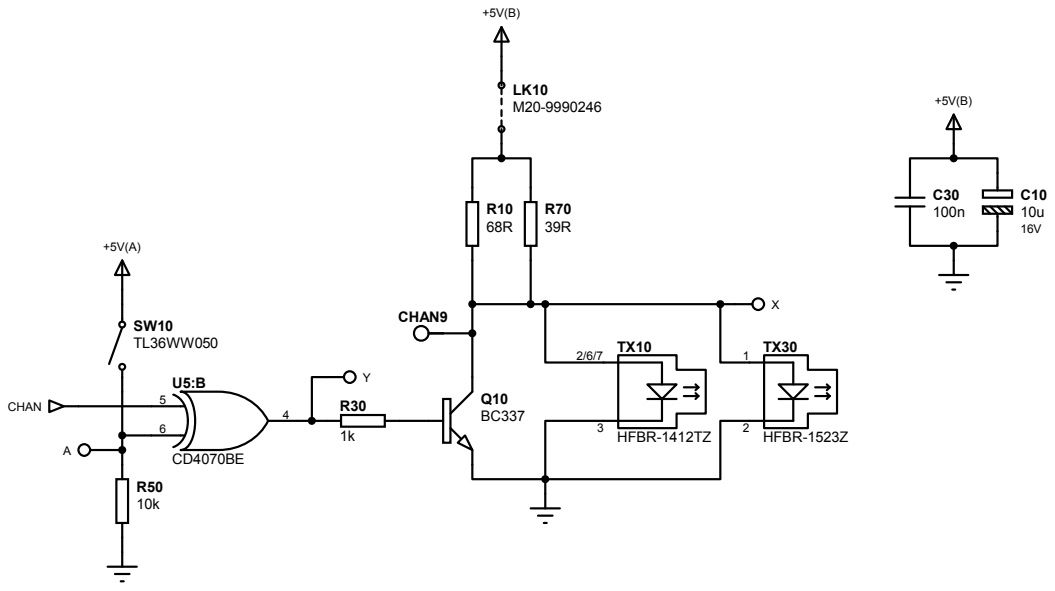
[picture p56: page 12]

CCFE CULHAM CENTRE FUSION ENERGY

P | | Original | C Bower

Iss | Date | Status / Modification | Drawn | Checked | Approved | Mod No

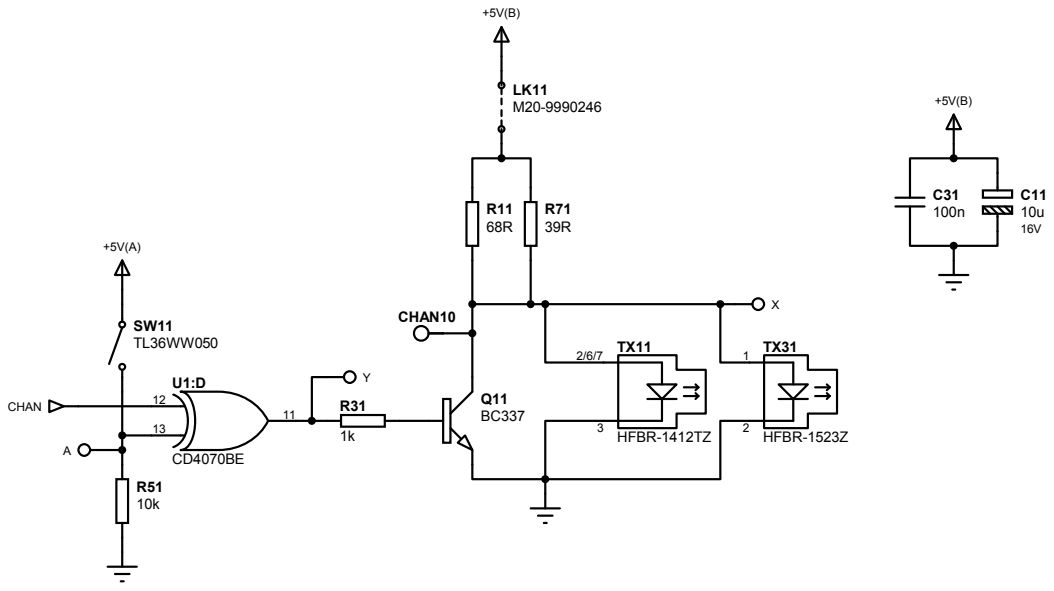
[picture p57: page 13]

CCFE CULHAM CENTRE FUSION ENERGY

P | | Original | C Bower

Iss | Date | Status / Modification | Drawn | Checked | Approved | Mod No

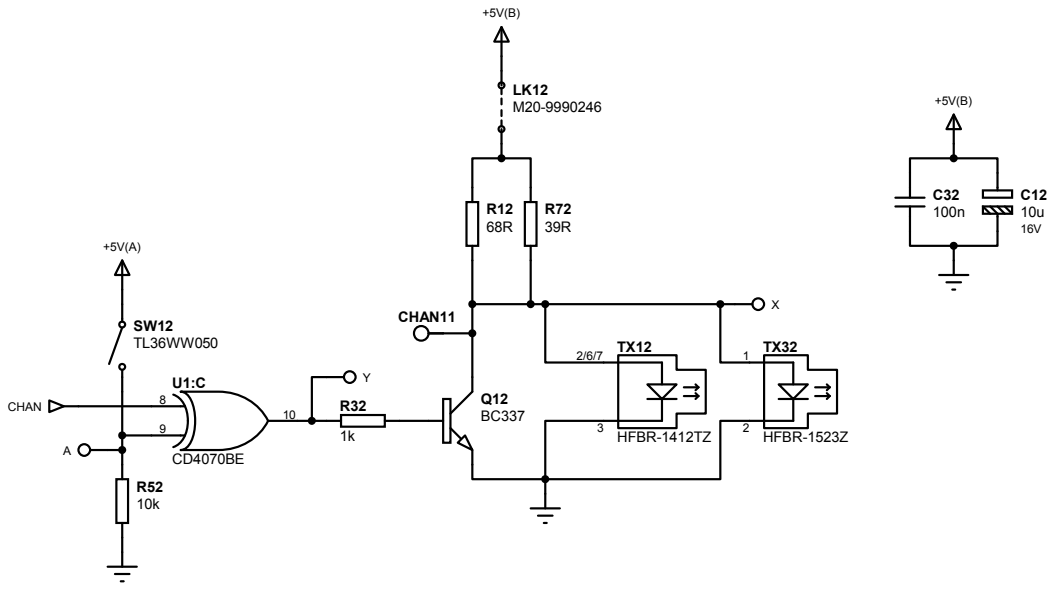
[picture p58: page 14]

CCFE CULHAM CENTRE FUSION ENERGY

P | | Original | C Bower

Iss | Date | Status / Modification | Drawn | Checked | Approved | Mod No

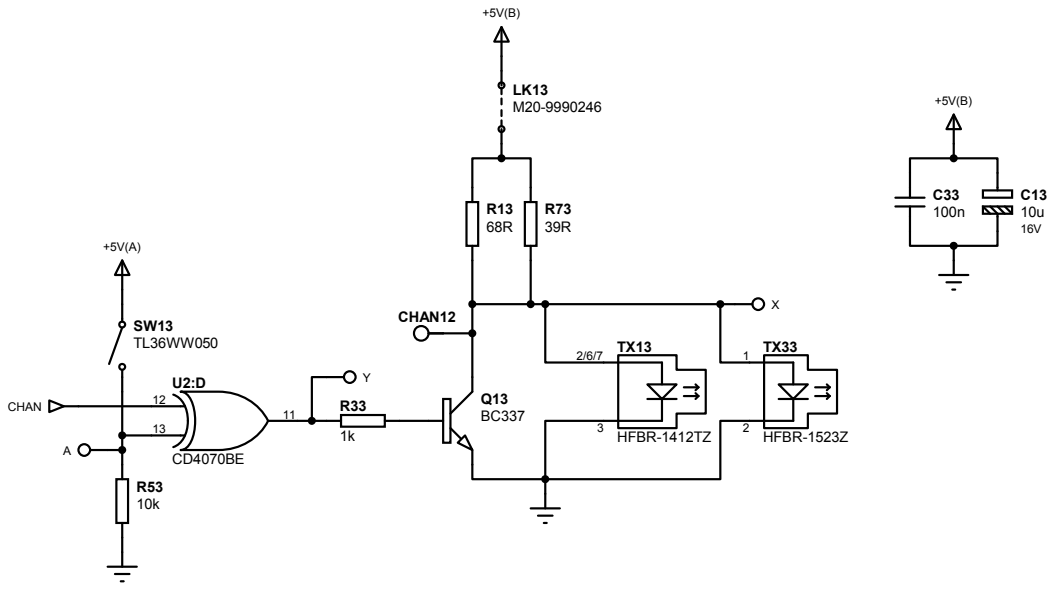
[picture p59: page 15]

CCFE CULHAM CENTRE FUSION ENERGY

P | | Original | C Bower

Iss | Date | Status / Modification | Drawn | Checked | Approved | Mod No

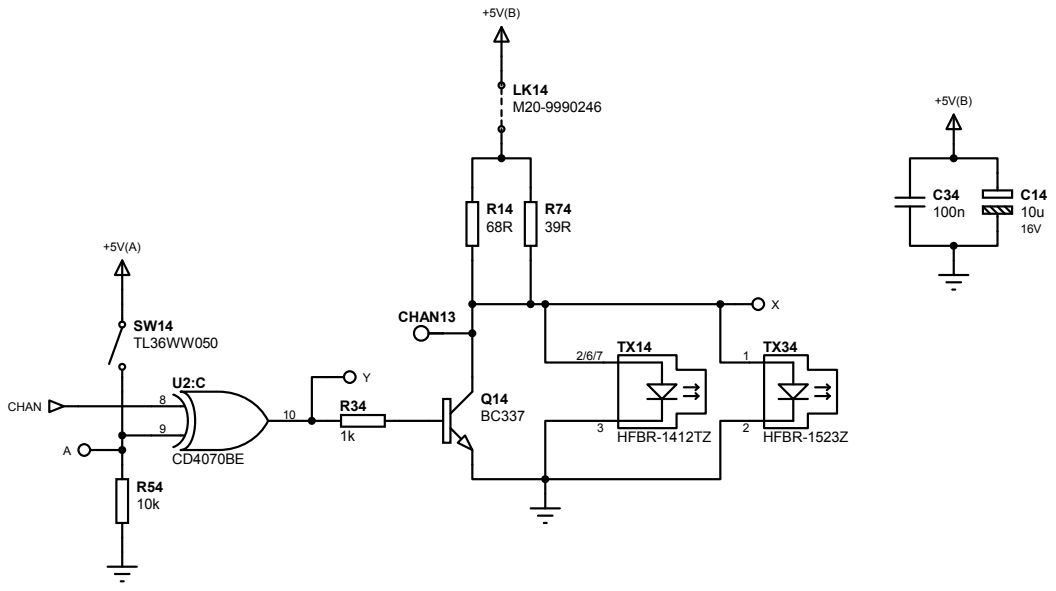
[picture p60: page 16]

CCFE CULHAM CENTRE FUSION ENERGY

P | | Original | C Bower

Iss | Date | Status / Modification | Drawn | Checked | Approved | Mod No

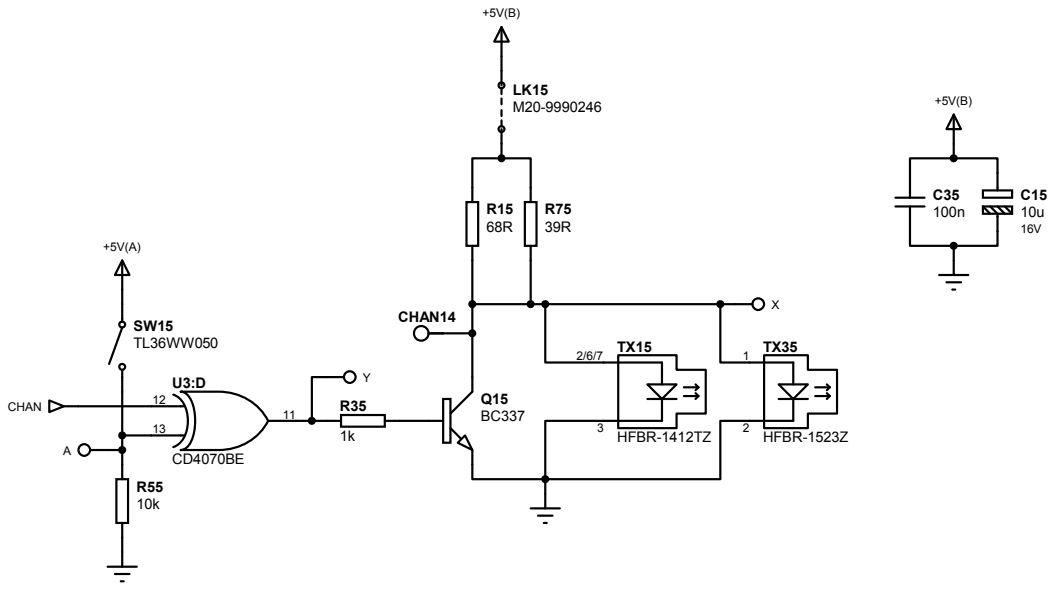
[picture p61: page 17]

CCFE CULHAM CENTRE FUSION ENERGY

P | | Original | C Bower

Iss | Date | Status / Modification | Drawn | Checked | Approved | Mod No

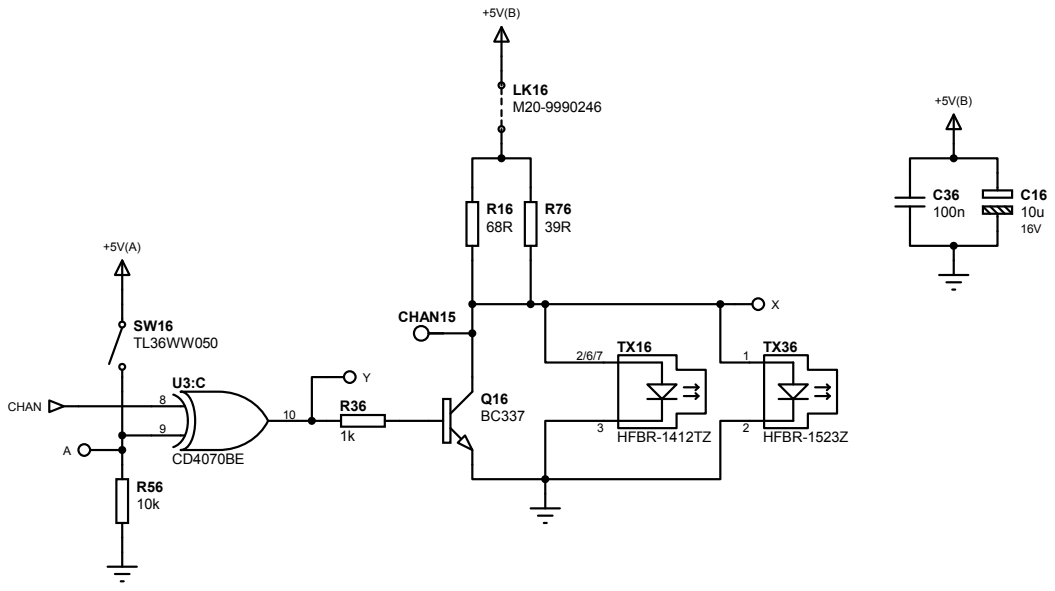
[picture p62: page 18]

CCFE CULHAM CENTRE FUSION ENERGY

P | | Original | C Bower

Iss | Date | Status / Modification | Drawn | Checked | Approved | Mod No

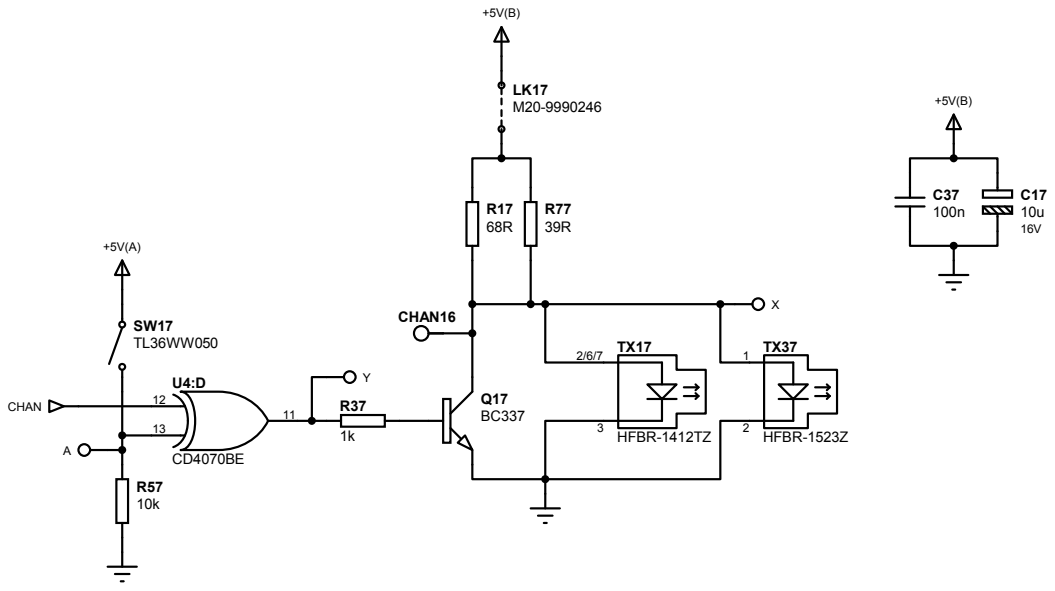
[picture p63: page 19]

CCFE CULHAM CENTRE FUSION ENERGY

P | | Original | C Bower

Iss | Date | Status / Modification | Drawn | Checked | Approved | Mod No

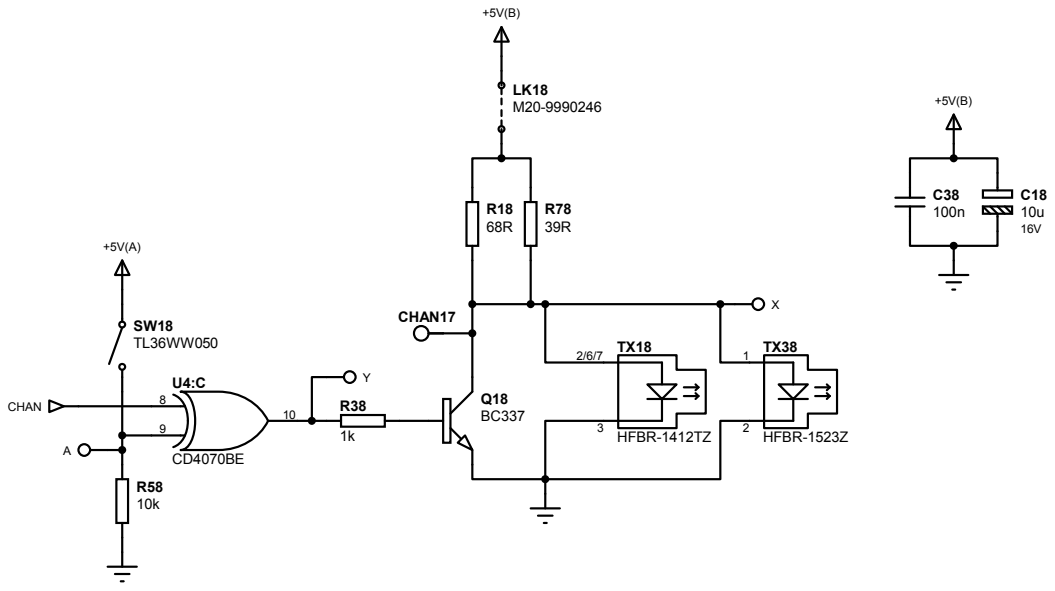
[picture p64: page 20]

CCFE CULHAM CENTRE FUSION ENERGY

P | | Original | C Bower

Iss | Date | Status / Modification | Drawn | Checked | Approved | Mod No

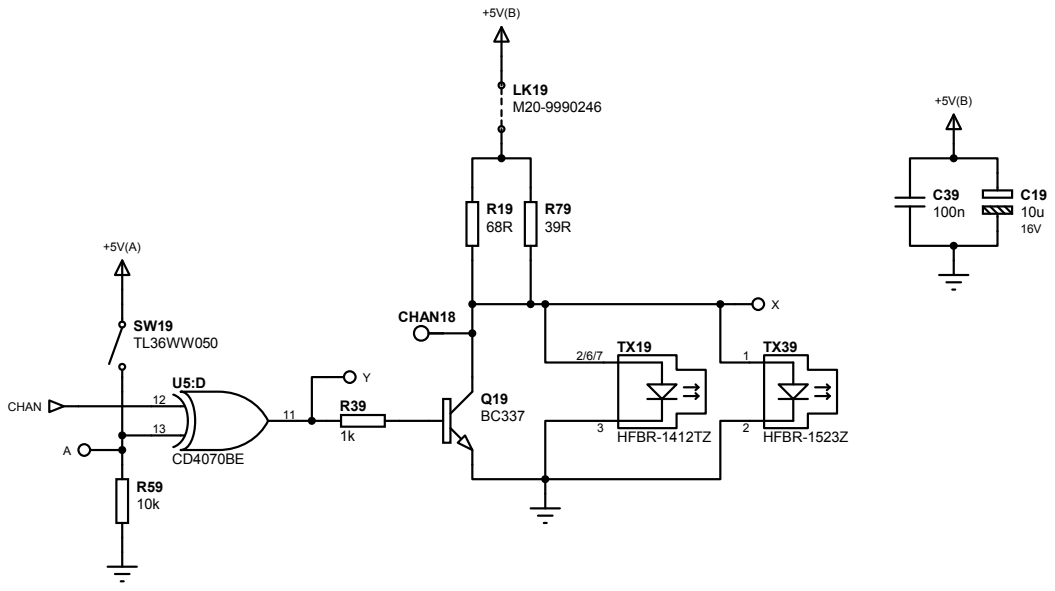
[picture p65: page 21]

CCFE CULHAM CENTRE FUSION ENERGY

P | | Original | C Bower

Iss | Date | Status / Modification | Drawn | Checked | Approved | Mod No

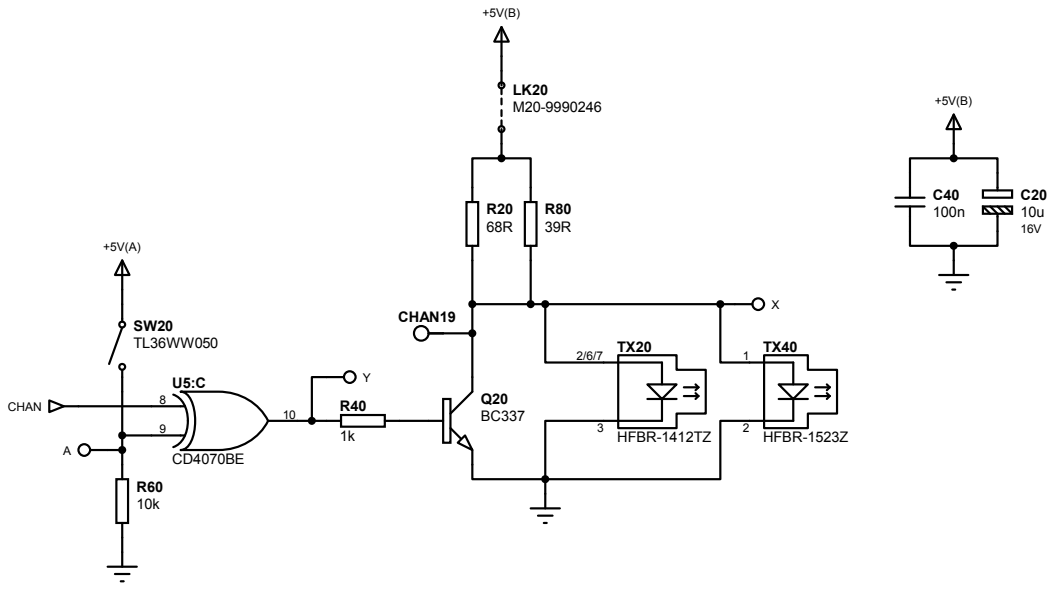
[picture p66: page 22]

CCFE CULHAM CENTRE FUSION ENERGY

P | | Original | C Bower

Iss | Date | Status / Modification | Drawn | Checked | Approved | Mod No
