enginebeat/TestBedUpgrade/CODAS/2278.pdf

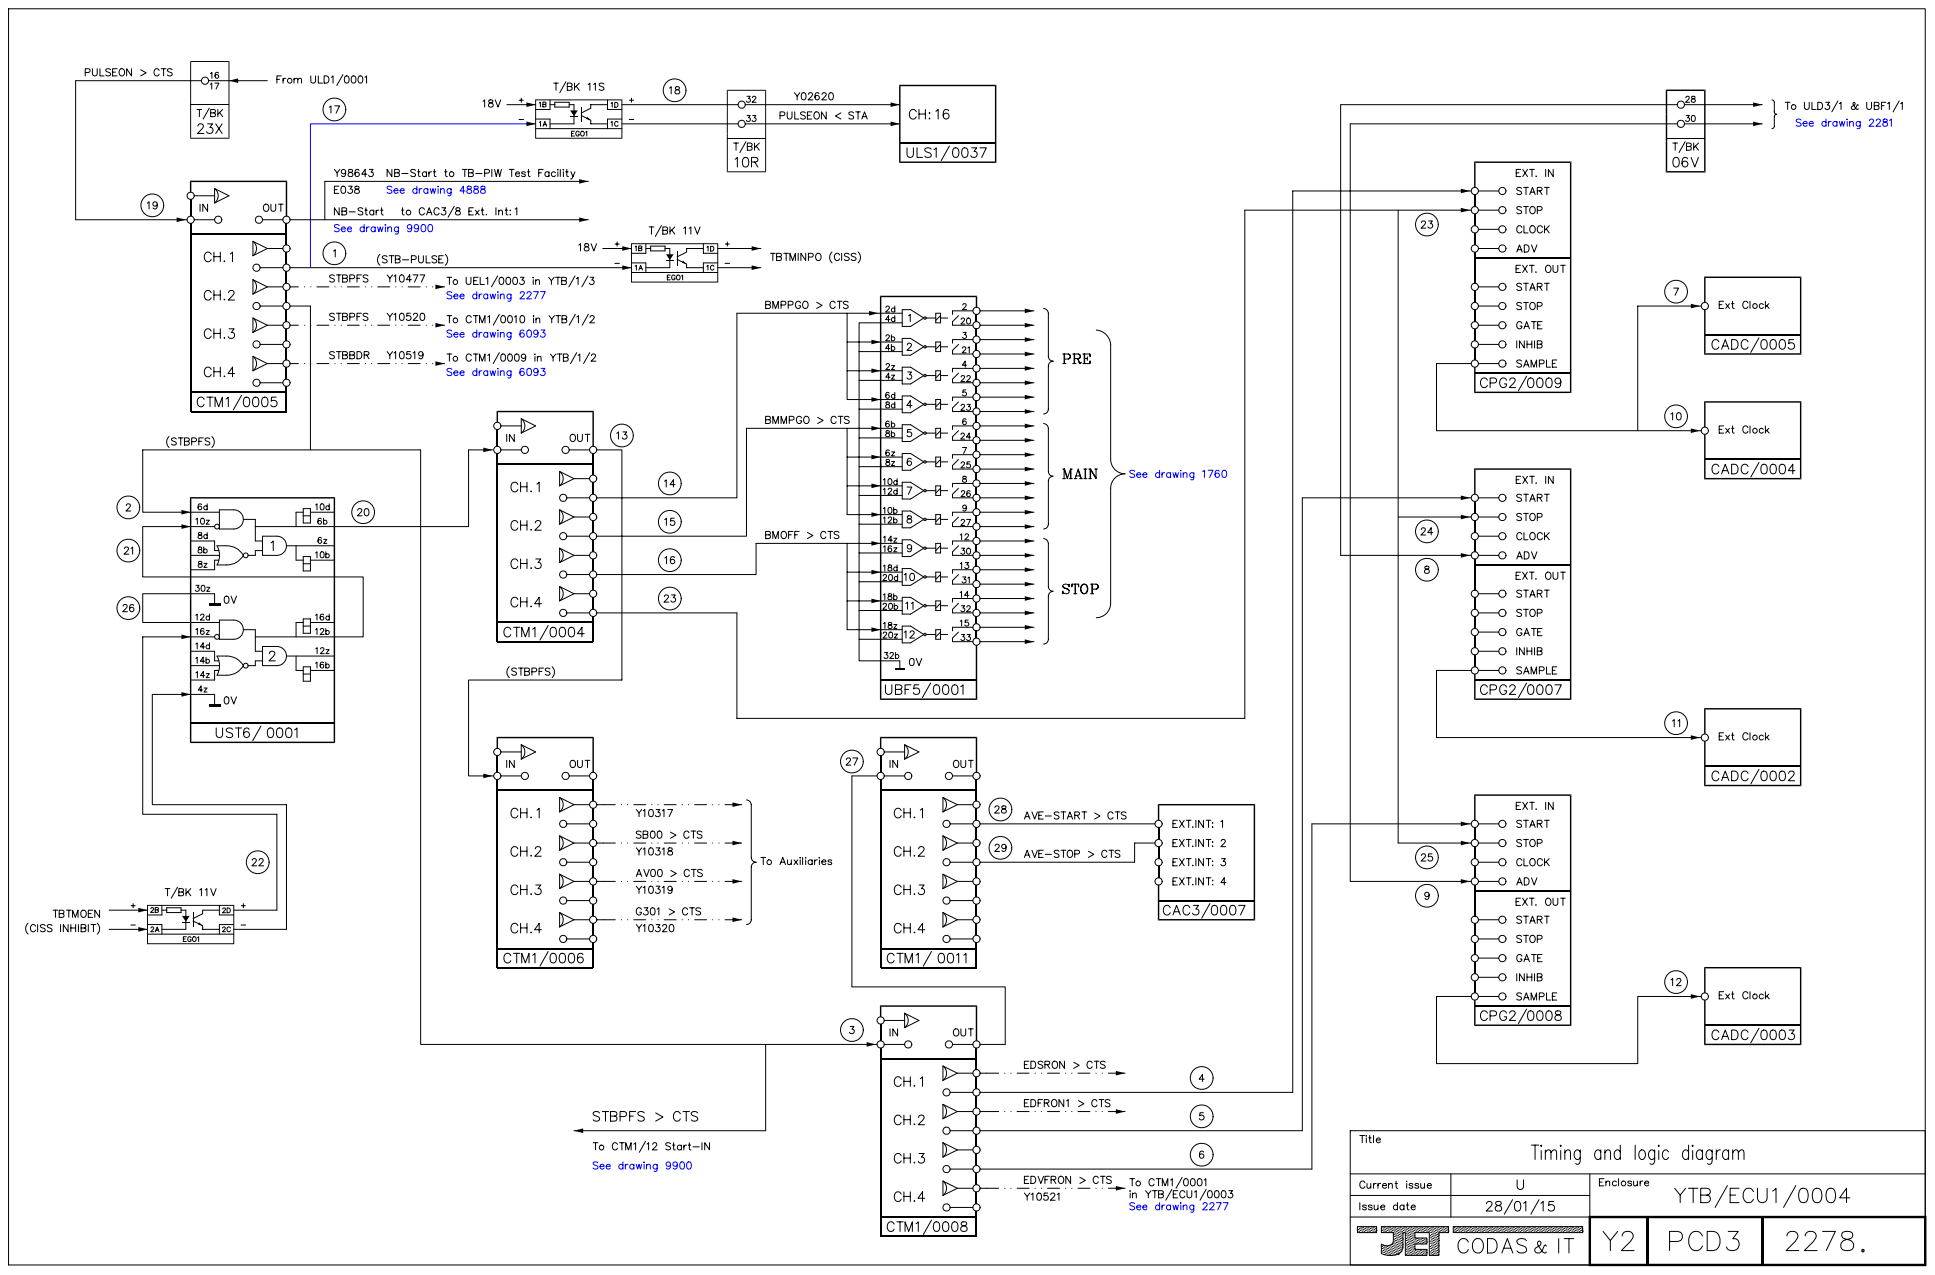
[picture p67: page 1]
EXT. OUT; EXT. IN; EDSRON > CTS; EDFRON1 > CTS; EDVFRON > CTS; To CTM1/0001 in YTB/ECU1/0003; TBTMINPO (CISS); Ext Clock; To ULD3/1 & UBF1/1; PULSEON > CTS; From ULD1/0001; PULSEON < STA; (CISS INHIBIT); BMOFF > CTS; BMMPGO > CTS; BMPPGO > CTS; G301 > CTS; AV00 > CTS; SB00 > CTS; To Auxiliaries; NB-Start; to CAC3/8 Ext. Int:1; See drawing 9900; STBPFS > CTS; See drawing 1760; See drawing 2281; See drawing 4888; See drawing 2277

Y98643 NB-Start to TB-PIW Test Facility | 1A | EGO1 | 1C

To UEL1/0003 in YTB/1/3
See drawing 2277 (http://w3.jet.efda.org/CODAS/drawings/2277.pdf)

To CTM1/0010 in YTB/1/2
See drawing 6093 (http://w3.jet.efda.org/CODAS/drawings/6093.pdf)

To CTM1/0009 in YTB/1/2

AVE-START > CTS

AVE-STOP > CTS

To CTM1/12 Start-IN

Timing and logic diagram

Current issue

Issue date | 28/01/15
