enginebeat/TestBedUpgrade/fibreDistrBox/16_3_patchPanel Drawing v1.pdf

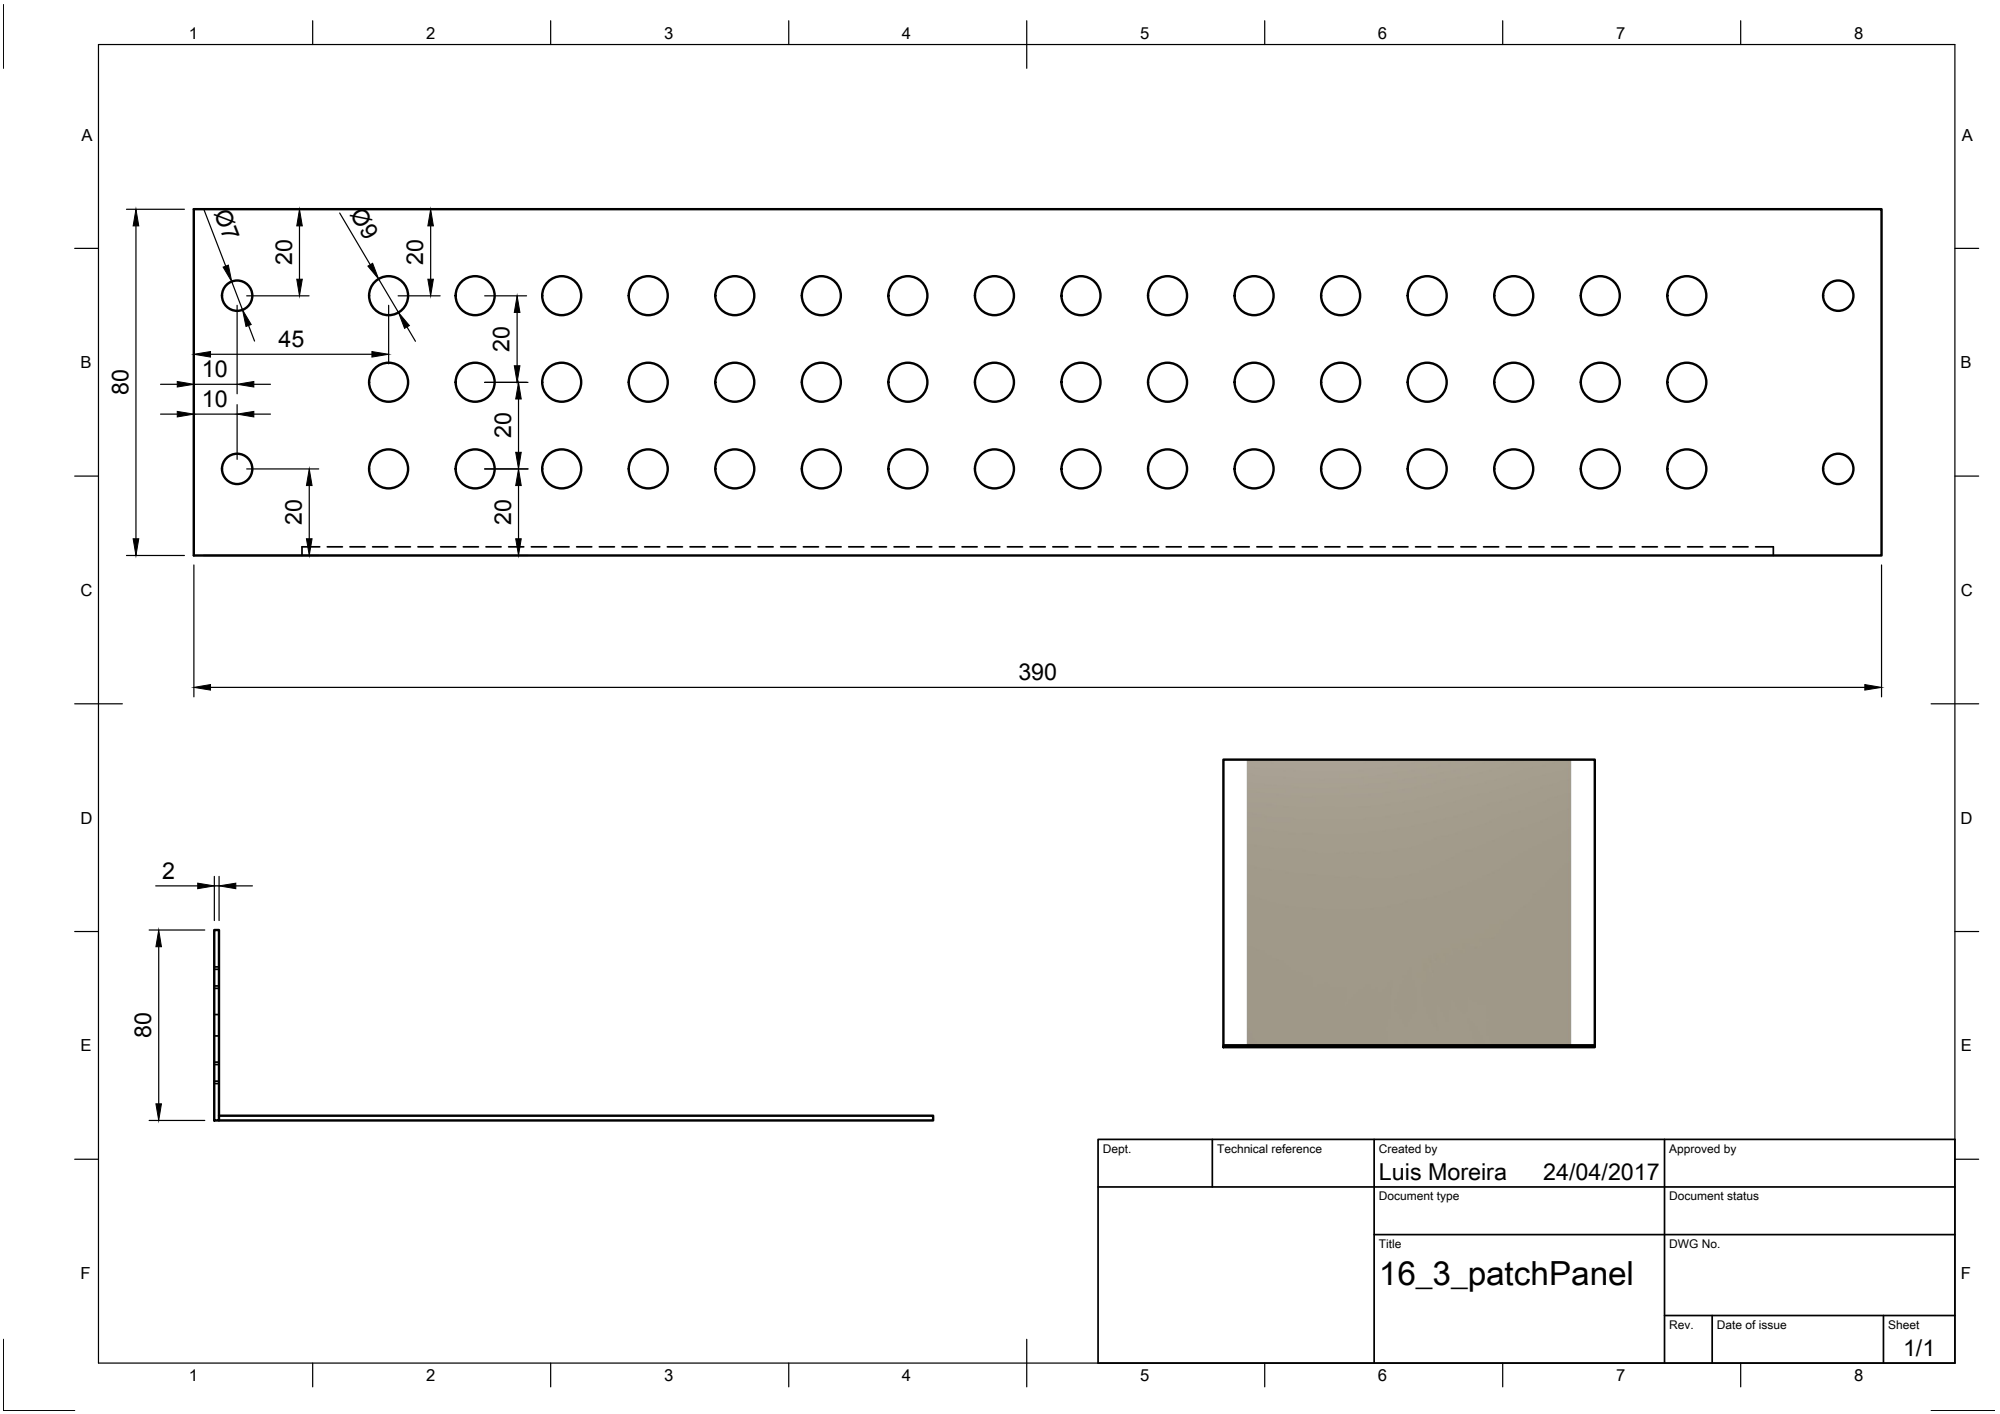
[picture p68: page 1]

Dept. | Technical reference | Created by Luis Moreira 24/04/2017 | Approved by

Document type | Document status

Title 16_3_patchPanel | DWG No.

Rev. | Date of issue | Sheet 1/1
