enginebeat/TestBedUpgrade/fibreDistrBox/AuxDecksFO.pdf

## PATCH 1

## PATCH 2

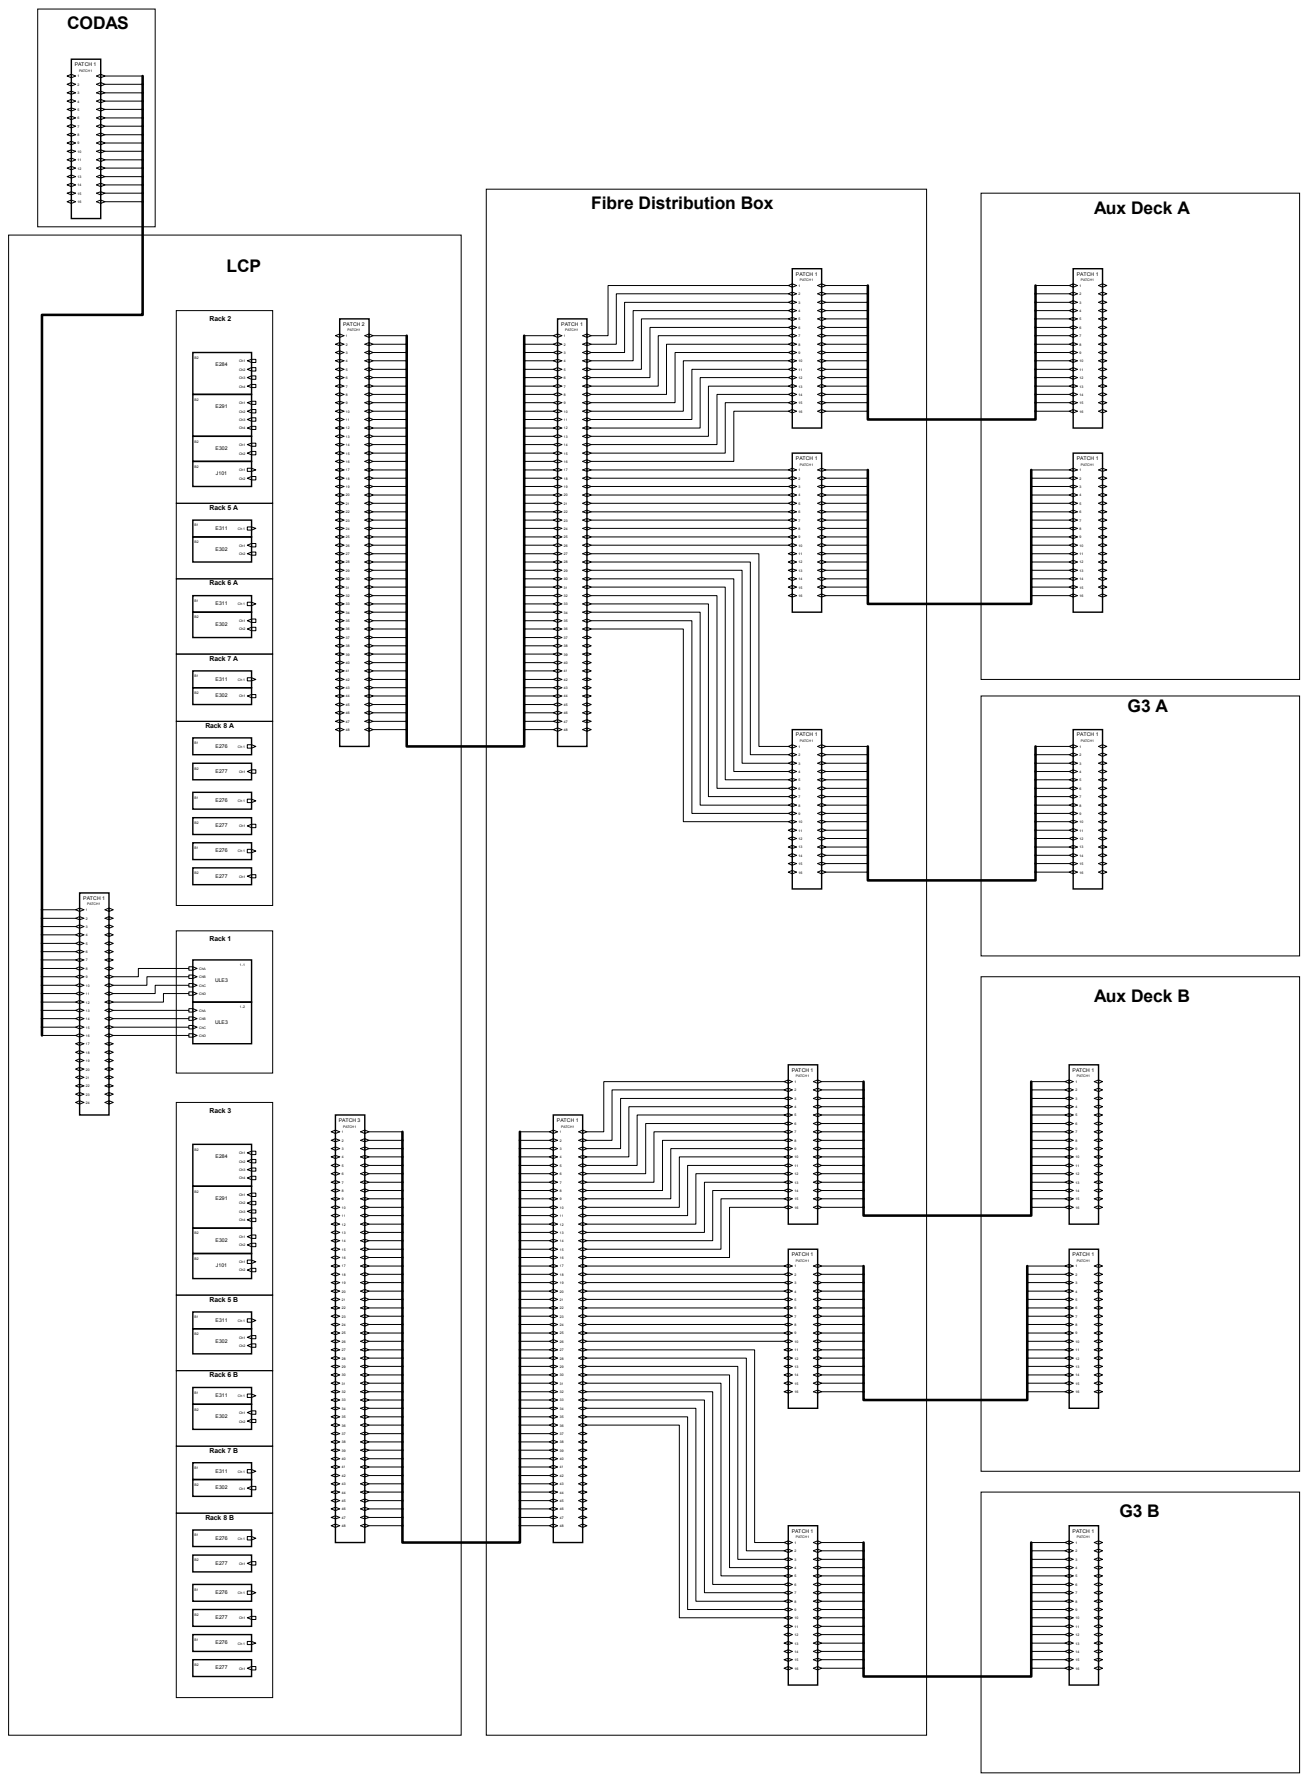
[picture p69: page 1]
PATCH1; PATCH 1; LCP; Aux Deck A; Aux Deck B; Rack 8 A; Rack 2; Rack 5 A; Rack 6 A; Rack 7 A; Rack 8 B; Rack 3; Rack 5 B; Rack 6 B; Rack 7 B; PATCH 3; ULE3; ChA; ChB; ChC; ChD; CODAS; Rack 1

Fibre Distribution Box
